tc-grupo-4/TP--FINAL/README.md

# TP--FINAL
TP FINAL de Teoría de Circuitos 2c 2019
