tc-grupo-4/TP--FINAL/Informe/2-sintesis.tex

\chapter{Síntesis de las Etapas}

Para las etapas de pasa altos, se utilizaron filtros KHN y para las etapas de pasa bajos se utilizaron filtros Sallen-Key.

¿Criterio para la síntesis de cada etapa?

¿Criterio para el orden de las etapas?

\section{Pasa Altos KHN}

\begin{figure}[ht]
\begin{center}
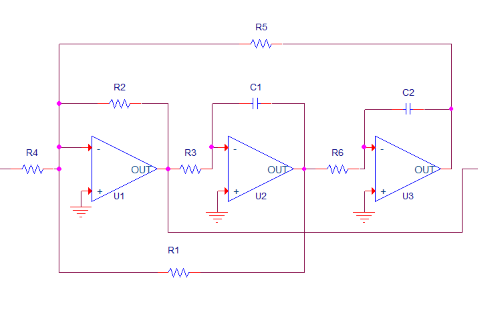
[picture p8: Diseño/publish/Stages Schematics/KHN_HP.PNG]

\caption{Arquitectura del Filtro KHN Pasa Altos}
\end{center}
\end{figure}

\section{Pasa Bajos Sallen-Key}

\begin{figure}[ht]
\begin{center}
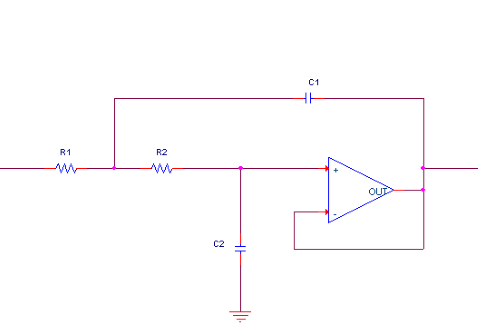
[picture p9: Diseño/publish/Stages Schematics/SK_LP.PNG]

\caption{Arquitectura del Filtro Sallen-Key Pasa Bajos}
\end{center}
\end{figure}
