tc-grupo-4/TP--FINAL/Informe/Caratula.tex

%\documentclass[12pt,a4paper]{article}
%\usepackage[utf8]{inputenc}
%\usepackage[siunitx,american]{circuitikz}
%\usepackage{pgfplots}
%\usepackage[margin=0.5in]{geometry}
%\usepackage{textcomp}
%\usepackage[spanish, es-tabla]{babel}
%\usepackage{amsmath}
%\usepackage{graphicx}
%\usepackage[colorinlistoftodos]{todonotes}
%\usepackage{amsmath}
%\usepackage{tikz}
%%%

%\usepackage{parskip}
%\usepackage{fancyhdr}
%\usepackage{vmargin}
%\setmarginsrb{3 cm}{2.5 cm}{3 cm}{2.5 cm}{1 cm}{1.5 cm}{1 cm}{1.5 cm}

%\pgfplotsset{compat=1.15}

%\begin{document}

\begin{titlepage}
\newcommand{\HRule}{\rule{\linewidth}{0.5mm}} % Defines a new command for the horizontal lines, change thickness here

\center
% Center everything on the page
 %----------------------------------------------------------------------------------------
%	LOGO SECTION
%----------------------------------------------------------------------------------------

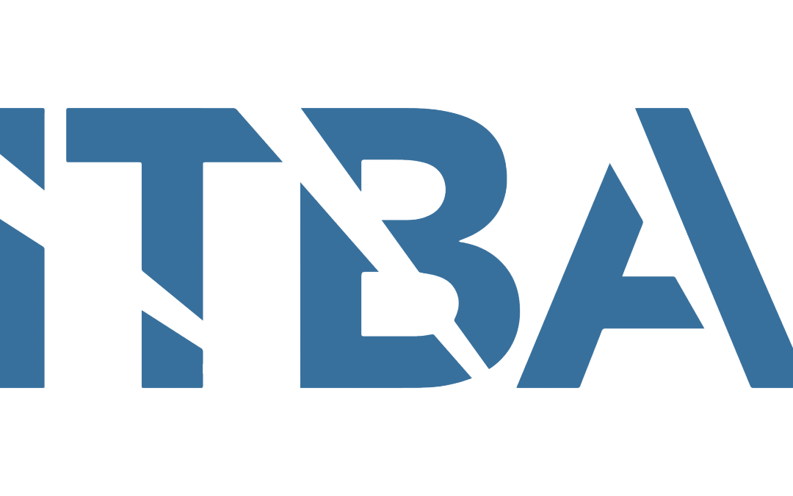
[picture p10: Informe/Resources/itba.png]
\\[1cm] % Include a department/university logo - this will require the graphicx package
 
%----------------------------------------------------------------------------------------
%----------------------------------------------------------------------------------------
%	HEADING SECTIONS
%----------------------------------------------------------------------------------------

\textsc{\Large INSTITUTO TECNOLÓGICO \\DE \\[0.3cm]BUENOS AIRES }\\[0.6cm] % Name of your university/college

\textsc{\Large Ingeniería Electrónica }\\[0.3cm]
\textsc{\large 22.01 - Teoría de Circuitos}\\[0.5cm] % Major heading such as course name
 % Minor heading such as course title

%----------------------------------------------------------------------------------------
%	TITLE SECTION
%----------------------------------------------------------------------------------------

\HRule \\[0.4cm]
{ \huge \bfseries TRABAJO PRÁCTICO FINAL\\ [0.3cm]}

\HRule \\[1.5cm]

%----------------------------------------------------------------------------------------
%	AUTHOR SECTION
%----------------------------------------------------------------------------------------

\begin{minipage}{0.4\textwidth}
\begin{flushleft} \large
\emph{Grupo 4:}\\
Álvarez, Lisandro \\Fogg, Matias\\ Diaz, Ian\\Delgado, Milton\\Dieguez, Manuel\\Oh, Victor % Your name
\end{flushleft}
\end{minipage}
~
\begin{minipage}{0.4\textwidth}
\begin{flushright} \large
\emph{Legajos:} \\
57771\\56252\\57515\\56451\\56273\\56679 
\end{flushright}
\end{minipage}\\[1cm]

 \begin{flushleft}
\textsc{\large Aprobado en fecha:  \dotfill}\\[0.5cm] 

% If you don't want a supervisor, uncomment the two lines below and remove the section above
%\Large \emph{Author:}\\
%John \textsc{Smith}\\[3cm] % Your name

%----------------------------------------------------------------------------------------
%	DATE SECTION
%----------------------------------------------------------------------------------------
\textsc{\large Entregado el \today}\\
% Date, change the \today to a set date if you want to be precise
 \end{flushleft}

\vfill % Fill the rest of the page with whitespace

\end{titlepage}

%\end{document}
