tc-grupo-4/TP--FINAL/Informe/TP_FINAL_G4.tex

\input{preamble.tex}

\begin{document}

\input{Caratula.tex}
\tableofcontents

\input{0-consigna.tex}

\input{1-diseno.tex}

\input{2-sintesis.tex}
\input{3-sensibilidad.tex}
\input{4-pcb.tex}
\input{5-resultados.tex}
\input{6-rangodinamico.tex}
\input{7-carga.tex}
\input{8-estabilidad.tex}

\end{document}
