tc-grupo-4/TP--FINAL/Diseño/publish/Publication.html

- Credits

# SUMMARY OF FILTER

# by Analog Filter Pro

# Bandpass Chebyshev I

# Filter Characteristics



Filter Properties
Gain [dB] | Fa⁻ [Hz] | Fp⁻ [Hz] | Fp⁺ [Hz] | Fa⁺ [Hz] | Aa [dB] | Ap [dB] | Order
5.000000e-01 | 615 | 2.07k | 12.07k | 40.62k | 50 | 5.000000e-01 | 4

# Attenuation Plot:



# Gain Plot:

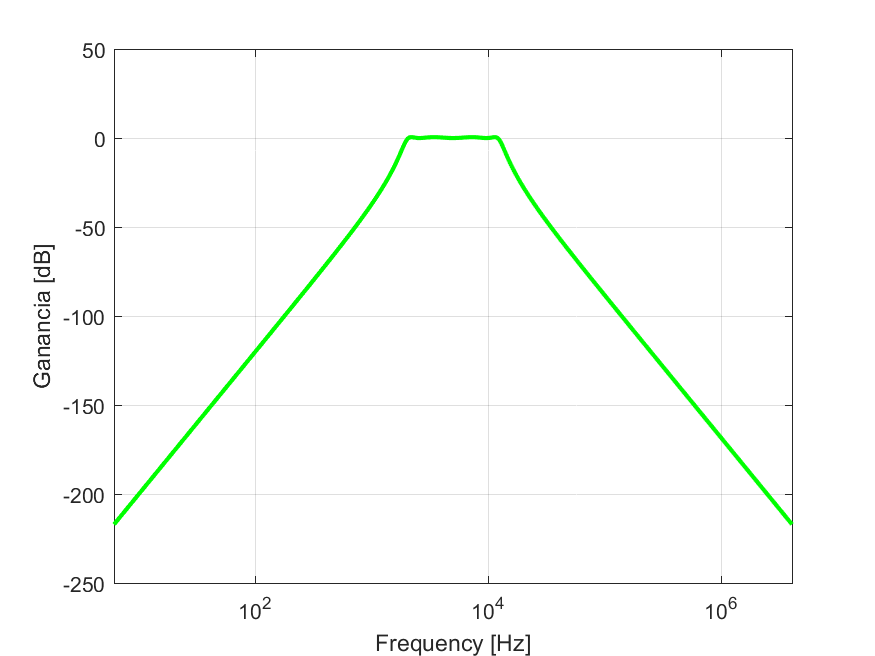
[picture p11: Diseño/publish/Filter_Mag.png]


# Phase Plot:



# Group Delay:

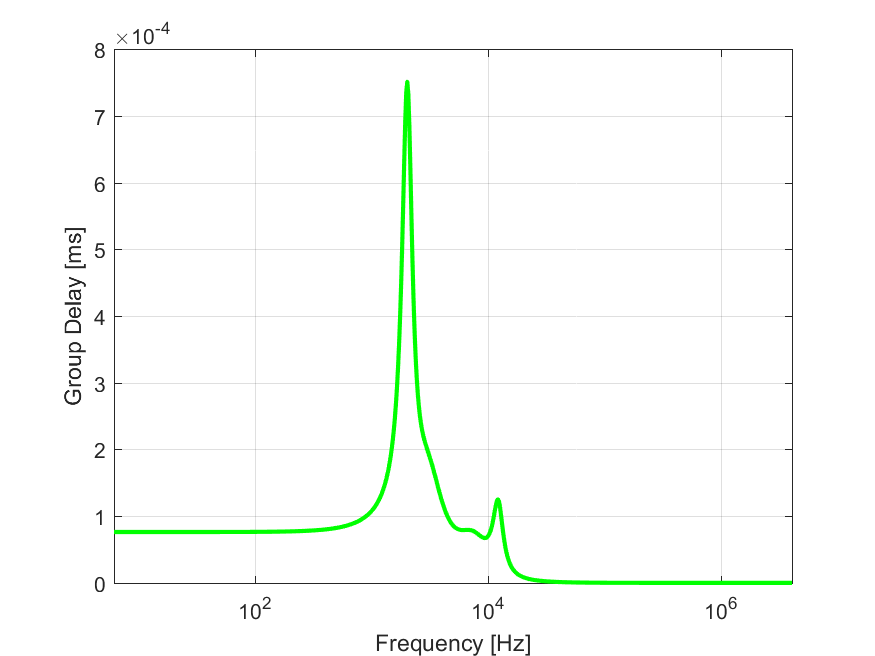
[picture p12: Diseño/publish/Filter_GroupDelay.png]


# Step Response:

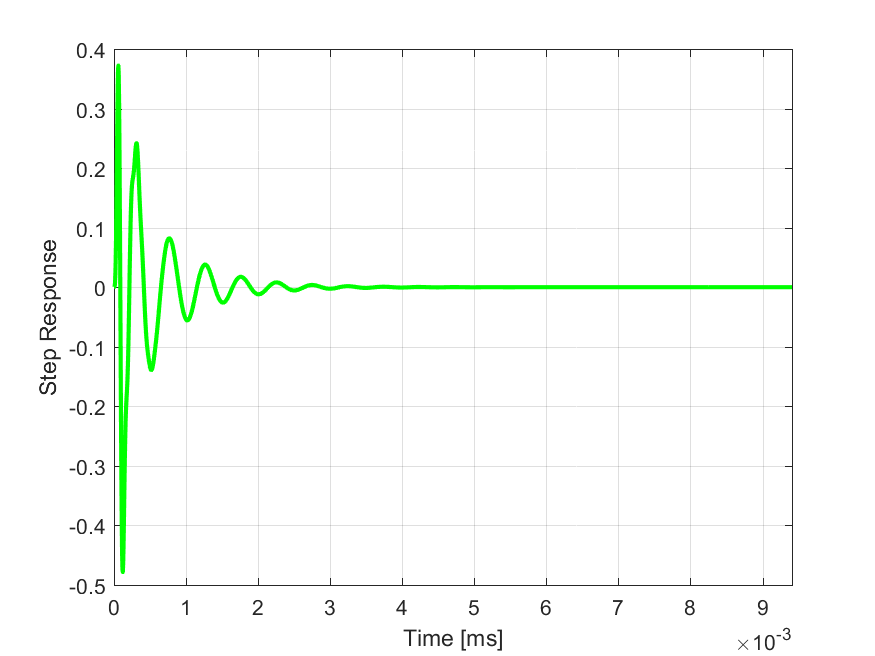
[picture p13: Diseño/publish/Filter_StepResponse.png]


# Impulse Response:

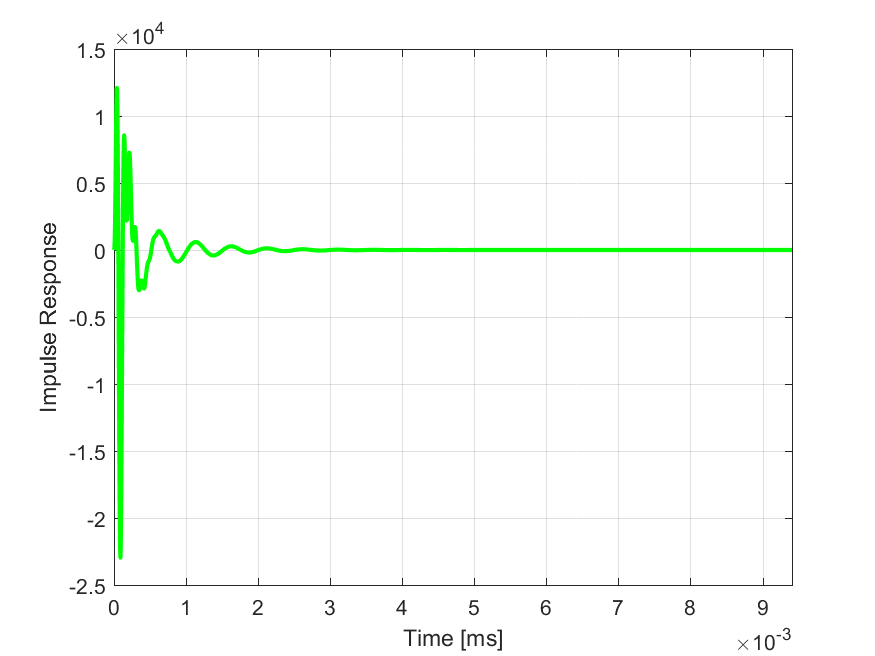
[picture p14: Diseño/publish/Filter_ImpulseResponse.png]


# Stage Nº1: KHN High Pass



Stage Properties
Type | Order | f0 [Hz] | Gain [dB] | Q | Dinamic Range [dB]
HighPass | 2 | 2k | 2 | 4.08

# Stage Attenuation:



# Calculated components for the specified filter:

Components
Resistor [Ω] | | | | | | Capacitor [F]
R1 | R2 | R3 | R4 | R5 | R6 | C1 | C2
781.55 | 191.51 | 90.3M | 100k | 781.55 | 90.3M | 100n | 100n

# Approximation of the components with commercial values:

Components with commercial values
| | Combination | Result | Error

Resistor
| R1 | 100Ω + 680Ω | 780Ω | 0.2%
| R2 | 220Ω // 1.5kΩ | 191.86Ω | 0.2%
| R3 | 2.2MΩ + 2.2MΩ | 4.4MΩ | 95.1%
| R4 | 100kΩ | 100kΩ | 0.0%
| R5 | 100Ω + 680Ω | 780Ω | 0.2%
| R6 | 2.2MΩ + 2.2MΩ | 4.4MΩ | 95.1%

Capacitor
| C1 | 100nF | 100nF | 0.0%
| C2 | 100nF | 100nF | 0.0%

# Sensitivity of each component:

Sensitivities
| SXG | SXQ | SXWp
R1 | 0.50 | 1.50 | -0.50
R2 | 0.00 | -1.00 | 0.00
R3 | -0.50 | 0.00 | 0.00
R4 | 0.50 | 0.00 | 0.00
R5 | 0.50 | -0.50 | -0.50
R6 | -0.50 | 0.00 | 0.00
C1 | 0.00 | 0.00 | -0.50
C2 | 0.00 | -0.50 | -0.50

# Stage Nº2: KHN High Pass



Stage Properties
Type | Order | f0 [Hz] | Gain [dB] | Q | Dinamic Range [dB]
HighPass | 2 | 12.3k | 2 | 4.08

# Stage Attenuation:



# Calculated components for the specified filter:

Components
Resistor [Ω] | | | | | | Capacitor [F]
R1 | R2 | R3 | R4 | R5 | R6 | C1 | C2
129.65 | 31.77 | 221.7M | 100k | 129.65 | 221.7M | 100n | 100n

# Approximation of the components with commercial values:

Components with commercial values
| | Combination | Result | Error

Resistor
| R1 | 10Ω + 120Ω | 130Ω | 0.3%
| R2 | 33Ω // 820Ω | 31.72Ω | 0.1%
| R3 | 2.2MΩ + 2.2MΩ | 4.4MΩ | 98.0%
| R4 | 100kΩ | 100kΩ | 0.0%
| R5 | 10Ω + 120Ω | 130Ω | 0.3%
| R6 | 2.2MΩ + 2.2MΩ | 4.4MΩ | 98.0%

Capacitor
| C1 | 100nF | 100nF | 0.0%
| C2 | 100nF | 100nF | 0.0%

# Sensitivity of each component:

Sensitivities
| SXG | SXQ | SXWp
R1 | 0.50 | 1.50 | -0.50
R2 | 0.00 | -1.00 | 0.00
R3 | -0.50 | 0.00 | 0.00
R4 | 0.50 | 0.00 | 0.00
R5 | 0.50 | -0.50 | -0.50
R6 | -0.50 | 0.00 | 0.00
C1 | 0.00 | 0.00 | -0.50
C2 | 0.00 | -0.50 | -0.50

# Stage Nº3: SK Low Pass

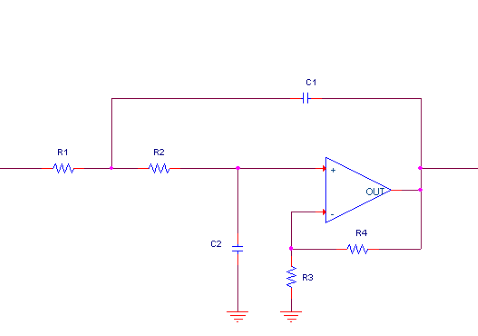
[picture p15: Diseño/publish/Stages Schematics/SK_LP_G.PNG]


Stage Properties
Type | Order | f0 [Hz] | Gain [dB] | Q | Dinamic Range [dB]
LowPass | 2 | 3.2k | 2 | 1.30

# Stage Attenuation:



# Calculated components for the specified filter:

Components
Resistor [Ω] | | | | Capacitor [F]
R1 | R2 | R3 | R4 | C1 | C2
100k | 100k | 1k | 569.32 | 651.56p | 376.16p

# Approximation of the components with commercial values:

Components with commercial values
| | Combination | Result | Error

Resistor
| R1 | 100kΩ | 100kΩ | 0.0%
| R2 | 100kΩ | 100kΩ | 0.0%
| R3 | 1kΩ | 1kΩ | 0.0%
| R4 | 10Ω + 560Ω | 570Ω | 0.1%

Capacitor
| C1 | 680pF + 15nF | 650.51pF | 0.2%
| C2 | 390pF + 10nF | 375.36pF | 0.2%

# Sensitivity of each component:

Sensitivities
| SXG | SXQ | SXWp
R1 | 0.00 | 0.49 | -0.50
R2 | 0.00 | -0.49 | -0.50
R3 | -0.36 | -0.97 | 0.00
R4 | 0.36 | 0.97 | 0.00
C1 | 0.00 | 1.47 | -0.50
C2 | 0.00 | -1.47 | -0.50

# Stage Nº4: SK Low Pass



Stage Properties
Type | Order | f0 [Hz] | Gain [dB] | Q | Dinamic Range [dB]
LowPass | 2 | 7.8k | 2 | 1.30 | 54.3

# Stage Attenuation:



# Calculated components for the specified filter:

Components
Resistor [Ω] | | | | Capacitor [F]
R1 | R2 | R3 | R4 | C1 | C2
100k | 100k | 1k | 569.32 | 269.37p | 155.51p

# Approximation of the components with commercial values:

Components with commercial values
| | Combination | Result | Error

Resistor
| R1 | 100kΩ | 100kΩ | 0.0%
| R2 | 100kΩ | 100kΩ | 0.0%
| R3 | 1kΩ | 1kΩ | 0.0%
| R4 | 10Ω + 560Ω | 570Ω | 0.1%

Capacitor
| C1 | 270pF + 120nF | 269.39pF | <0,1%
| C2 | 5.6pF // 150pF | 155.6pF | <0,1%

# Sensitivity of each component:

Sensitivities
| SXG | SXQ | SXWp
R1 | 0.00 | 0.49 | -0.50
R2 | 0.00 | -0.49 | -0.50
R3 | -0.36 | -0.97 | 0.00
R4 | 0.36 | 0.97 | 0.00
C1 | 0.00 | 1.47 | -0.50
C2 | 0.00 | -1.47 | -0.50
