tc-grupo-4/TP--FINAL/Informe/0-consigna.tex

\chapter*{Introducción y Objetivo }

Se buscó implementar un filtro analógico que cumpliera con las especificaciones detalladas en la Tabla \ref{tab:specs}. Además, también se buscó en el proceso maximizar la \textit{SNR} total de la placa.

\begin{table}[ht]
\begin{center}
\begin{tabular}{||c|c||}
\hline
Aproximación	&	Chebycheff I	\\
\hline
\hline
$f_0$	&	$5 \si{\kilo\hertz}$	\\
\hline
$Q$	&	$0.5$	\\
\hline
Selectividad	&	$4$	\\
\hline
$A_p$	&	$1 \si{\deci\bel}$	\\
\hline
$A_a$	&	$45 \si{\deci\bel}$	\\
\hline
Rango Dinámico	&	$45 \si{\deci\bel}$	\\
\hline
\end{tabular}
\caption{Especificaciones del Filtro Pasa Banda}
\label{tab:specs}
\end{center}
\end{table}
