tc-grupo-4/TP--FINAL/Informe/TP_FINAL_G4.pdf

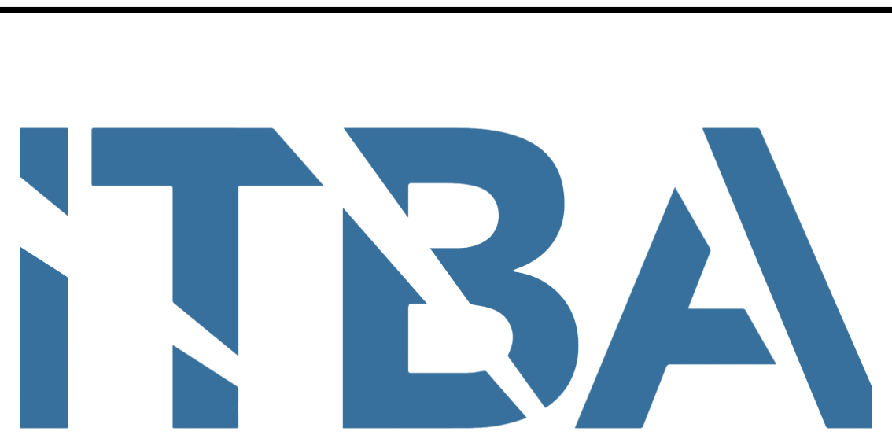
[picture p16: figure]

INSTITUTO TECNOLOGICO ´

DE

BUENOS AIRES

Ingeniería Electronica ´

22.01 - Teoría de Circuitos

# TRABAJO PRACTICO FINAL

´

### Grupo 4: Alvarez, Lisandro ´

### Fogg, Matias Diaz, Ian Delgado, Milton Dieguez, Manuel Oh, Victor

### Legajos:

57771
56252
57515
56451
56273
56679
Aprobado en fecha: |

Entregado el 19 de noviembre de 2019

´

# Indice general

1. Diseño Analítico | 3
2. Síntesis de las Etapas | 5
3. Sensibilidades | 7
4. Diseño del PCB | 8
5. Resultados Experimentales | 9
6. Rango Dinámico | 10
7. Carga del Sistema | 11
8. Estabilidad del Sistema | 12

1

# Introducción y Objetivo

Se buscó implementar un filtro analógico que cumpliera con las especificaciones detalladas en la Tabla 1. Además, también se buscó en el proceso maximizar la SNR total de la placa.

Aproximación | Chebycheff I
f0 | 5kHz
Q | 0.5
Selectividad | 4
Ap | 1dB
Aa | 45dB
Rango Dinámico | 45dB

Tabla 1: Especificaciones del Filtro Pasa Banda

2

# Parte 1 Diseño Analítico

A partir de las especificaciones de diseño de la Tabla 1, una vez ingresados en el software de diseño de filtros se obtuvo que este tendrá las características detalladas en la Tabla 1.1 y deberá cumplir con la plantilla en 1.1.

Ganancia | 0.5dB
− f a | 615Hz
− f p | 2.07kHz
+ f p | 12.07kHz
+ f a | 40.62kHz
Aa | 50dB
Ap | 0.5dB
Orden | 4

Tabla 1.1: Características del filtro pasa bandas diseñado

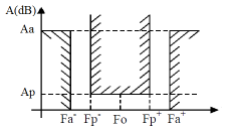
[picture p17: figure]

Figura 1.1: Plantilla del Filtro Pasa Bajos

Habiendo ingresado las especificaciones del filtro al software de diseño de filtros y de separación de etapas, el filtro fue finalmente implementado utilizando dos etapas pasa altos de segundo orden y dos etapas pasa bajos de segundo orden en cascada.

3

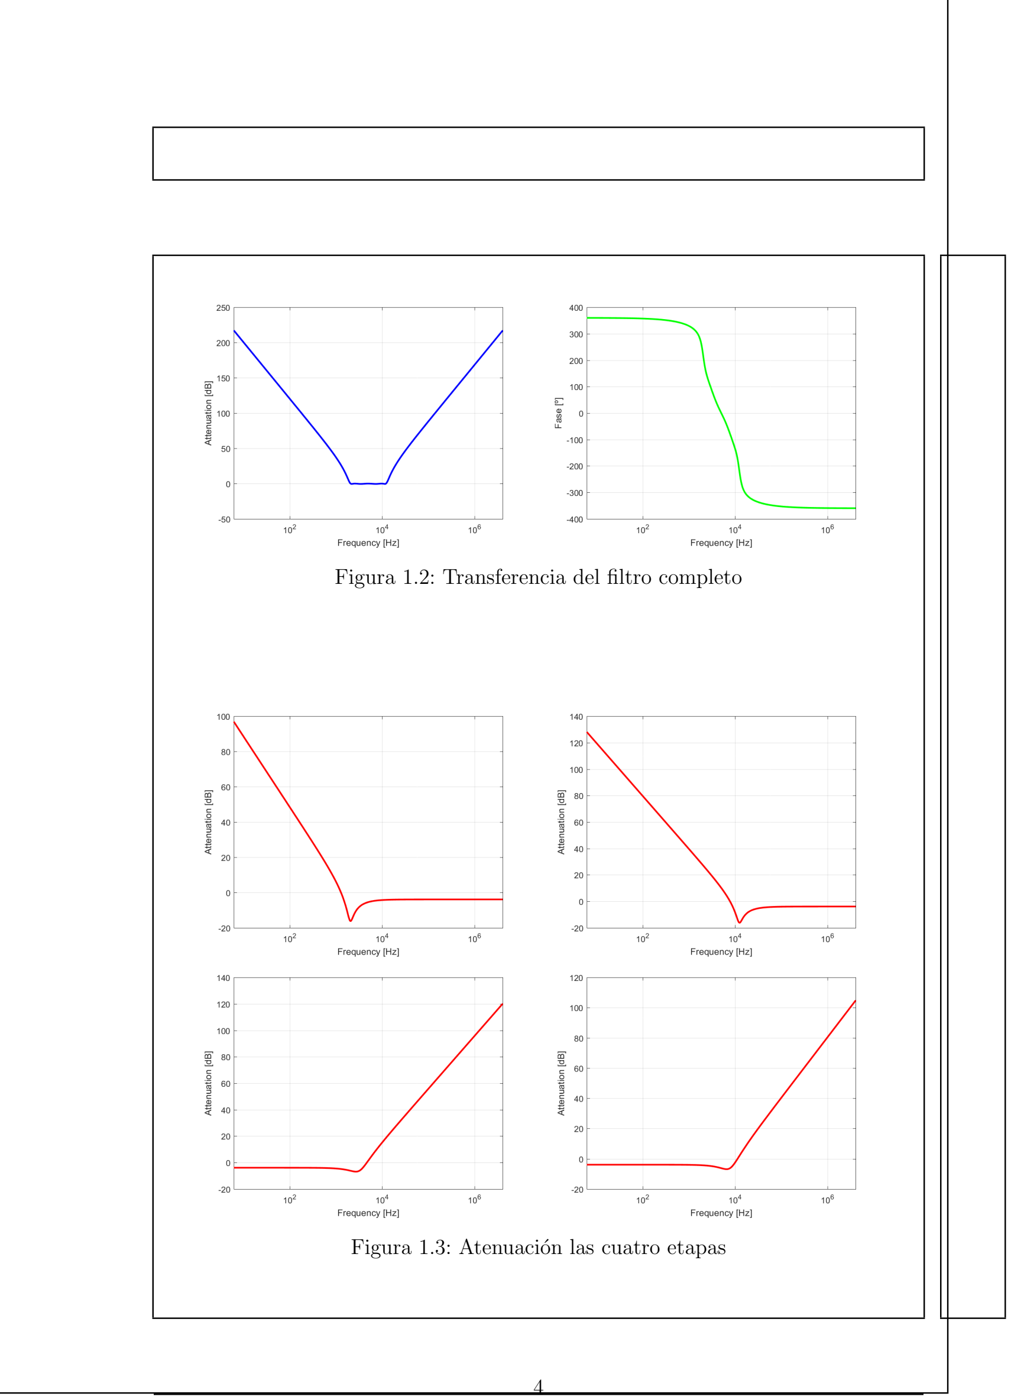
[picture p18: page 5]

Figura 1.2: Transferencia del filtro completo

Figura 1.3: Atenuación las cuatro etapas

4

# Parte 2 Síntesis de las Etapas

Para las etapas de pasa altos, se utilizaron filtros KHN y para las etapas de pasa bajos se utilizaron filtros Sallen-Key.
¿Criterio para la síntesis de cada etapa?
¿Criterio para el orden de las etapas?

## 2.1. Filtro KHN

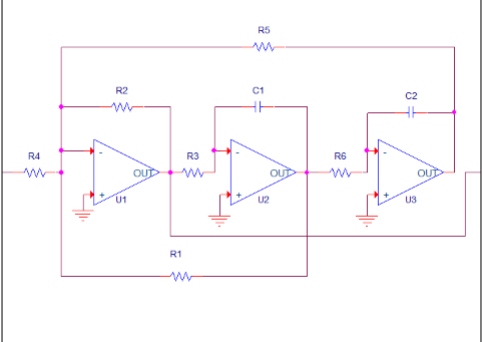
[picture p19: figure]

Figura 2.1: Arquitectura del Filtro KHN Pasa Altos

5

## 2.2. Filtro Sallen-Key

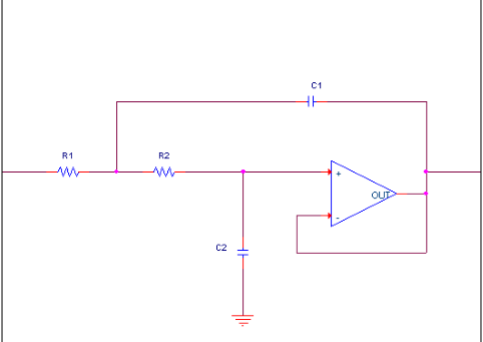
[picture p20: figure]

Figura 2.2: Arquitectura del Filtro Sallen-Key Pasa Bajos

6

# Parte 3 Sensibilidades

7

# Parte 4 Diseño del PCB

8

# Parte 5 Resultados Experimentales

9

# Parte 6 Rango Dinámico

10

# Parte 7 Carga del Sistema

11

# Parte 8 Estabilidad del Sistema

12
