tc-grupo-4/TP--FINAL/TPs Viejos/Filtro Final - Grupo Malu/tc_tpfinal_caratula.tex

\begin{titlepage}
\newcommand{\HRule}{\rule{\linewidth}{0.5mm}}
\center
\mbox{\textsc{\LARGE \bfseries {Instituto Tecnol\'ogico de Buenos Aires}}}\\[1.5cm]
\textsc{\Large 22.01 Teor\'ia de circuitos}\\[0.5cm]

\HRule \\[0.6cm]
{ \Huge \bfseries Trabajo pr\'actico Final: \\ Filtro Pasabandas}\\[0.4cm] % Title of your document
\HRule \\[1.5cm]

{\large

\emph{Grupo 4}\\
\vspace{3px}

\begin{tabular}{lr} 	
\textsc{Gonz\'alez Orlando}, Tom\'as Agust\'in  & 57090 \\
\textsc{Parra}, Roc\'io  & 57669 \\ 	
\textsc{Pierdominici}, Mat\'ias Nicol\'as & 57498 \\
\textsc{Stewart Harris}, Mar\'ia Luz  & 57676 \\ 	     
\end{tabular}

\vspace{20px}

\emph{Profesores}\\
\vspace{3px}
\textsc{Jacoby,} Daniel Andr\'es\\ 	
\textsc{Iribarren,} Rodrigo I\~naki\\
\textsc{Belaustegui Goitia,} Carlos \\

\vspace{100px}

\begin{tabular}{ll}

Presentado: & 27/11/2018\\

\end{tabular}

}

\vfill

\end{titlepage}
