tc-grupo-4/TP--FINAL/TPs Viejos/TP Final - Grupo Marce/CaratulaTP7.pdf

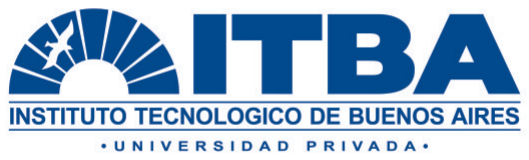
[picture p22: figure]

Instituto Tecnológico de Buenos Aires

27 de Noviembre 2018

FILTRO PASA ALTOS
Trabajo de Laboratorio Final

# Teoría de Circuitos

Grupo 1

Nombre | Legajo
Ariel Nowik | 58309
Joaquín Mestanza | 58288
Marcelo Regueira | 58300
Martina Máspero | 57120
