tc-grupo-4/TP--FINAL/TPs Viejos/TP Filtro Final - Grupo Rama/filtro_final.pdf

*spanishcaptions [unicode, charset=utf8, fontenc=EU1 EU2] spanishstringprocess BibliografÃaCapÃtuloAppendixApÃ
c ndiceList of Fig-uresÃndice de gurasList of TablesÃndice de cuadrosIndexÃndice alfabÃ

c ticopÃ½ginavÃ

c asevÃ
c ase
tambiÃ

c nDemostraciÃ³nContentsndice
*spanishcaptions
spanishstringprocess PrefacioReferencesReferenciasAbstractResumenBibliografía-CapítuloAppendixApéndiceList of FiguresÍndice de gurasList of TablesÍndice
de cuadrosIndexÍndice alfabéticoFigureFiguraTableCuadroPartParteAdjuntoCopia
aApáginavéasevéase tambiénDemostraciónGlosarioContentsÍndice *spanishdate month1nameenero,febrero,marzo,abril,mayo,junio,julio,agosto,septiembre,octubre,noviembre,diciembre ucmonth1nameEnero,Febrero,Marzo,Abril,Mayo,Junio,Julio,Agosto,Septiembre,Octubre,Noviembre,Diciembre December 1, 2017

## Instituto Tecnológico de Buenos Aires

Teoría de los Circuitos 2017

Trabajo Práctico de Laboratorio Final

## Filtro Final

Integrantes:

Gonzalo Reina Kiperman
Ignacio Dominguez

### Facundo Mateos

Ramiro Merello

56102
56442
56452
56622

30/11/2017

## Contents

1. Introducción | 2
2. Diseño Teórico Rechaza Banda | 2
3. Orden De Las Etapas | 6
4. Grácos de Curvas Teóricas | 7
5. Simulaciones y análisis de montecarlo | 9
6. Consideraciones Prácticas del Diseño del Circuito Impreso(PCB) | 12
7. Mediciones y resultados | 13
8. Análisis de Costos de Componentes | 16
9. Conclusión | 16

## 1. Introducción

Este trabajo aborda el diseño de un ltro de tipo rechaza banda, incluye el diseño teórico para la obtención de las diferentes etapas, el posterior ordenamiento de las etapas, los grácos de curvas teóricos y acumulativos para cada etapa, consideración de realización de PCB y por último un análisis de costos de componentes.

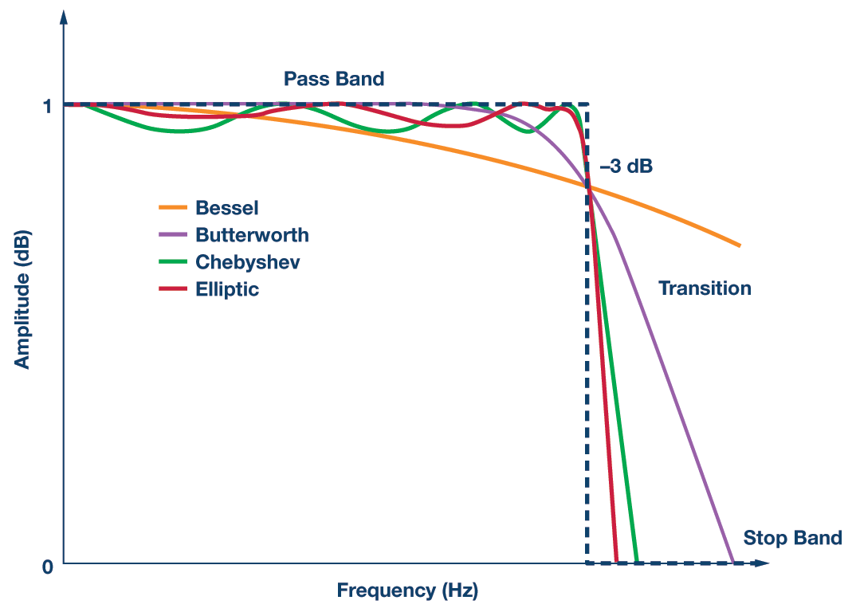
[picture p23: figure]

Figure 1: Ejemplo de Distintas Aproximaciones para Filtros

## 2. Diseño Teórico Rechaza Banda

La plantilla de diseño es de una selectividad considerable, resulta de esta forma necesario emplear la aproximación de Cauer para minimizar el orden. Para lograr minimizar el orden la aproximación agrega ripple tanto en banda pasante como en banda atenuante.

Aproximación | Cauer
Ap | 2 dB
Aa | 45 dB
− f p | 600 Hz
− f a | 800 Hz
+ f a | 2300 Hz
f p + | 3000 Hz
Notch depth | 55 dB
Orden | 8
Aproximación | Cauer
Ap | 0.4 dB
Aa | 52.9 dB
− f p | 600 Hz
− f a | 800 Hz
+ f a | 2300 Hz
f p + | 3000 Hz
Gain | -0.2 dB
Notch depth | 55 dB
Orden | 10

Table 1: Requisito de Diseño Teórico y Prácticos Respectivamente

Si se observa el cuadro 1 se puede notar una diferencia en orden entre la plantilla teórica y práctica esto se debo a la necesidad de dejar margen en diseño debido a la tolerancia de los componentes.

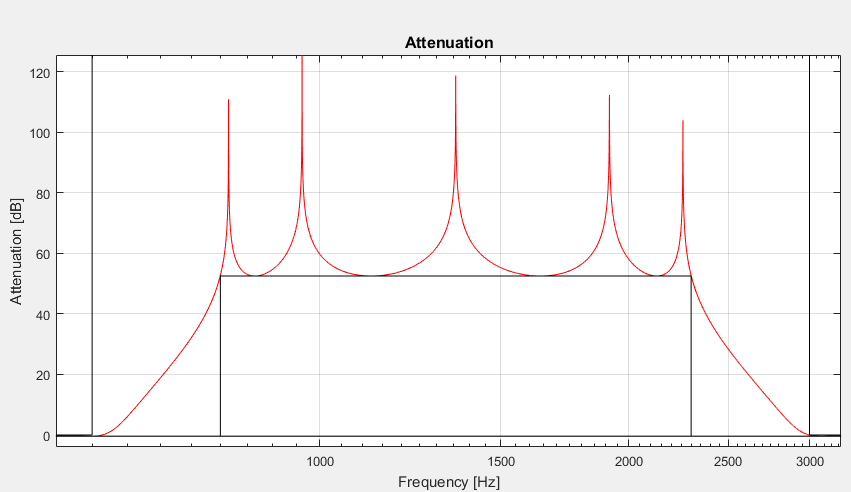
[picture p24: figure]

Figure 2: Gráco Teórico de Atenuación del Filtro a Realizar

2.1. Polos y Ceros De La Función Transferencia

Empleando el trabajo práctico cuatro de la materia, se calculó la transferencias del ltro resultante obteniendo de esta forma los polos y ceros de los cuadros 2 y 3

Frecuencia de Corte Polo | Factor de Calidad Q | Grado
623,51 Hz | 8,64 | 2
520,98 Hz | 1.62 | 2
2951,03 Hz | 8,64 | 2
368,32 Hz | 0,50 | 1
4995,60 Hz | 0,50 | 1

Table 2: Frecuencia de Polos Resultantes

Frecuencia de Cero Transmisión 814,54 Hz
960,67 Hz
1356,47 Hz
1915,33 Hz
2258,94 Hz

Table 3: Frecuencia de Ceros de Transmisión Resultantes

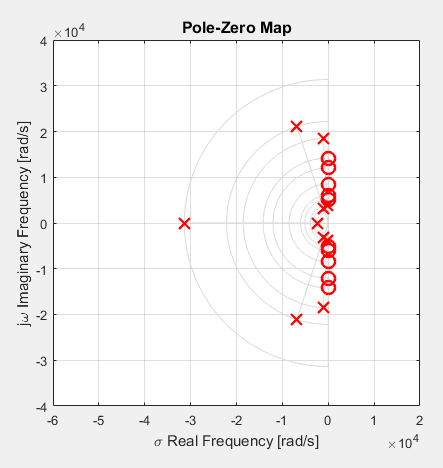
[picture p25: figure]

Figure 3: Diagrama de Polos y Ceros de Filtro

Si observamos la gura 3 veremos la presencia de ceros de transmisión, estos se deben a la aproximación Cauer, que fue empleada para hacer que el ltro cumpla la plantilla, esta aproximación agrega el ripple en las bandas pasante y atenuante mediante los ceros de transmisión. Esto será un factor central en la decisión de que celdas emplear para la realización en la siguiente subsección

2.2. Elección Celdas a Emplear

La aproximación de ltro empleada para el diseño requiere que cada celda cuente con un par de ceros de transmisión y un par de polos conjugados o reales. Esto reduce signicativamente las posibles celdas a utilizar, dejando como posibles celdas a emplear:

Celda Rauch

Celda Sedra

Celda Akerberg-Mossberg

Celda Flescher-Tow

De las posibles celdas a emplear se optó por la celda Flescher Tow, que consiste en una celda universal con baja sensibilidad y la característica de poder realizar ajuste que dependan de menos componentes que otros celdas, a diferencia de por ejemplo la Sedra, esto permitió jar los valores de capacitores y agrupar solamente las resistencias simplicando considerablemente la materialización del PCB.

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

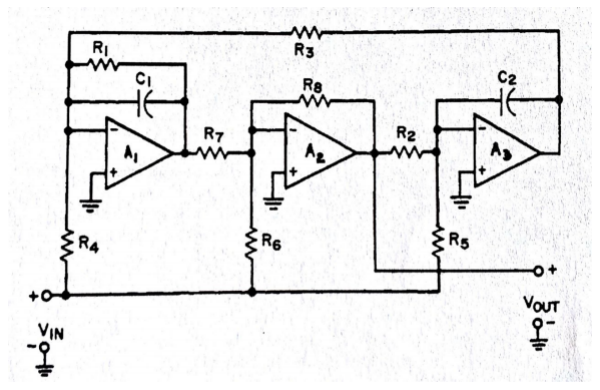
[picture p26: figure]

V4 = −

R2
R6

·

1 + C1·C2·RA·R3·R6
R5
- s

2

C1·C2·R2·R3·RA
RB
- s

2 + ·

C2·R2·R3·RA
R1·RB
- s + 1

= −K ·

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
Q·ω0
- s + 1

Donde

ω

2
0 =

RB
C1 · C2 · R2 · R3 · RA

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
R2 · R3

ω

2
1 =

R5
C1 · C2 · RA · R3 · R6

K =

R2
R6
2.4. Análisis de sensibilidades

Se procedió a realizar un análisis de sensibilidades para los componentes de la celda Flescher Tow.

| wp S x | Qp S x | wZ S x | QZ S x | G0 | G∞
R1 | 0 | 1 | 0 | R4R7 − R1R6−R4R7 | 0 | 0
R2 | -1 2 | -1 2 | 0 | 0 | 1 | 0
R3 | -1 2 | -1 2 | -1 2 | -1 2 | 0 | 0
R4 | 0 | 0 | 0 | − R1R6 R1R6−R4R7 | 0 | 0
R5 | 0 | 0 | 1 − 2 | 1 − 2 | -1 | 0
R6 | 0 | 0 | 1 2 | 1 2 | 0 | -1
R7 | − 1 2 | − 1 2 | − 1 2 | 1 2 | 0 | 0
R8 | 1 2 | 1 2 | 0 | 0 | 0 | 1
C1 | − 1 2 | 1 2 | − 1 2 | 1 2 | 0 | 0
C2 | − 1 2 | − 1 2 | − 1 2 | 1 -2 | 0 | 0

Table 4: Sensibilidades relativa de los valores del ltro en función de los parámetros del mismo

Se puede observar que la celda que se utilizó en general posee baja sensibilidad de sus parámetros.

## 3. Orden De Las Etapas

Se ordenaron las etapas para maximizar el rango dinámico del ltro, debido a que se trataba de un ltro con gran nivel de atenuación y cuatro notches se considero para alta señal. Por este motivo se ordenaron las etapas de polos de mayor factor de calidad (Q) a menor, buscando evitar que la señal caiga por debajo del piso del ruido.

Etapa | Cero de Transmisión | Polo | Q del Polo
#1 | 814,79 Hz | 623,77 Hz | 8,65

#2 | 2258,26 Hz | 2949,80 Hz | 8,65

#3 | 960,87 Hz | 521,24 Hz | 1,62

#4 | 1914,92 Hz | 3530,05 Hz | 1,62

#5 | 1356,47 Hz | 4991,88 Hz y 368,60 Hz | 0,50

Table 5: Orden de las Etapas Para Maximizar Orden

## 4. Grácos de Curvas Teóricas

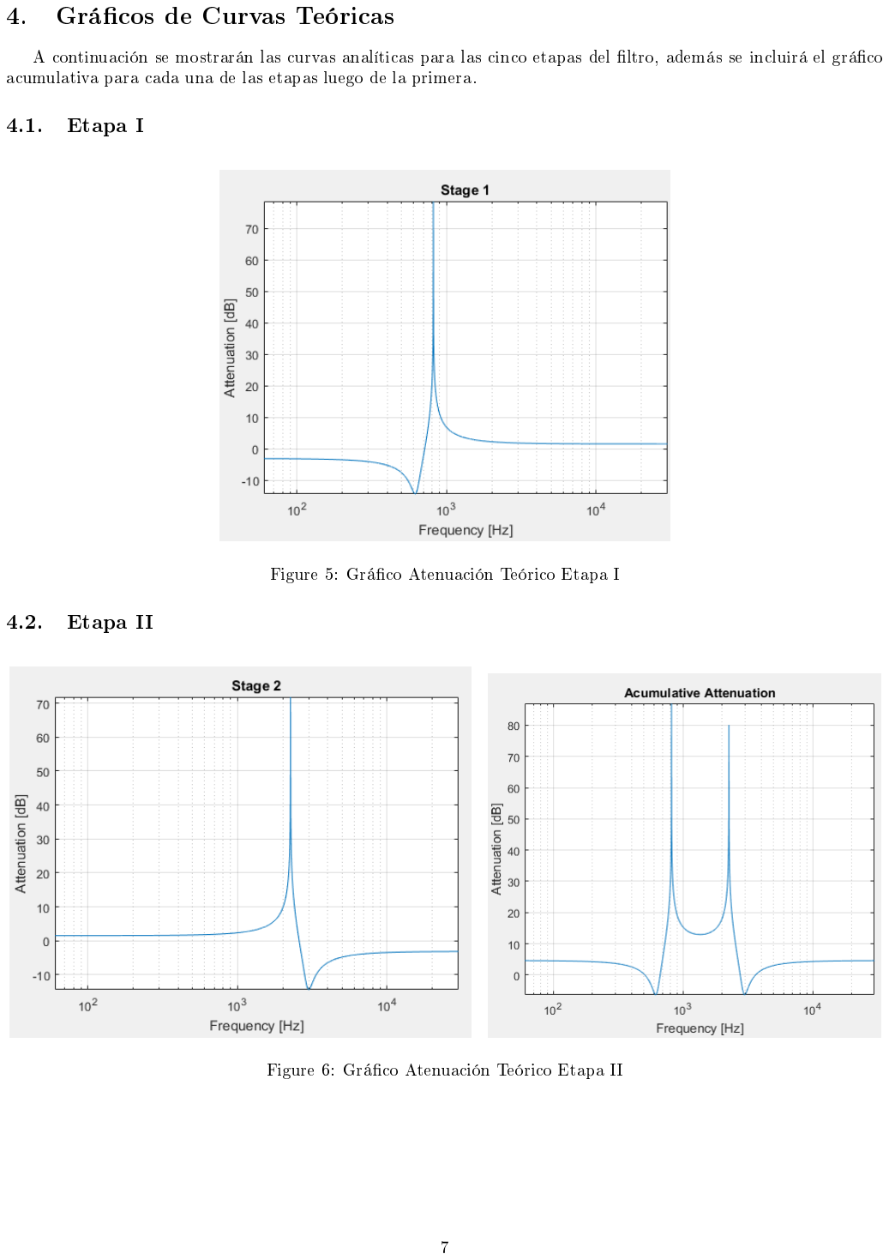
[picture p27: page 9]

A continuación se mostrarán las curvas analíticas para las cinco etapas del ltro, además se incluirá el gráco acumulativa para cada una de las etapas luego de la primera.

4.1. Etapa I

Figure 5: Gráco Atenuación Teórico Etapa I

4.2. Etapa II

Figure 6: Gráco Atenuación Teórico Etapa II

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

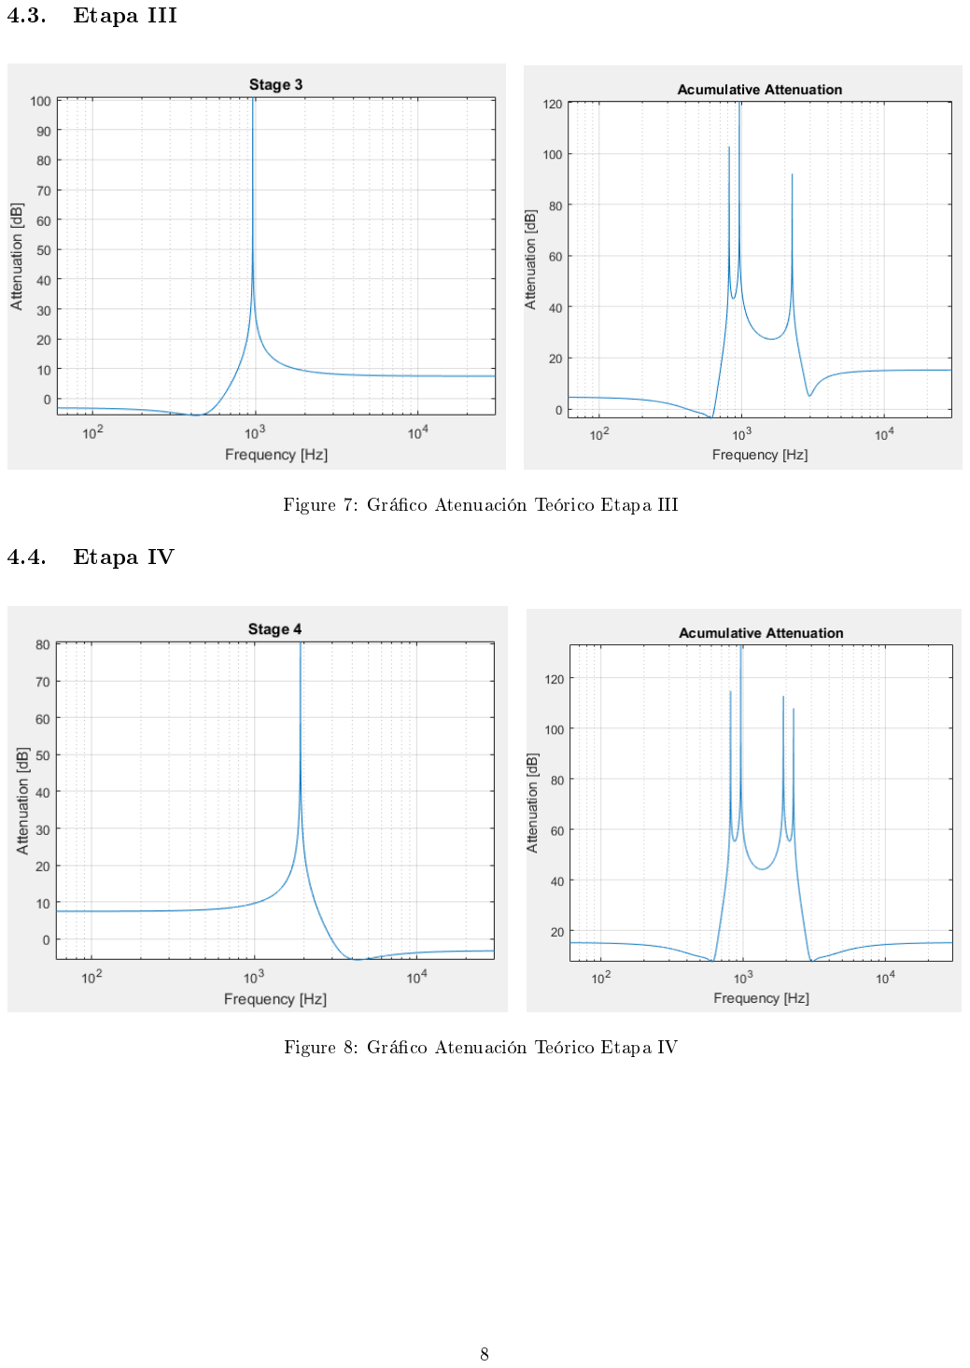
[picture p28: page 10]
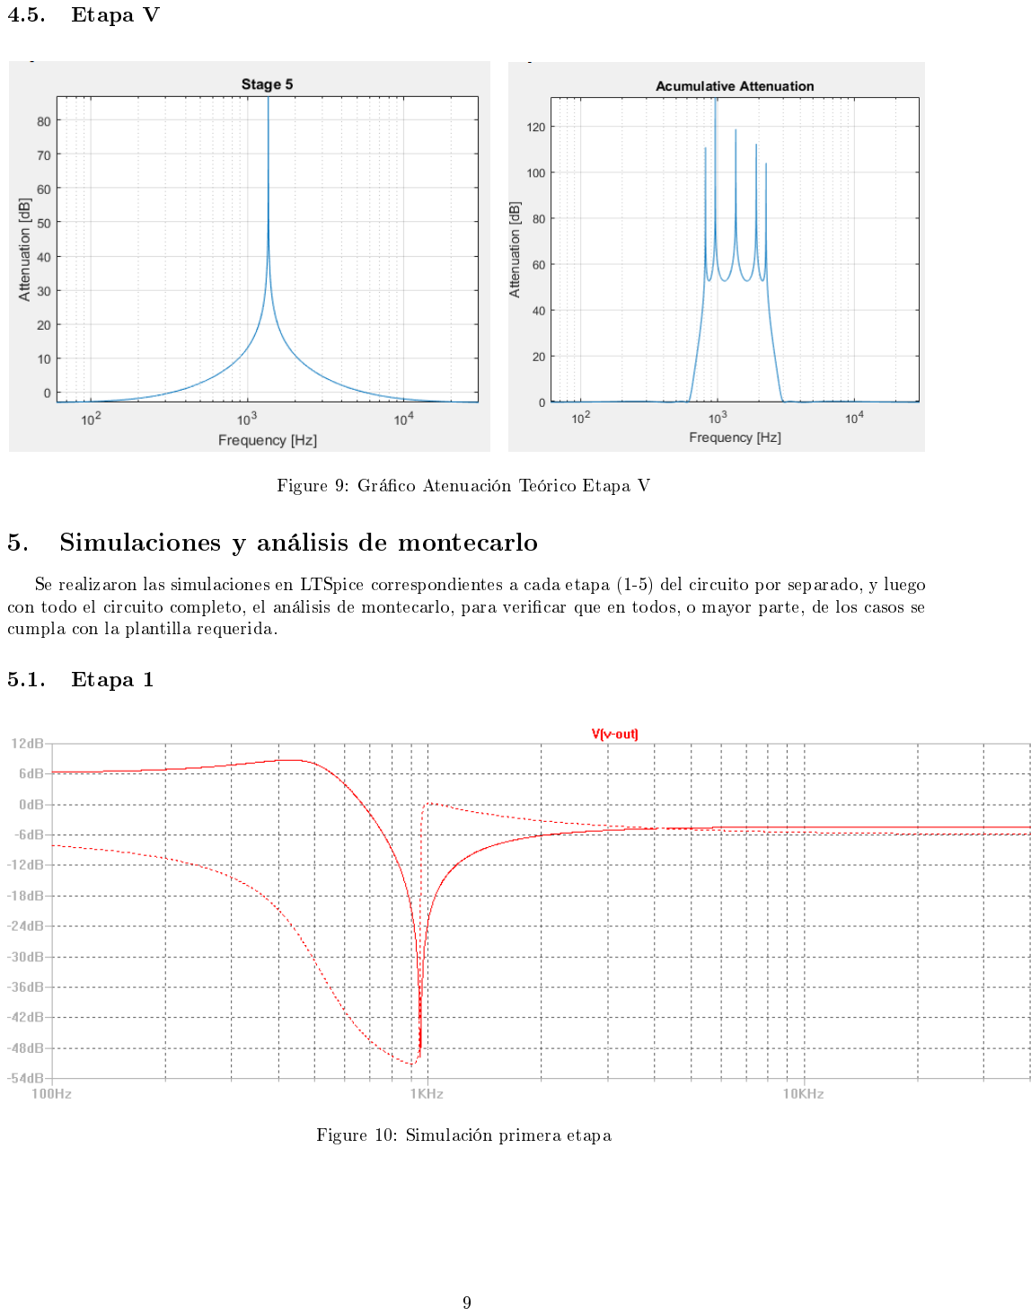
[picture p29: page 11]

4.5. Etapa V

Figure 9: Gráco Atenuación Teórico Etapa V

## 5. Simulaciones y análisis de montecarlo

Se realizaron las simulaciones en LTSpice correspondientes a cada etapa (1-5) del circuito por separado, y luego con todo el circuito completo, el análisis de montecarlo, para vericar que en todos, o mayor parte, de los casos se cumpla con la plantilla requerida.

5.1. Etapa 1

Figure 10: Simulación primera etapa

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

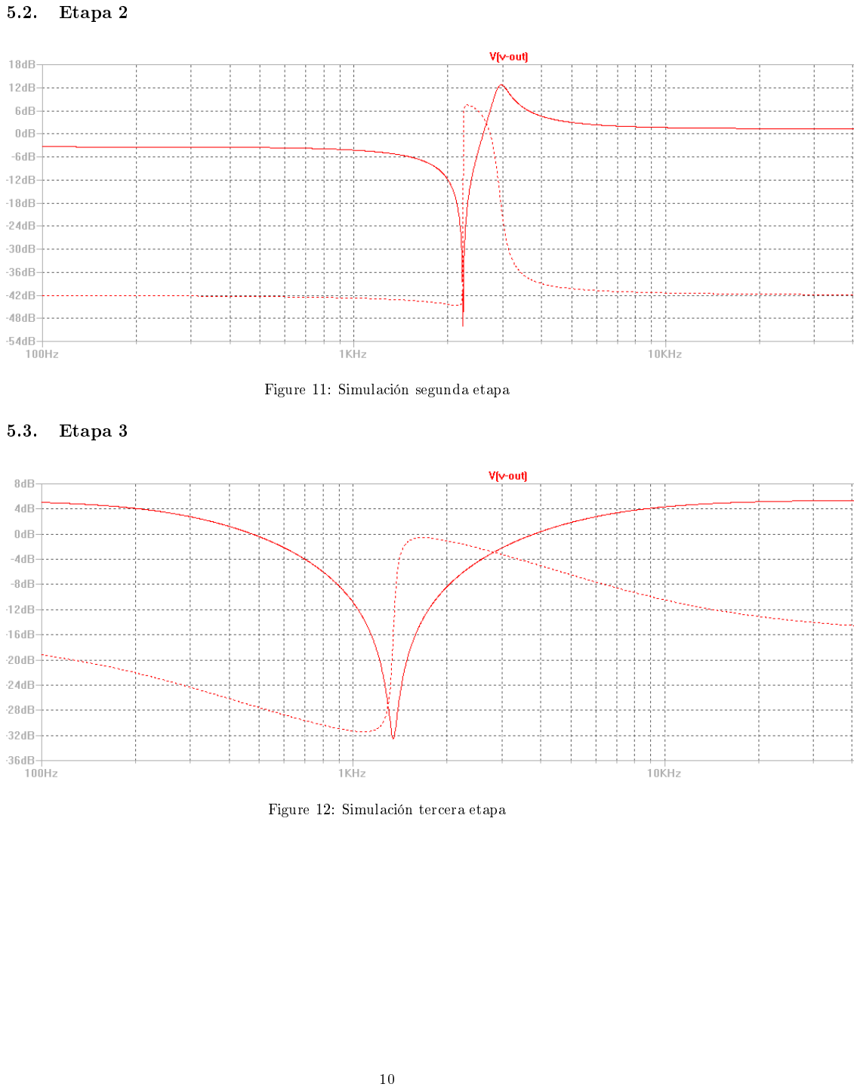
[picture p30: page 12]
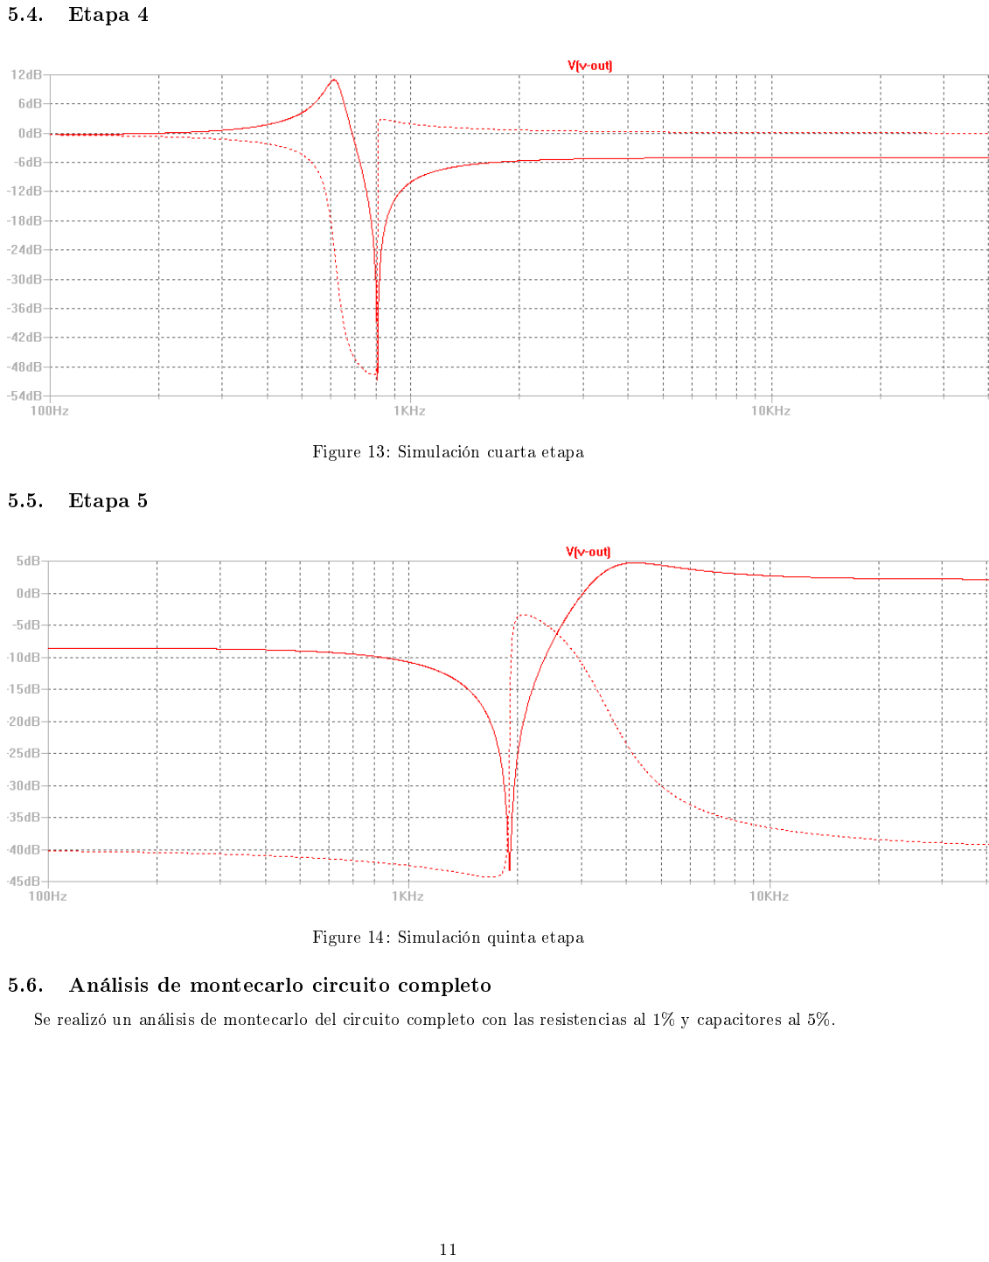
[picture p31: page 13]

5.4. Etapa 4

Figure 13: Simulación cuarta etapa

5.5. Etapa 5

Figure 14: Simulación quinta etapa

5.6. Análisis de montecarlo circuito completo

Se realizó un análisis de montecarlo del circuito completo con las resistencias al 1% y capacitores al 5%.

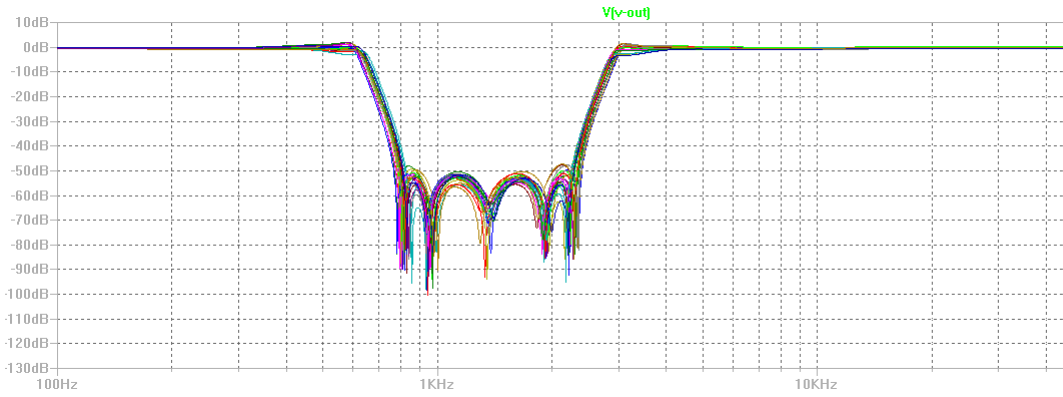
[picture p32: figure]

Figure 15: Simulación con análisis de montecarlo

## 6. Consideraciones Prácticas del Diseño del Circuito Impreso(PCB)

Para la realización del circuito impreso se divido en subetapas separadas por jumpers permitiendo agilizar la realización del esquemático, el rooteo de la placa, la medición de etapas y permitiendo una mayor exibilidad al diseño. El esquemático de la placa se puede ver en la gura 16.

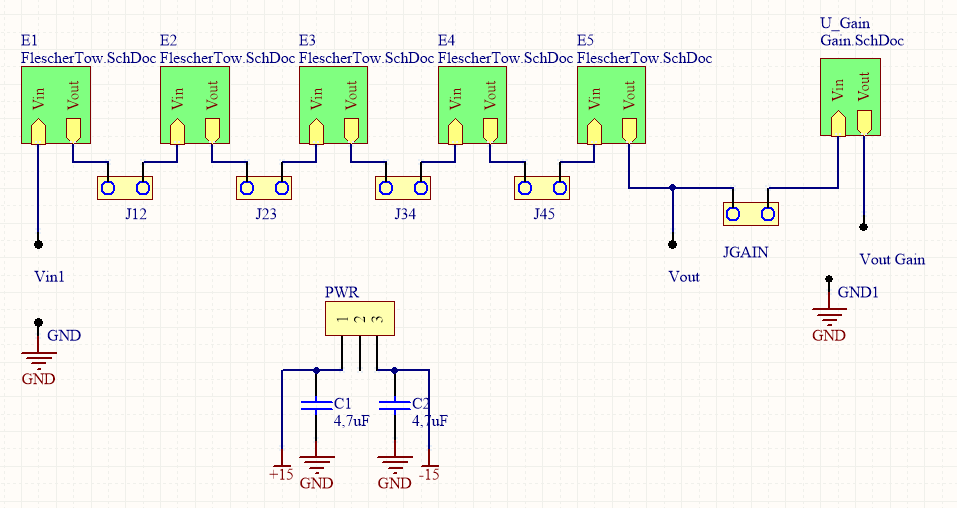
[picture p33: figure]

Figure 16: Esquemático Total Empleado Para PCB

La porción correspondiente a la celda Flescher-Tow se puede observar en la gura 17. Para esta etapa se trabajo con resistencias genéricas mediante un footprint propio que permita colocar una combinacion de resistencia serie y/o paralelo(Serie o paralelo) a gusto.

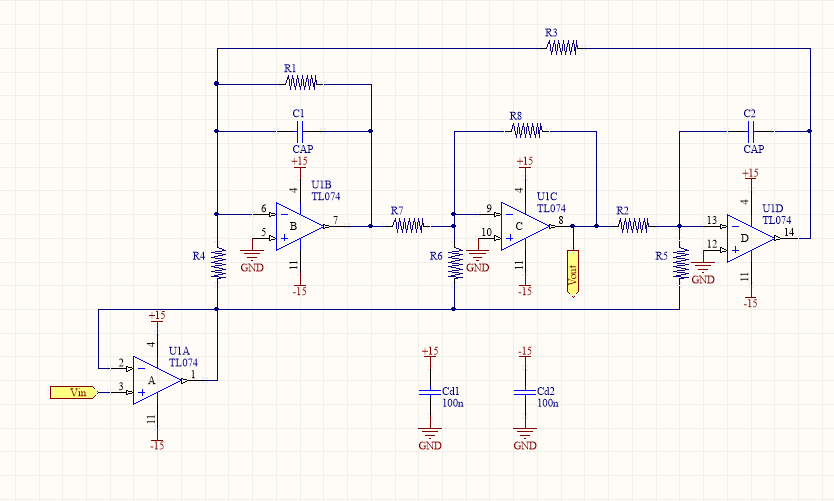
[picture p34: figure]

Figure 17: Esquemático Porción Fleshcher Tow

La agrupación mediante subetapas permitió realizar un rooteo mucho más sencillo ya que solamente fue necesario realizarlo para una etapa y luego copiar para el resto de las etapas mediante herramientas de altium. Se puede ver en el diseño nal del PCB en la gura 18 las cinco celdas cada una con un integrado propio y una zona de alta densidad de resistencias en su periferia.

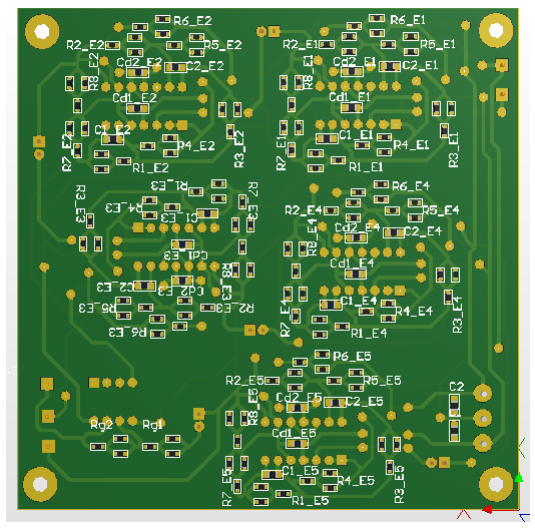
[picture p35: figure]
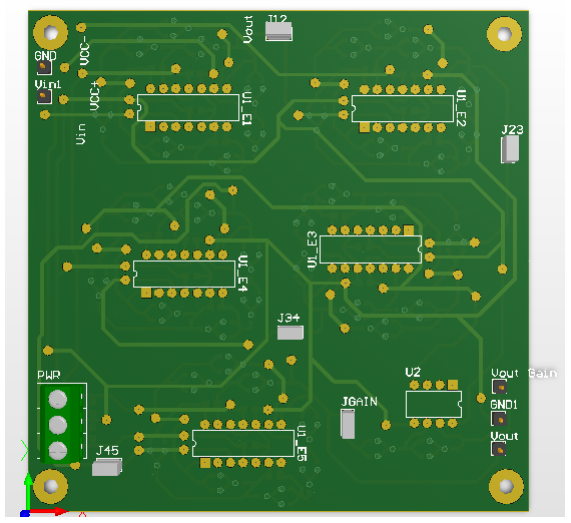
[picture p36: figure]

Figure 18: Diseño PCB Final

## 7. Mediciones y resultados

7.1. Respuesta en frecuencia

Se midió la respuesta en frecuencia del ltro y luego con ayuda de MATLAB se gracó para vericar el cumplimiento de plantilla. Los resultados fueron los siguientes:

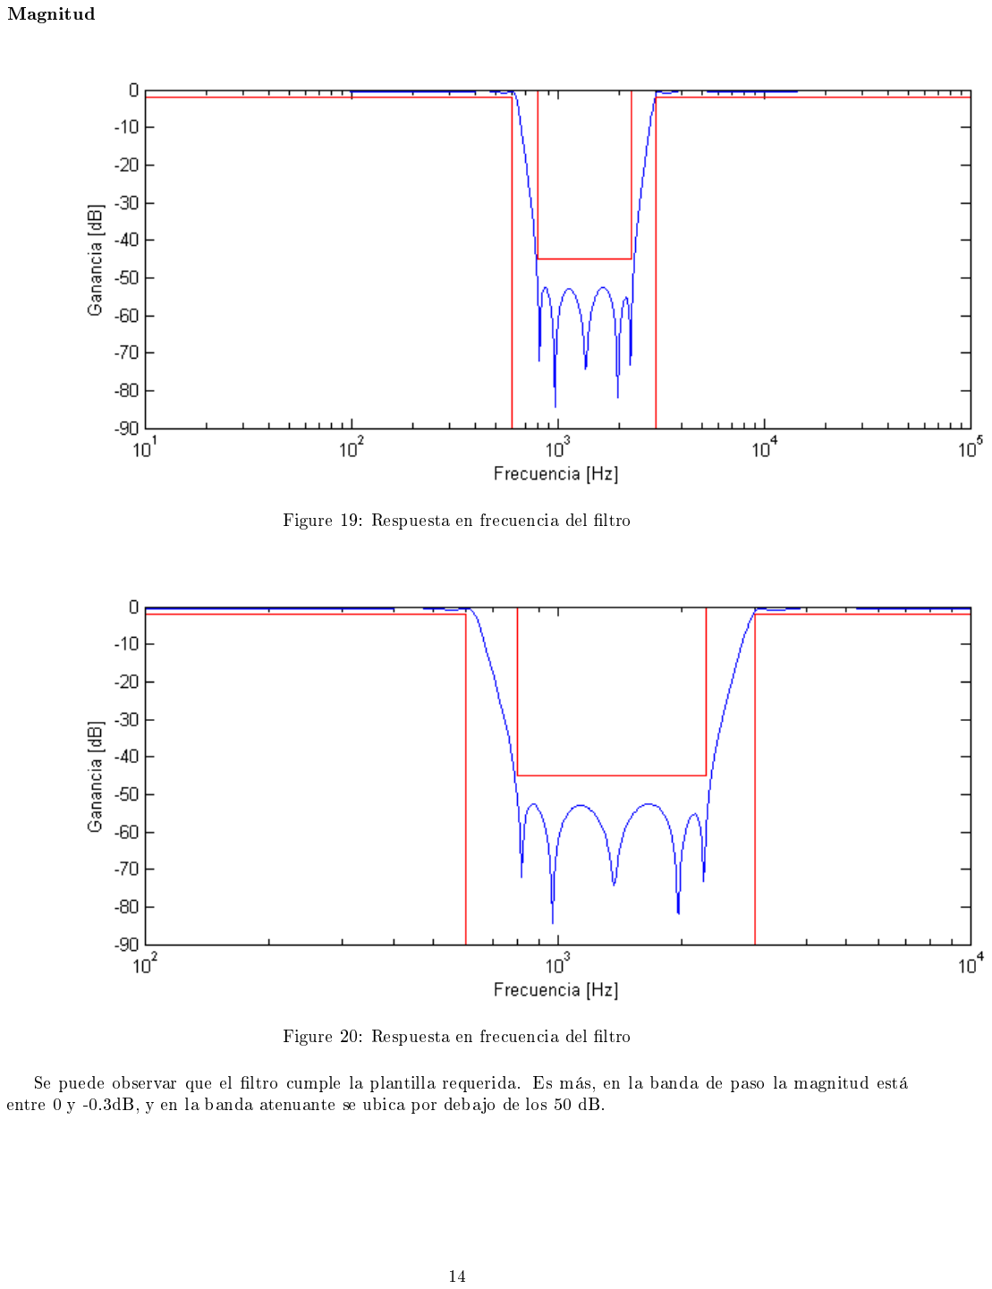
[picture p37: page 16]

Magnitud

Figure 19: Respuesta en frecuencia del ltro

Figure 20: Respuesta en frecuencia del ltro

Se puede observar que el ltro cumple la plantilla requerida. Es más, en la banda de paso la magnitud está entre 0 y -0.3dB, y en la banda atenuante se ubica por debajo de los 50 dB.

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

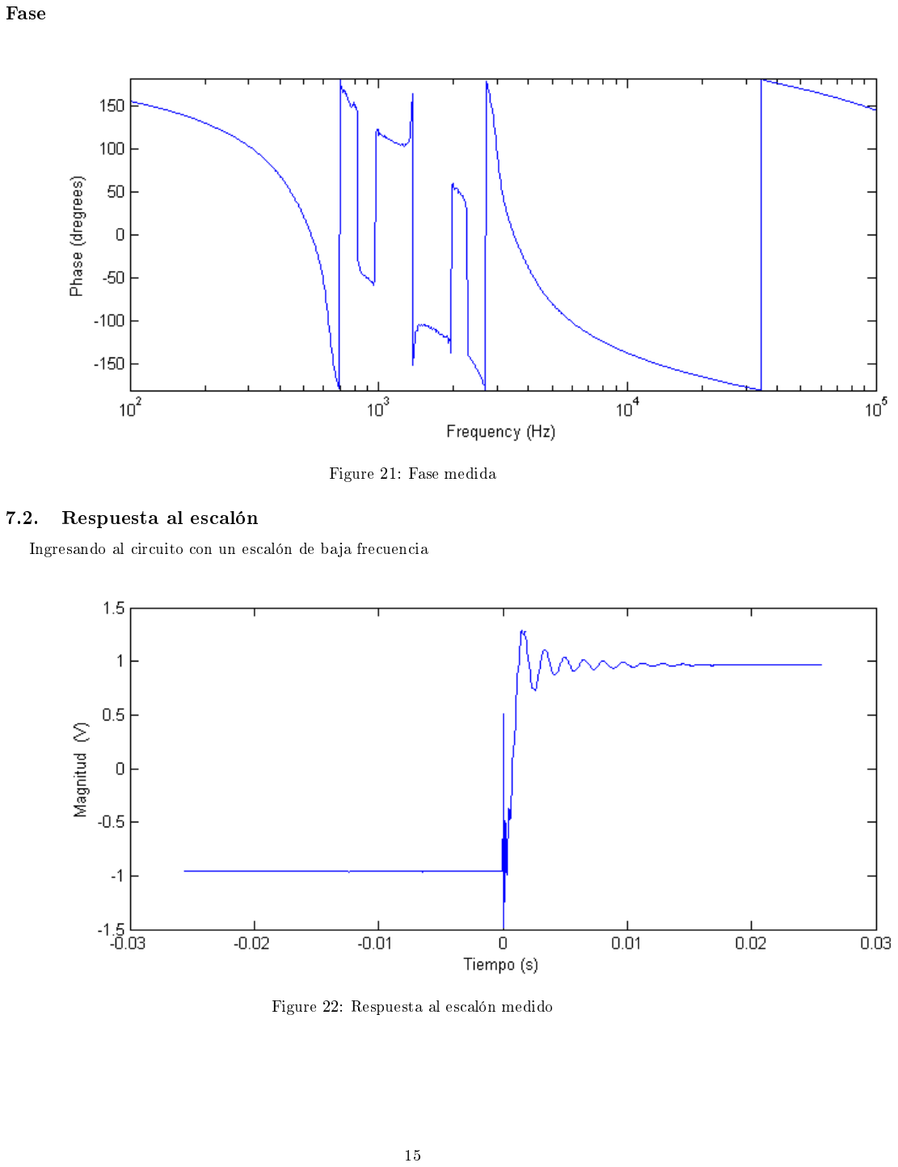
[picture p38: page 17]

## 8. Análisis de Costos de Componentes

Se optó por emplear resistores y capacitores SMD, esto fue con el n de minimizar tanto costos debido al tamaño de placa a emplear como costo por unidad de componente. Además, permitió minimizar la dispersión debido a la tolerancia de componentes empleados, se utilizaron resistencia con tolerancia al 1% y capacitores al 5%. A continuación en el cuadro 6se encuentra la cantidad de cada componente empleado y costo promedio por unidad en el panol. Para reducir costos se emplearon integrados con cuatro canales, es decir cuatro OpAmps por chip optando entonces por el integral TL074.
Se incluyó en el cuadro 7 el costo de la etapa opcional de ganancia, llegando de esta forma a un costo total de 4,455 U$D y 4,175 U$D con y sin etapa de ganancia respectivamente. Los costos calculados no incluyen el estaño empleado ni el costo de tamecos que fueron reutilizados de trabajos previos.
Componente | Costo Por unidad(U$D) | Cantidad Total | Costo Total(U$D)
Resistencias | 0,00644 | 120 | 0,7728
Capacitores | 0,012 | 20 | 0,24
Integrado TL074 | 0,24 | 5 | 1,2
Placa Doble Paz 10x10 | 1,942 | 1 | 1,942
Pines Rectos Comunes | 0.00966 | 20 | 0,01932
Costo Total | - | - | 4,17412

Table 6: Costo Total del PCB sin agregados

Componente | Costo Por unidad(U$D) | Cantidad Total | Costo Total(U$D)
Resistencias | 0,00644 | 6 | 0,03864
Capacitores | 0,012 | 1 | 0,012
Integrado TL072 | 0.23 | 1 | 0.23
Costo Total Etapa Ganancia | - | - | 0,28064
Costo Total | | | 4,45476

Table 7: Costo Total de Etapa Opcional de Ganancia

## 9. Conclusión

Se pudo diseñar un ltro rechaza-banda cumpliendo los requerimientos mencionados al comienzo de éste trabajo. Se evaluaron distintas formas de diseñar con diferentes celdas, siendo la Flescher-Tow la que mejor resultado dió, y por cuestiones de diseño también, se decidió implementar éste tipo de celdas. Además se realizó un análisis de costos del ltro en el cuál se vericó que utilizando resistencias smd, no sólo se baja la tolerancia del circuito, sino que también se pudo realizar en una placa mas pequeña lo que bajó considerablemente los costos.

## Resumen

Se llevo a cabo el diseño de un ltro rechaza banda que cumpla con los requisitos de una plantilla, para esto se debe tomar en cuenta la dispersión producida por la tolerancia de los componentes. Para lograr que el cumplimiento de la plantilla no dependa de la tolerancia de los componentes se deben tomar margenes, diseñando de esta manera para una plantilla más estricta. Los valores teóricos y prácticos tomados para el diseño se pueden observar en el cuadro 8

Aproximación | Cauer
Ap | 2 dB
Aa | 45 dB
− f p | 600 Hz
f a − | 800 Hz
f a + | 2300 Hz
f p + | 3000 Hz
Notch depth | 55 dB
Orden | 8
Aproximación | Cauer
Ap | 0.4 dB
Aa | 52.9 dB
− f p | 600 Hz
f a − | 800 Hz
f a + | 2300 Hz
f p + | 3000 Hz
Gain | -0.2 dB
Notch depth | 55 dB
Orden | 10

Table 8: Resumen: Requisito de Diseño Teórico y Prácticos Respectivamente

A partir de la plantilla de diseño se obtuvieron una serie de polos y ceros, debido a la aproximación de Cauer empleada se obtuvieron ceros de transmisión. Esto limito la posible elección de celdas, optando nalmente por la Celda Flescher-Tow, que consiste en una celda universal con baja sensibilidad y la característica de poder realizar ajuste que dependan de menos componentes que otros celdas, a diferencia de por ejemplo la Sedra, esto permitió jar los valores de capacitores y agrupar solamente las resistencias simplicando considerablemente la materialización del PCB.
Una vez diseñadas las etapas, se ordenaron para maximizar el rango dinámico del ltro, debido a que se trataba de un ltro con gran nivel de atenuación y cuatro notches se considero para alta señal. Por este motivo se ordenaron las etapas de polos de mayor factor de calidad (Q) a menor, buscando evitar que la señal caiga por debajo del piso del ruido.
En cuanto a la realización del PCB se optó por el uso de resistores y capacitores SMD con el n de minimizar espacio, costo y la tolerancia de los componentes. Esto permitió llevar a cabo el ltro con sus cinco etapas y una etapa opcional de ganancia en una placa de 10cmsx10cms. El PCB nal sin etapa de ganancia costó U$D 4,175 y se puede observar en las siguientes guras:

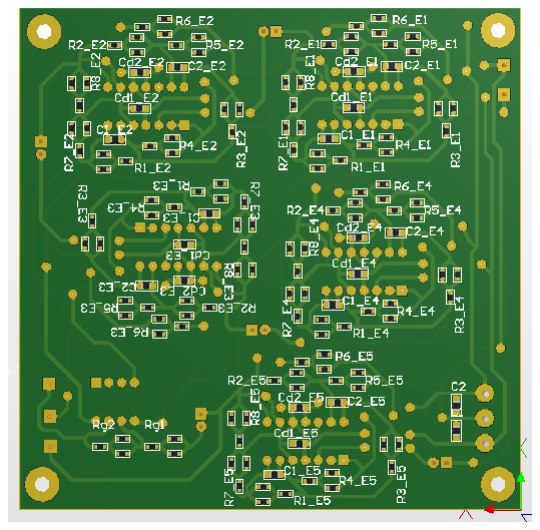
[picture p39: figure]
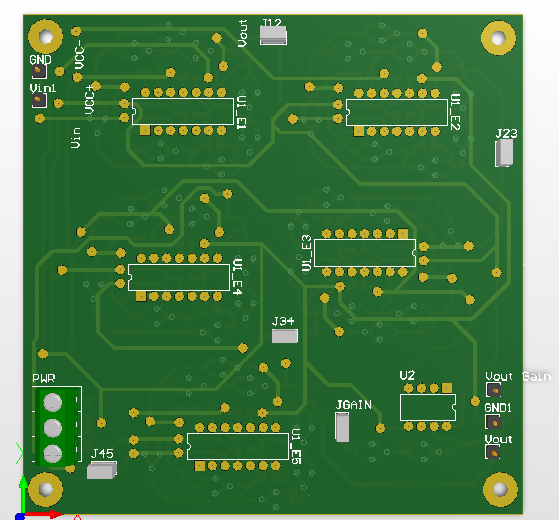
[picture p40: figure]

Figure 23: Diseño PCB Final
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
