tc-grupo-4/TP--FINAL/TPs Viejos/TP Final - Grupo Marce/TP FINAL.pdf

Teoría de Cir

uitos 22.01 | TP Final | ITBA

# Índi

e

1. | Ob jetivo | 2
2. Introdu

## ión teóri

a | 2
2. | 2. | Celda Kerwin- | Huelsman- | New
3. Maximiza

ión del rango dinámi
o | 5
3. | 1. | Deni
ión de rango dinámi
3. | 2. | Cál ulo de rango dinámi

## 3.4. Ele

| | ión de la ganan

ia de

3. | 5. | 7. | Etapa de ganan
4. | Criterios de estabilidad | 10
5. | Resultados | 11
5. | 1. | A
5. | 2. | A
5.3. Transferen
5.4. Impedan
6. Máxima
arga | 15
7. Implementa
ión en PCB | 15
8. Con
lusiones | 15

# 1. Ob jetivo

El ob jetivo del siguiente traba jo fue realizar un ltro pasa altos sin ripple, para ello se utilizó la aproxima

## ión

de Legendre. Se bus
ó aprove

har todas las herramientas aprendidas a lo largo de la materia para optimizar el

fun

ionamiento del ltro lo más posible, logrando que umpla la plantilla y además se obtenga el máximo rango

## dinámi

o utilizando la menor

antidad de

omponentes. Por las
ara

terísti

as del ltro y de sus distintas etapas

se de

idió implementarlo tanto
on

eldas universales (KHN) y
on Sallen- | Key, | debido a que ambas ofre
en la

venta ja de poder

ontrolar el fa
tor de

alidad independiente de la fre uen

ia de

orte, sus ba jas sensibilidades y
fá
il diseño.

## 2. Introdu

## ión teóri

a

# 2.1. Celda Sallen⁻Key

La

ongura
ión de la

elda Sallen- Key pasa altos es la siguiente:

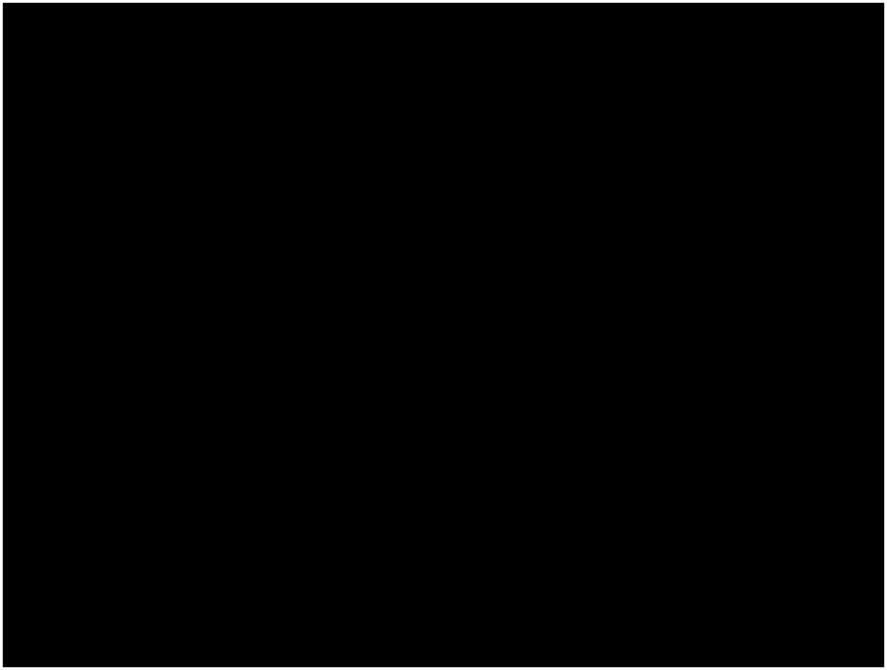
[picture p84: figure]

Figura 1: Congura

ión Sallen- Key pasa altos

Suponiendo que los ampli
adores opera

ionales son ideales se obtiene la fun

ión transferen
ia de la

elda:

## VHP

VI

= K

s

## 2R1R2C1C2

s

2R1R2C1C2 + s (R1C1 + R1C2 + R2C2(1 − K)) + 1 | (1)

K = 1 +

RB
RA

(2)

Donde ω0 y Q se pueden extraer del denominador:

ω

2
0 =

1

# R1R2C1C2

(3)

Q =

√

# R1R2C1C2 R1C1 + R1C2 + R2C2(1 − K)

(4)

Con estos resultados se puede ver que hay un ontrol dependiente entre Q y K , a justando el valor de RAo RB

pero sin afe

tar al ω0 del ltro.

Tabla general de sensibilidades

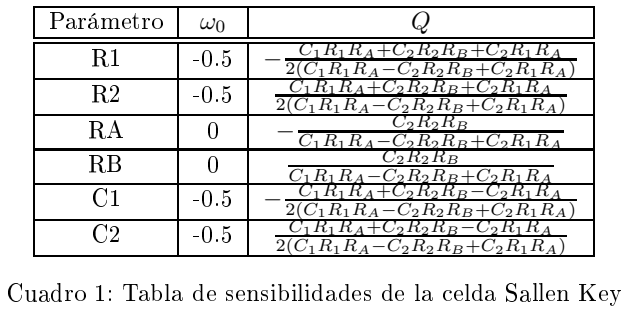
[picture p85: figure]
Parámetro; Cuadro 1: Tabla de sensibilidades de la; elda Sallen Key

### 2.2. Celda Kerwin⁻Huelsman⁻New omb

La

ongura
ión KHN es la siguiente:

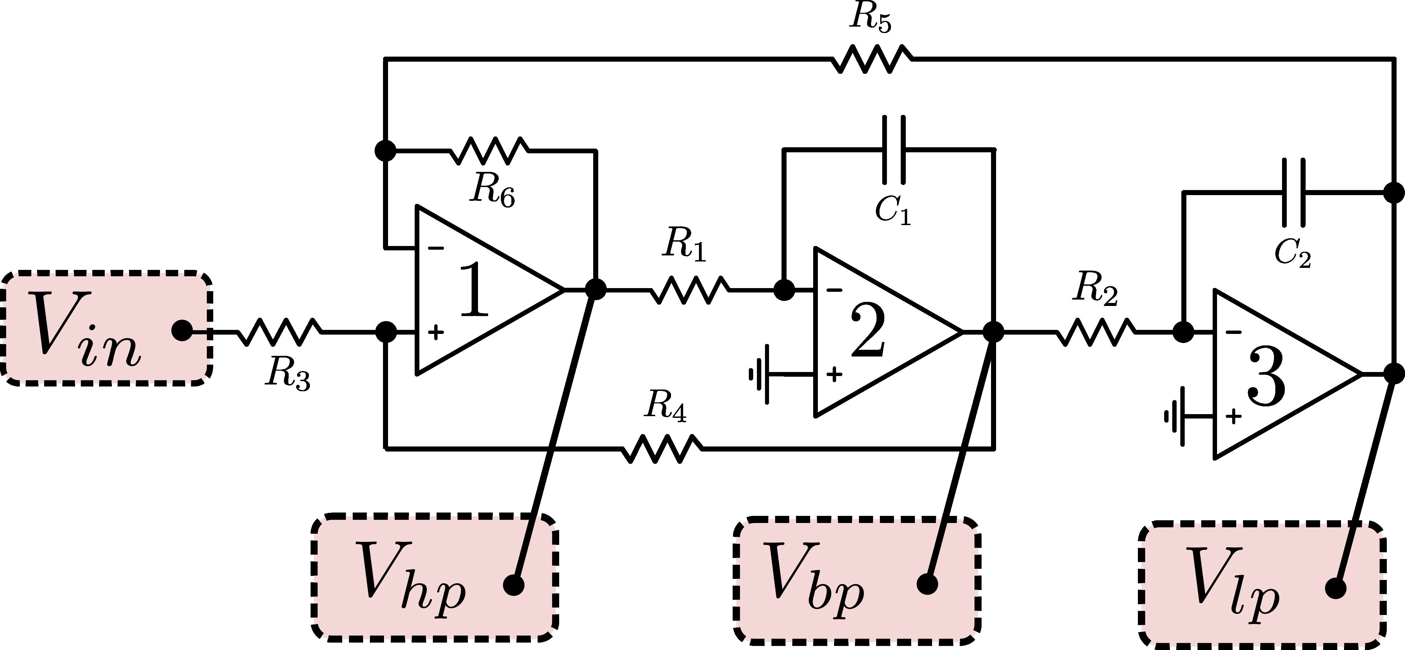
[picture p86: figure]

Figura 2: Congura

## ión KHN

Suponiendo que los ampli
adores opera

ionales son ideales se obtienen las siguientes fun

iones transferen
ia:

## VLP = −

1

# sC2R2

VBP | (5)

## VBP = −

1

# sC1R1

VHP | (6)

## Apli

ando nodos al primer ampli ador y despejando para VHP :

## VHP

VI

= −

s

2

1+ R6

R5
1+ R3

R4

s

2 +

1
C1R1
1+ R6

R5
1+ R4

R3

s +

1
C1R1

1
C2R2

R6
R5

(7)

Donde ω0 y Q se pueden extraer del denominador:

ω

2
0 =

R6
R5

1

# R1R2C1C2

(8)

Q =

1 + R4
R3

√

# R6R1C1

1 + R6
R5

√

# R5R2C2

(9)

Con este resultado se puede ver que hay un ontrol independiente en Q a justando el valor de R4o R3 sin afe tar
al ω0 del ltro.

Tabla general de sensibilidades

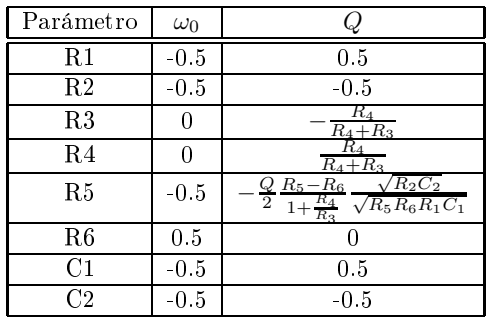
[picture p87: figure]
Parámetro

Cuadro 2: Tabla de sensibilidades de la etapa KHN

### 2.3. Filtro a implementar

La plantilla que el ltro debe umplir se detalla en la siguiente tabla:

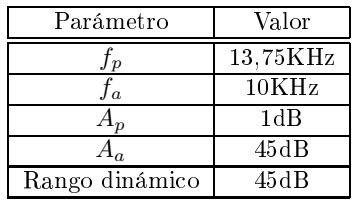
[picture p88: figure]
Parámetro; Valor; 13,75KHz; 10KHz; Rango dinámi

Cuadro 3: Cara
terísti

as del ltro pasa altos

Tomando

omo base los valores de la onsigna, para el diseño del ltro se tomó ierto márgen para la banda

de paso y la banda de atenua

## ión:

Parámetro | Valor
Ap | 0,5dB
Aa | 50dB

Cuadro 4: Valores utilizados para el ltro

A
ontinua

ión,

on los valores obtenidos y utilizando el programa realizado en un traba jo prá
ti

o anterior,

se

al

ularon los valores de los polos orrespondientes a la transferen

ia del ltro. | Para aproximar la plantilla, | se

realizó en una primera instan
ia

on la aproxima

ión de Butterworth;

omo el orden resultante era demasiado

elevado (> 20), se de

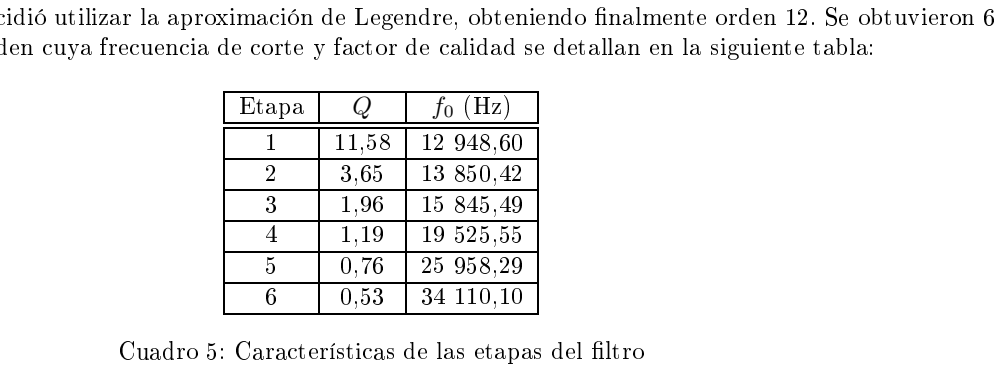
[picture p89: figure]
idió utilizar la aproxima; ión de Legendre,; obteniendo nalmente orden 12.; Se obtuvieron 6; uya fre; uen; orte y fa; tor de; Etapa; Cuadro 5: Cara; terísti; as de las etapas del ltro

etapas de segundo orden

alidad se detallan en la siguiente tabla:

2.3.1. Diagrama de Polos y Ceros

Con loa valores de ω0 y Q obtenidos, se onstruyen las transferen

ias de las diferentes etapas, onsiderando

que la forma general de

ada una responde al formato siguiente:

H(s) = | s

2
s

2 + s ·

ω0
Q + ω0

2

Resultando el siguiente diagrama de polos y eros.

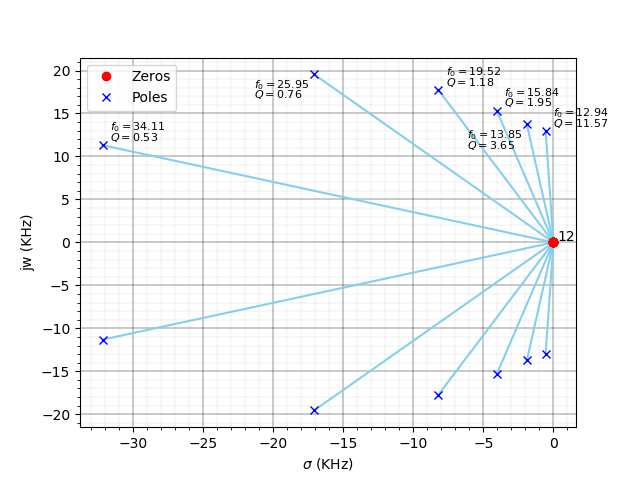
[picture p90: figure]

Figura 3: Diagrama de polos y eros

## 3. Maximiza

## ión del rango dinámi

o

Conseguidas las etapas se pro edió al desarrollo de un algoritmo ade

uado tanto para ordenarlas, omo para

denir | sus ganan
ias. | Es impotrante notar que para su desarrollo se bus

ó una solu

## ión

on el mayor rango

## dinámi

o posible, dentro de las
apa

idades de pro

esamiento disponibles.

# 3.1. Deni

### ión de rango dinámi

o

En primer lugar, se a

lará la deni
ión utilizada para rango dinámi o. Dado un piso de ruido VRUIDO y

un limite de satura

ión VSAT , deniremos rango dinámi o

omo la rela

ión entre la tensión mas grande y la

tensión mas pequeña que podremos ingresar a nuestro ltro, teniendo ganantizado su orre

to fun
ionamiento, | en
otras palabras, | evitando que ninguna señal intermedia sea menor que el piso de ruido o mayor que la tensión de

satura

ión. Es importante a

larar que el
orre

to fun
ionamiento se garantiza dentro de un

onjunto de fre
uen

ias

en un rango fMIN , | fMAX , | que será tomado sobre la banda de paso, | ya que son las fre
uen

ias no atenuadas.

# 3.2. Cál

### ulo de rango dinámi

o

Se a
larará ahora
omo se

al

uló en
on

reto el rango dinámi

o dados los pisos de ruido, las fre uen

ias de

traba jo, y la transferen
ias de

ada etapa en algún orden.
Se
al

## ula VMIN (f) y VMAX (f) para

ada fre
uen

ia de traba jo en parti

ular, y luego se

al

## ula VMIN y

VMAX absolutos
omo:

# VMIN = m´ax

## fi∈F

## VMIN (fi)

# VMAX = m´ax

## fi∈F

## VMAX (fi)

Para

al

## ular VMIN y VMAX

on

ada fre
uen

ia en parti

ular se pro

ede

on un algoritmo que iterativamente,

llendo de la primera a la última etapa, des

arta paso a paso las tensiones que provo

arían en algun paso señales

fuera de los niveles de tensión permitidos. El algoritmo es muy e iente en el

ontexto en el que traba jamos; O(n)

porque utiliza una fórmula
errada en

ada itera

ión para ir redu

iendo el rango de tensiones máxima y mínima

que podrían insertarse en la entrada de la primera etapa.

### 3.3. Ordenamiento de las etapas

Para ordenar las etapas se

onsideró utilizar algún algoritmo heurísti

o pero debido a que solo se traba jo on

6 etapas, | se optó por probar todos los ordenes posibles de etapas, | ya que fueron tan solo 6! = 720
ombina
iones.

Se realizó un programa que
al

uló el rango dinámi
o

on

ada

ombina

ión | (luego de denir, | mediante otro

algoritmo la

onstante de

ada etapa), | y se eligió la mejor. | Como en general ninguna
ombina
ión superó por gran
margen los 60dB , | se eligió por simpli
idad, | la

ombina

ión 1−2−3−4−5−6, que tuvo 62dB de rango dinámi o.

# 3.4. Ele

### ión de la ganan

# ia de

### ada etapa (para anexo)

Se desarrolló una fórmula para de
idir,

on ya las etapas ordenadas y la ganan

ia total del sistema

ompleto,

la ganan

ia de

ada etapa,

on el ob jetivo de, | dado el orden de etapas ya denido, | maximizar el rango dinámi
o.

Esta fórmula si se expli
ará ya que se

onsiderá

| ompleja de

omprender sin una expli
| | a ión previa.

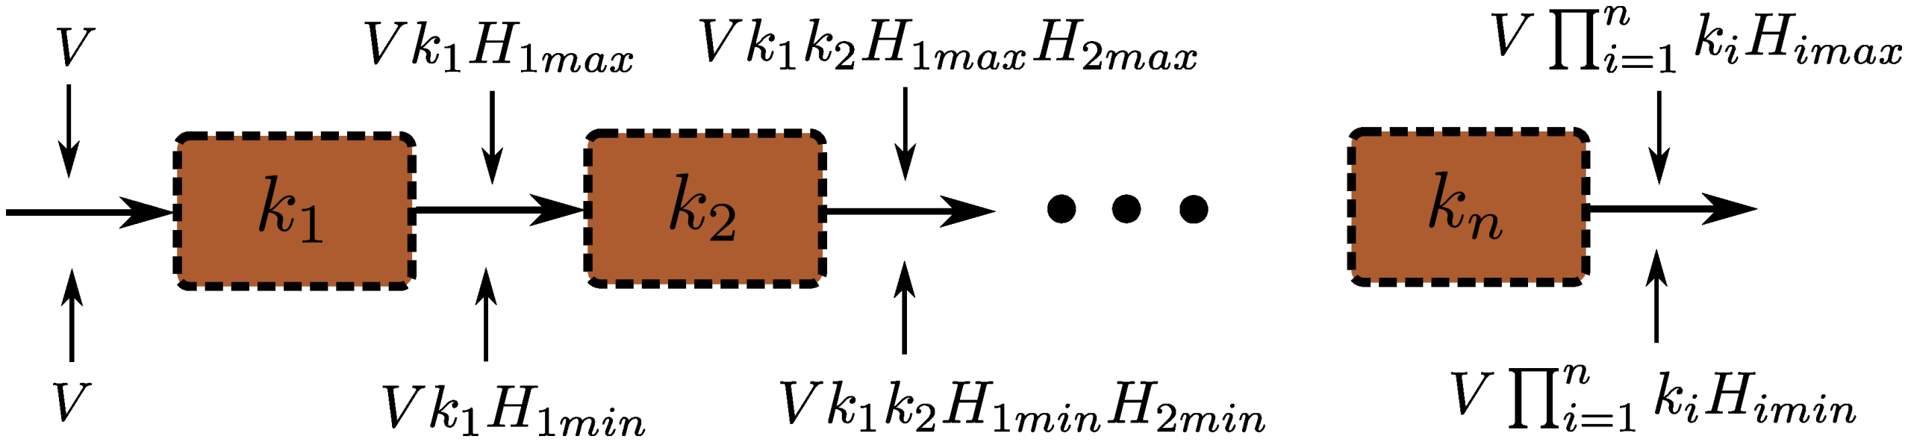
[picture p91: figure]

Figura 4: Casos posibles dada una tensión de entrada arbitraria

Se piensa en una entrada de tensión arbitraria que entra al sistema previo a que fuesen de ididas las ganan
ias
de

ada etapa. Se
al

ula el valor máximo y mínimo de

ada etapa (si tuviera
ada una ganan

ia unitaria)

## H1max, H1min, H2max . Se presta aten

ión en los valores máximos y mínimos que pudiesen tener el valor de

ada

tensión intermedia entre las etapas, | hasta la salida. | Para garantizar que no exista ni satura
ión, | ni ruido en una

etapa intermedia se debe exigir que todos los valores intermedios sean mayores que el piso de ruido y menores que

la tensión de satura

ión. | Por lo tanto se pueden observar las desigualdades que deben
| | umplirse:
V < | Vsat

## k1H1max

| V < | Vsat

## k1k2H1maxH2max

V < Q

## Vsat

n

## i=1 kiHimax

=

## Vsat

## ktotalHmaxtotal

Y por otro lado también deben

umplirse

otas inferiores para:

## V > Vruido

## V > Vruido

## k1H1min

V > Q

## Vruido

n

## i=1 kiHimin

=

## Vruido

## ktotalHmintotal

Como Qn
i=1 ki = ktotal que esta denido, enton es la ultima desigualdad en ambos

asos siempre será la misma

sin importar que ganan

ia le demos a ninguna etapa en parti

ular. Por lo tanto miramos las otras desigualdades

para denir la ganan
ia de las etapas.

Observamos la desigualdad n − 1 tanto en las otas inferiores
omo en las superiores. Rees

ribiendo en fun
ion

de ktotal tenemos

# V < Vsat

## ktotalHmaxtotal

knHnmax

V >

## Vruido

## ktotalHmintotal

knHnmax

Enton

es ahora,

on el ob jetivo de obtener restri

iones iguales o mejores que las anteriores se pide:

## knHnmax > 1 ⇔ kn <

1

Hnmax

## knHnmin < 1 ⇔ kn >

1

Hnmin

Enton

es se elige arbitrariamente kn(dB) = −

Hnmax−Hnmin
2

que

umple

on ambas desigualdades a la vez.

Como no se empeora ninguna restri ión anterior esta de
isión es óptima.

Realizando en mismo pro

edimiento

on n − 2, n − 3 se
al

ulan todas las ganan

ias para todas las etapas

ex

epto la ultima, a la

ual se le da la ganan

ia restante para que todas sumen ktotal (en dB).

### 3.5. Diseño de etapas

Para implementar las etapas de más alto Q (etapas 1 y 2) se usó la elda KHN en la salida pasa altos, dado

que permite un

ontrol independiente de éste respe

to de la fre
uen
ia ω0 y resultan sensibilidades ba jas. | Para las
etapas 3, | 4, | 5 y 6 se utilizó la
elda Sallen- | Key pasa altos, | dado que son las etapas de menor Q y utilizan menos

omponentes pasivos y opera

ionales que la

elda universal.
A
ontinua

ión se

al

ularon los | valores | de los
omponentes | que | se utilizaron | para
onstruir

ada

elda,

añadiendo un preset en alguna resisten ia en

aso de que se

onsidere ne
| | esario.

## 3.5.1. Etapa 1

Tomando C1 = C2 = 1nF y R1 = R2 = R, se tiene que:

ω0 =

1

## RC ⇒ R =

1

# ω0C = 12 291Ω

Y tomando R3 = 1KΩ se tiene que:

# R4 = R3(2 Q − 1) = 22 160Ω

# R5 = R6 = 15KΩ

Luego

on | ayuda de la simula
ión | se a justaron | los valores para que el ltro
umpla la plantilla deseada

quedando:

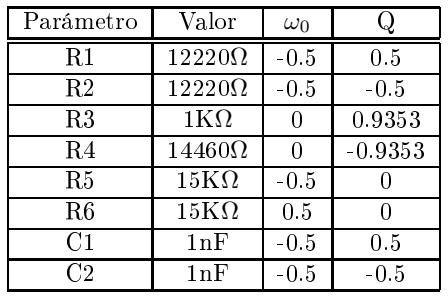
[picture p92: figure]
Parámetro; Valor

Figura 5: Tabla de sensibilidades de la etapa 1 (KHN)

Dado que esta etapa es de un alto Q y ontribuye a denir en forma

## ríti

a la forma nal de la transferen
ia

del ltro, se implementó R4 omo una resisten

ia ja en serie a un preset para poder tener un ontrol de éste y

realizar el a juste ne

| esario al momento de la implementa
ión.

## 3.5.2. Etapa 2

Tomando C1 = C2 = 4,7nF y R1 = R2 = R, se tiene que:

ω0 =

1

## RC ⇒ R =

1

# ω0C = 2445Ω

Y tomando R3 = 1KΩ se tiene que:

# R4 = R3(2 Q − 1) = 13 860Ω

# R5 = R6 = 15KΩ

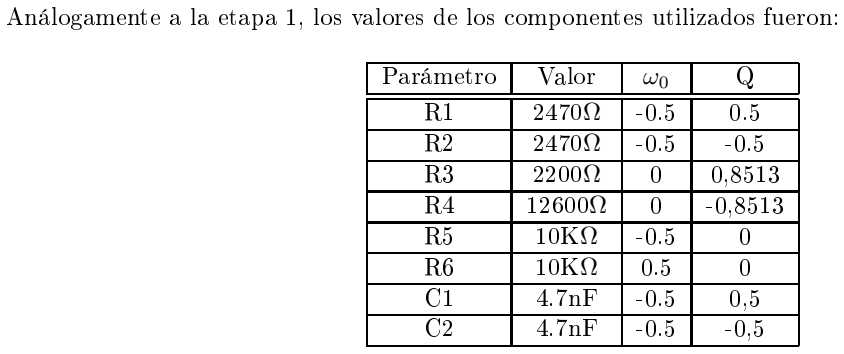
[picture p93: figure]
Análogamente a la etapa 1,; los valores de los; omponentes utilizados fueron:; Parámetro; Valor

Figura 6: Tabla de sensibilidades de la etapa 2 (KHN)

Con el mismo
riterio que en la etapa 1, se implementó la resisten

## ia R4

on una en serie ja a un preset.

## 3.5.3. Etapa 3

Tomando C1 = C2 = 5,6nF y R1 = R2 = R, se tiene que:

ω0 = 1

## RC ⇒ R = 1

# ω0C = 1794Ω

Y tomando RA = 1KΩ se tiene que:

# RB = RA(2 − 1

Q

) = 13 860Ω

Se a justaron los valores de los

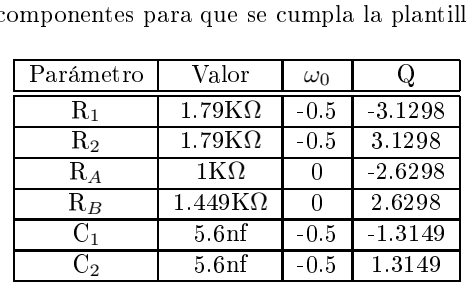
[picture p94: figure]
omponentes para que se; Parámetro; Valor

umpla la plantilla y nalmente quedó:

Figura 7: Sensibilidades de la etapa 3

Dadas las altas sensibilidades obtenidas respe

to al Q, se implementó la resisten

ia RB mediante una ja en

serie a un preset más pequeño, para poder realizar un a juste no.

## 3.5.4. Etapa 4

Tomando C1 = C2 = 3,3nF y R1 = R2 = R, se tiene que:

ω0 =

1

## RC ⇒ R =

1

# ω0C = 2470Ω

Y tomando RA = 1,5KΩ se tiene que:

# RB = RA(2 −

1
Q

) = 1739Ω

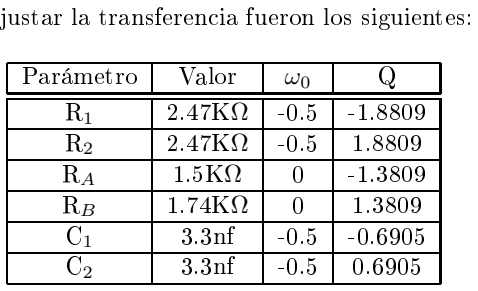
[picture p95: figure]
ia fueron los siguientes:; Parámetro; Valor

Los valores utilizados luego de a justar la transferen

Figura 8: Sensibilidades de la etapa 4

## 3.5.5. Etapa 5

Tomando C1 = C2 = 5,6nF y R1 = R2 = R, se tiene que:

ω0 =

1

## RC ⇒ R =

1

# ω0C = 1858Ω

Y tomando RA = 10KΩ se tiene que:

# RB = RA(2 −

1
Q

) = 6842Ω

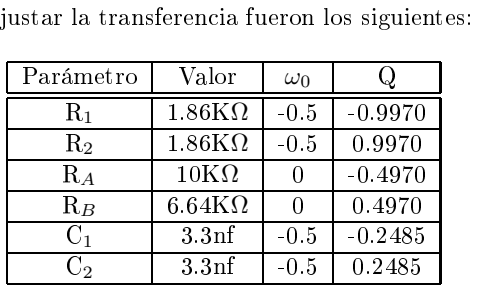
[picture p96: figure]
ia fueron los siguientes:; Parámetro; Valor

Los valores utilizados luego de a justar la transferen

Figura 9: Sensibilidades de la etapa 5

## 3.5.6. Etapa 6

Tomando C1 = C2 = 2,2nF y R1 = R2 = R, se tiene que:

ω0 = 1

## RC ⇒ R = 1

# ω0C = 2121Ω

Y tomando RA = 10KΩ se tiene que:

# RB = RA(2 − 1

Q

) = 1132Ω

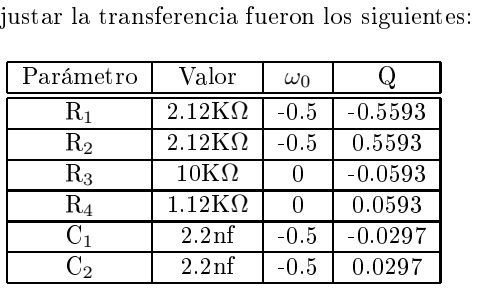
[picture p97: figure]
ia fueron los siguientes:; Parámetro; Valor

Los valores utilizados luego de a justar la transferen

Figura 10: Sensibilidades de la etapa 6

3.5.7. Etapa de ganan

ia

Se agregó al nal una etapa de ganan
ia

on el n de poder
ontrolar las varia

iones del ltro.

# 4. Criterios de estabilidad

Se pro

edió a veri
ar la estabilidad de

ada una de las etapas, para prevenir os

## ila

iones en la salida del

sistema

Se simuló enton
es la ganan

ia de lazo de

ada una de las etapas, abriendo el lazo y

al

ulando por lo tanto

la transferen

ia H(s) = AB .
Se
al

uló, en efe

to el margen de fase y de amplitud.

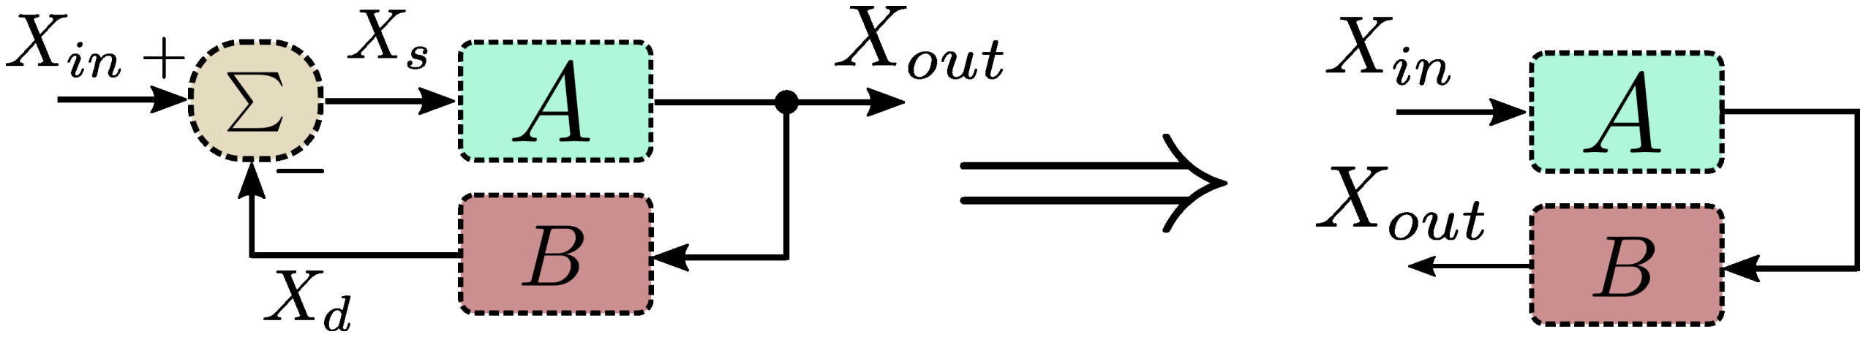
[picture p98: figure]

Figura 11: Diagrama en bloques

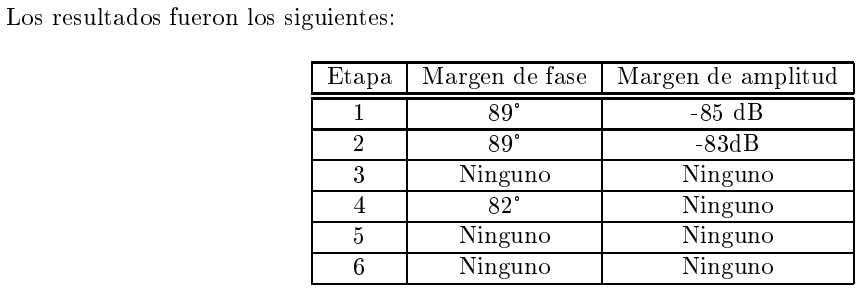
[picture p99: figure]
Los resultados fueron los siguientes:; Etapa; Margen de fase; Margen de amplitud; Ninguno

Figura 12: Márgenes de fase y amplitud. Se di e Ninguno en aquellos donde no se

ruza el eje de 0dB ó 0 grados

Por lo tanto, | ba jo el
riterio utilizado, | se determinó una posible os

## ila

## ión del

ir

uito
omo po

o probable.

Es importante notar que los resultados

on las etapas

argadas y sin

argar fueron similares, por lo que no se

onsideró relevante mostrar los resultados en ambas
ir
unstan

ias.

## 5. Resultados

## ión los grá

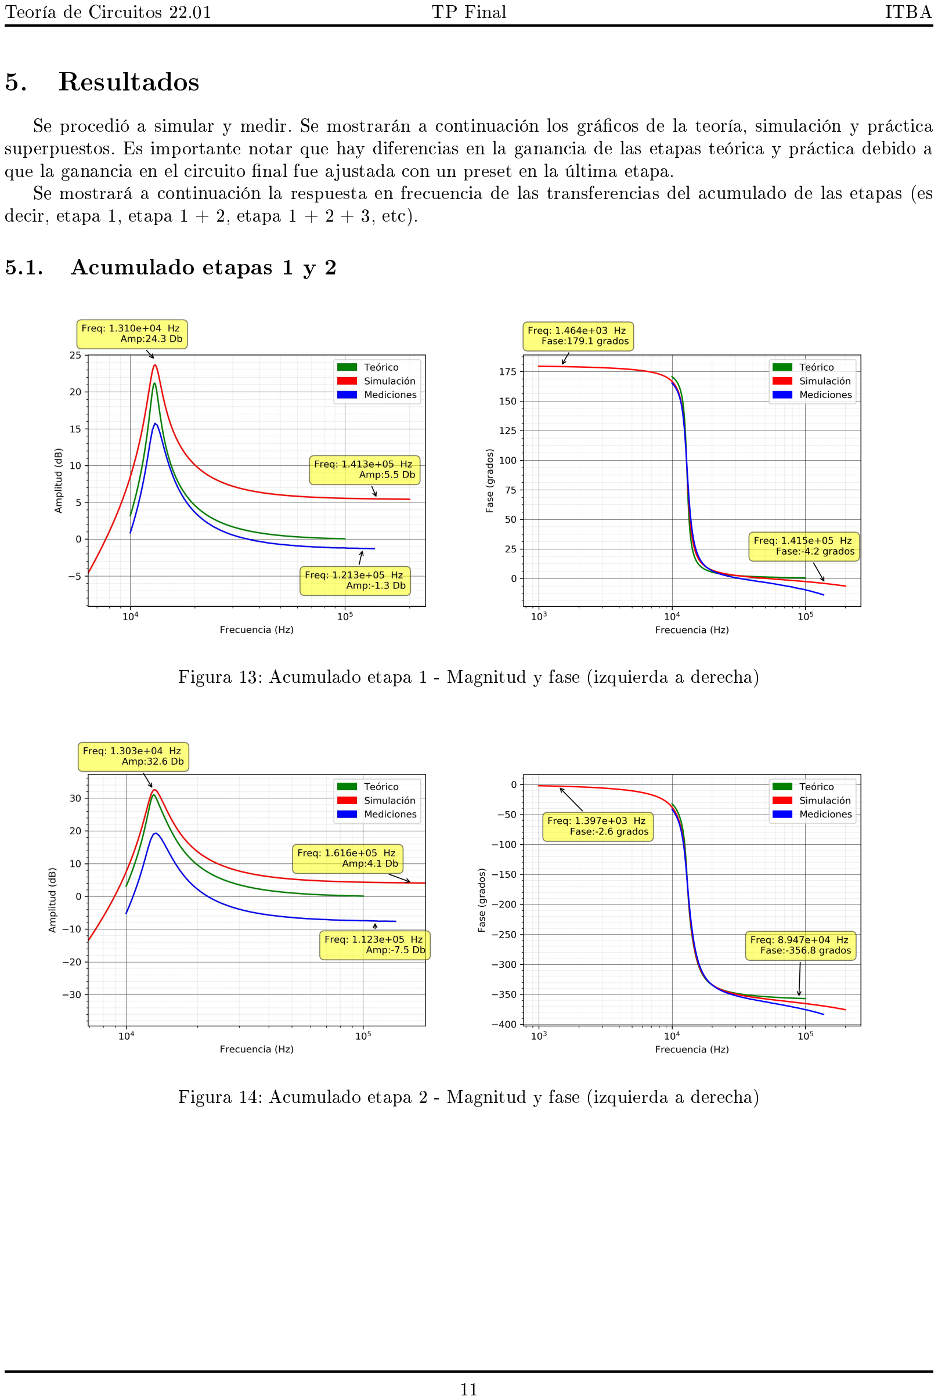
[picture p100: page 11]

Se pro

edió a simular y medir. Se mostrarán a ontinua

os de la teoría, simula

## ión y prá

ti
a

superpuestos. Es importante notar que hay diferen ias en la ganan

ia de las etapas teóri

## a y prá

ti

a debido a

que la ganan

ia en el
ir

uito nal fue a justada
on un preset en la última etapa.

Se mostrará a
ontinua

ión la respuesta en fre
uen

ia de las transferen
ias del a

umulado de las etapas (es

de
ir, | etapa 1, | etapa 1 + 2, | etapa 1 + 2 + 3, | et

).

5.1. A

### umulado etapas 1 y 2

Figura 13: A

umulado etapa 1 - Magnitud y fase (izquierda a dere

ha)

## Figura 14: A

umulado etapa 2 - Magnitud y fase (izquierda a dere

ha)

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

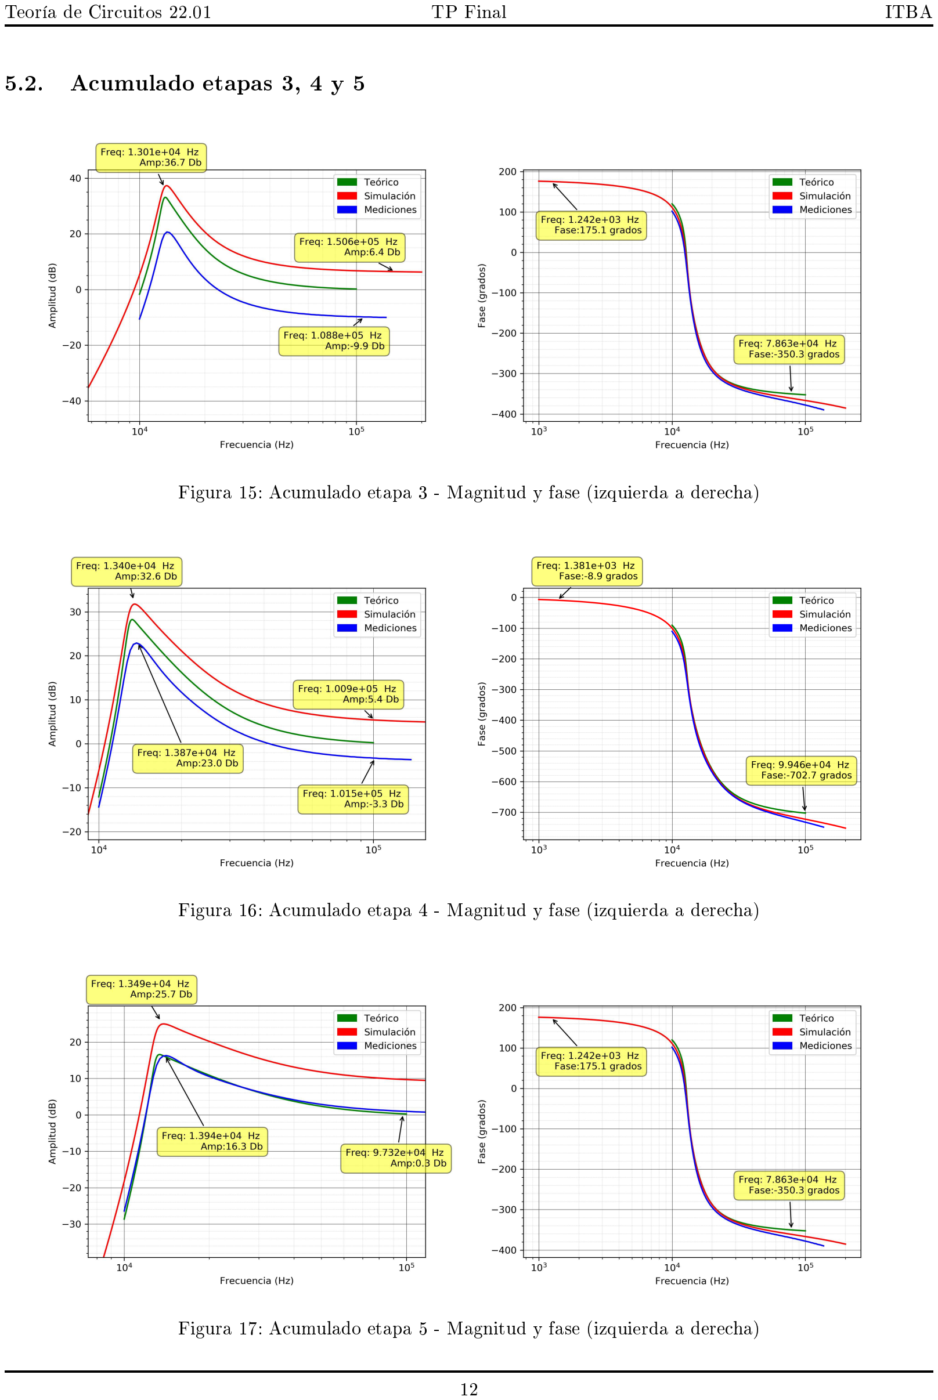
[picture p101: page 12]

### 5.3. Transferen

### ia total

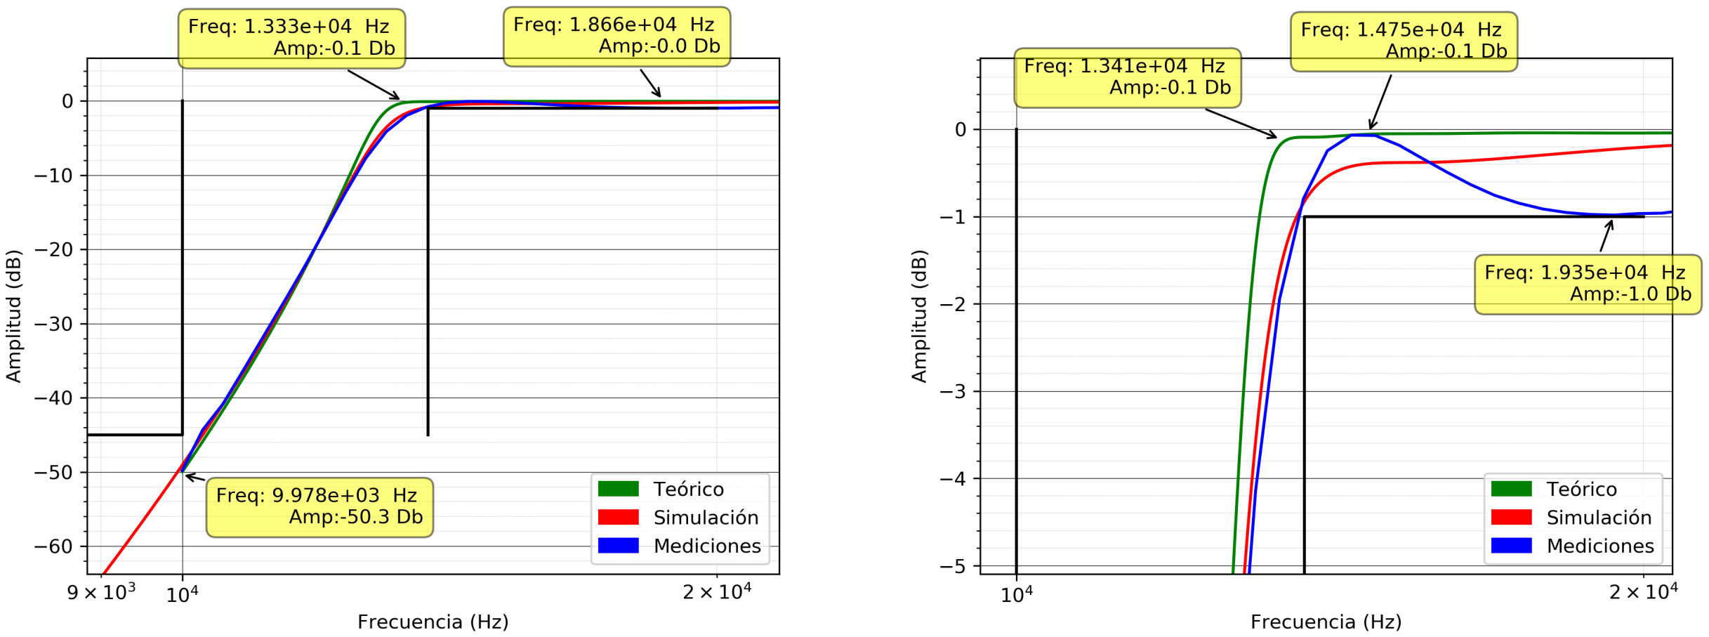
[picture p102: figure]

Figura 18: Transferen
ia total - Magnitud

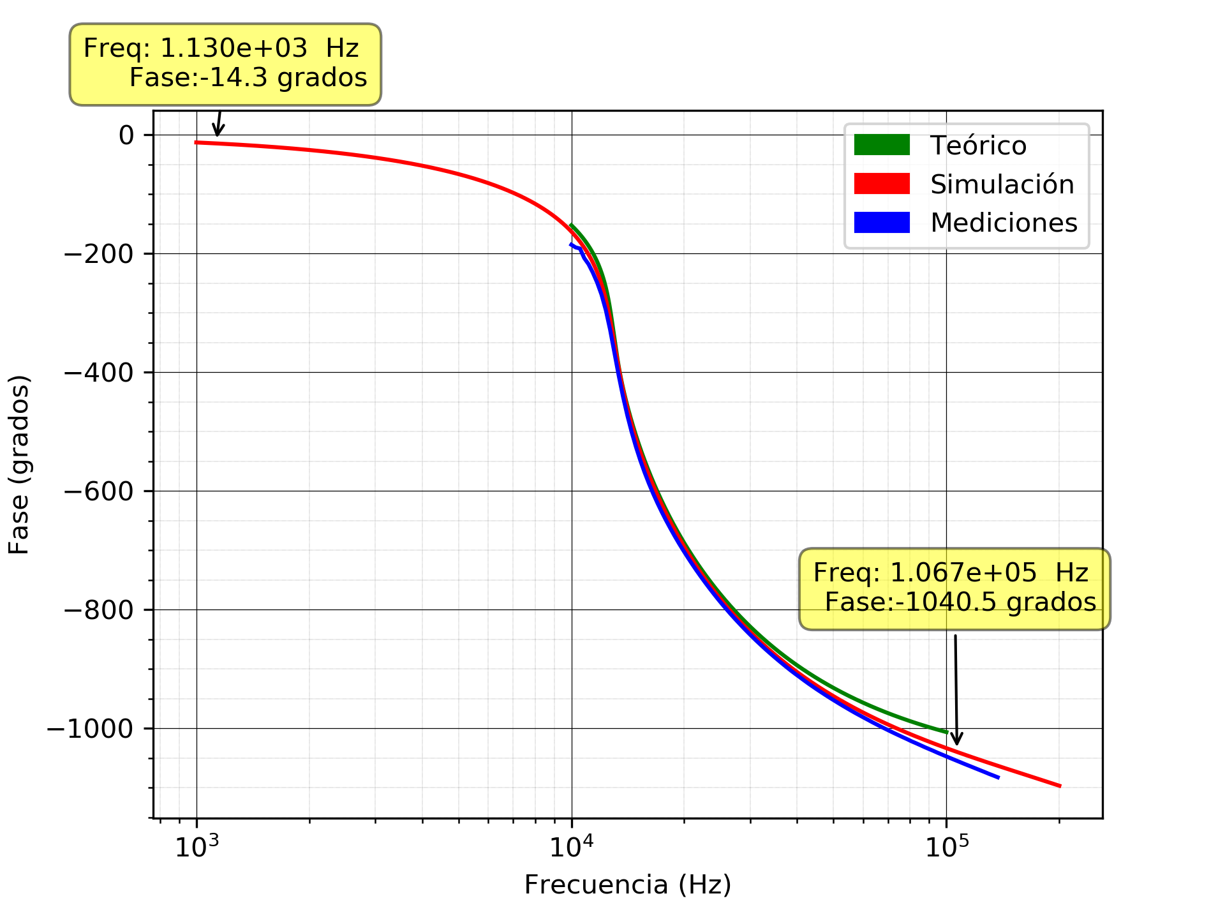
[picture p103: figure]

Figura 19: Transferen
ia total - Fase

En general se observó una gran

orresponden

ia entre la teória y la prá
ti
a. Es importante resaltar que fueron

ne

esarios a justes nos muy
omplejos para lograr

umplir la plantilla. El sobrepi

o de la

urva medida, no fue

posible eliminarlo debido a que su valor dependía de mu

hos más

omponentes que los que se tuvo la apa

## idad

de variar.

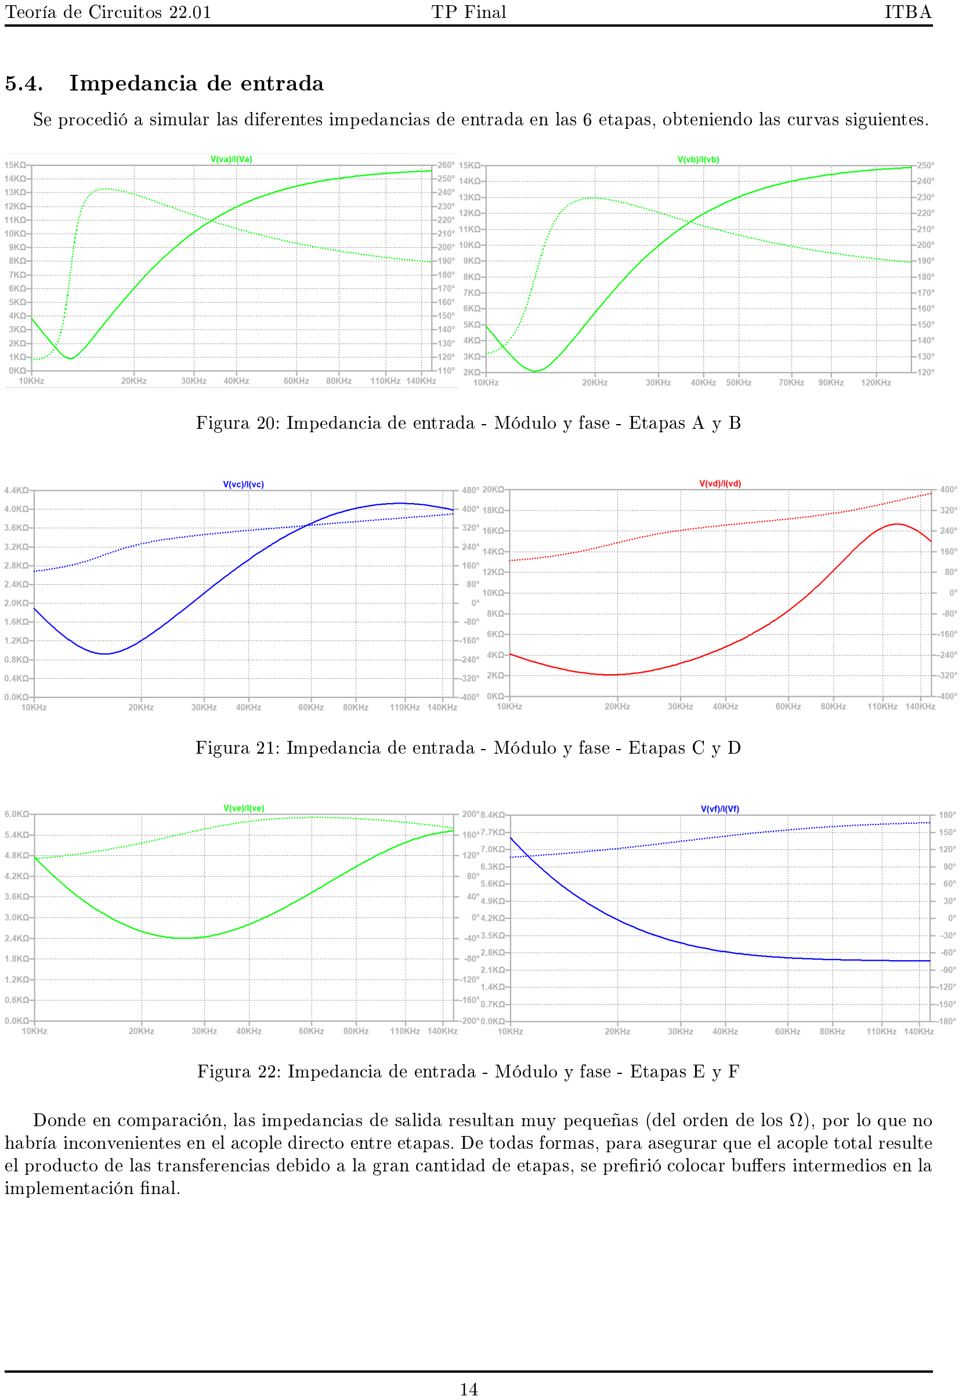
[picture p104: page 14]

### 5.4. Impedan

### ia de entrada

Se pro

edió a simular las diferentes impedan ias de entrada en las 6 etapas, obteniendo las urvas siguientes.

Figura 20: Impedan

ia de entrada - | Módulo y fase - | Etapas A y B

Figura 21: Impedan

ia de entrada - | Módulo y fase - | Etapas C y D

Figura 22: Impedan

ia de entrada - | Módulo y fase - | Etapas E y F

Donde en
ompara
ión, | las impedan
ias de salida resultan muy pequeñas (del orden de los Ω), | por lo que no

habría in

onvenientes en el a

ople dire

to entre etapas. | De todas formas, | para asegurar que el a
ople total resulte

el produ

to de las transferen
ias debido a la gran
antidad de etapas, | se prerió
| | olo ar buers intermedios en la

implementa

ión nal.

## 6. Máxima arga

Se estudió la mínima
arga que el sistema soportó sin alterar sus ara

terisiti

as de ltro. Di
ha

arga fue de

# 38,1Ω. Esta limita

ión se debió a la máxima

orriente que el opera

ional de la última etapa de ganan

ia tiene la

apa

idad de suministrar. Para realizar di

ha medi
ión se

olo
ó
omo

arga un preset, y se lo
omenzó a variar

disminuyéndolo hasta en

ontrar el punto donde la tensión omienza a

aer y la
orriente a aumentar.

## 7. Implementa

# ión en PCB

El diseño nal del ltro se implementó en una pla

# a de 10×15 (

m), utilizando opera
ionales TL084 y

olo

ando

jumpers para aislar las diferentes etapas y poder realizar las medi iones a

umulativas.

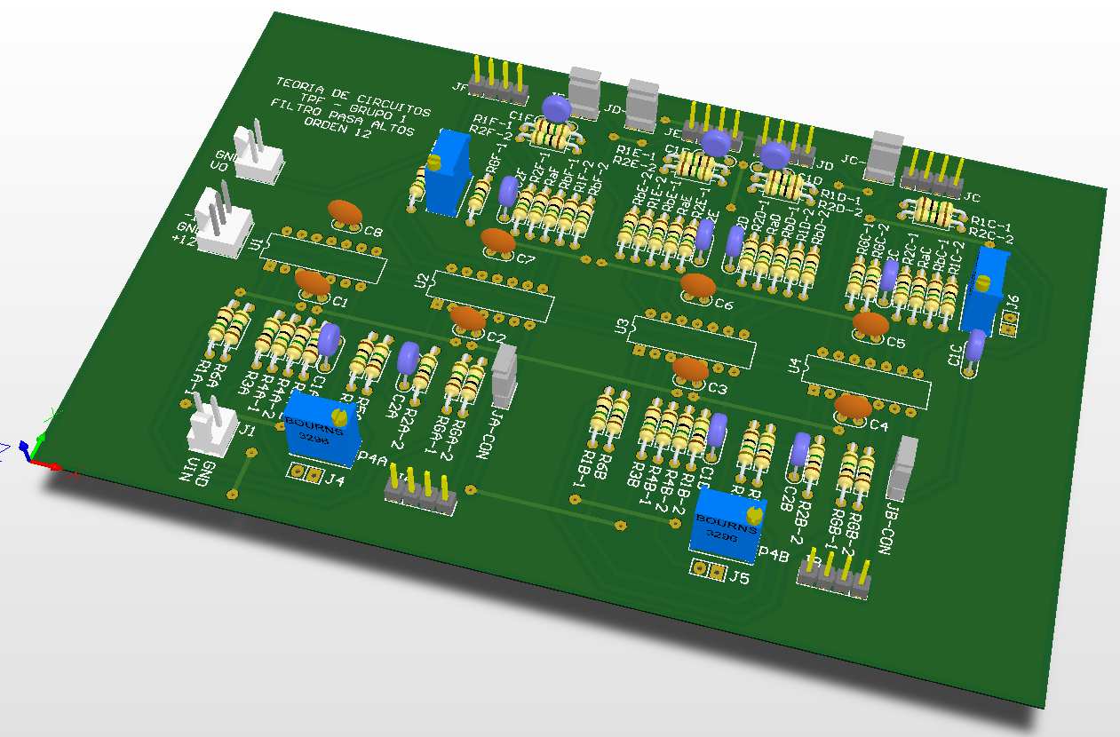
[picture p105: figure]

Figura 23: Diseño de PCB - Vista 3D

## 8. Con

## lusiones

A partir del ltro realizado, surgieron algunas uestiones rela

ionadas a la implementa

ión que se desta
an a

ontinua

ión.

A partir de la aproxima
ión utilizada, la transferen

## ia teóri

a obtenida resultó
er

ana a lo ideal. Al diseñar

las etapas y
one

tarlas en
as
ada, | y realizar la simula
ión no se obtuvo lo esperado, | y se realizaron a justes

a

iertos valores que modi

aban fa

tores Q de las 3 primeras etapas, más el a juste de ganan ia para poder

obtener nalmente una
urva

er

ana a la bus

ada, pero que posee un pequeño sobrepi

o de todas formas.

Al implementar el
ir

uito en forma prá
ti

a, fue ne
esario que los
apa

itores estén mat

hados (utilizando

el analizador de impedan

ias), y realizar la
alibra

## ión

on los presets men

ionados. | Aún así, | si bien se logró

que el ltro
umpla la plantilla propuesta, la

urva de transferen
ia posee un sobrepi
| o.

La realiza

ión de la pla
a en sí no tra jo mayores in

onvenientes.

Una posible mejora a las di ultades de

alibra

ión puede implementarse

ambiando la ter
era etapa por

una

elda universal KHN

omo las primeras dos, debidos a los valores altos de sensibilidad obtenidos para
ω0 y Q.

Luego de
one

tar la pla

a por primera vez, debe esperarse unos minutos hasta que se estabili

e la tempe-

ratura del
ir

uito para luego

alibrar.
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
