tc-grupo-4/TP--FINAL/Diseño/publish/Plantillas/HighpassImg2.png

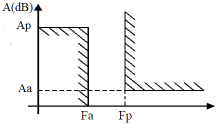
Diseño/publish/Plantillas/HighpassImg2.png
