tc-grupo-4/TP--FINAL/Diseño/publish/Plantillas/LowpassImg2.png

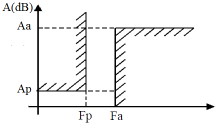
Diseño/publish/Plantillas/LowpassImg2.png
