tc-grupo-4/TP--FINAL/Diseño/publish/Plantillas/StopbandImg2.png

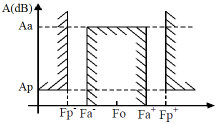
Diseño/publish/Plantillas/StopbandImg2.png
