tc-grupo-4/TP--FINAL/Diseño/publish/Stages Schematics/Diff_Inv.png

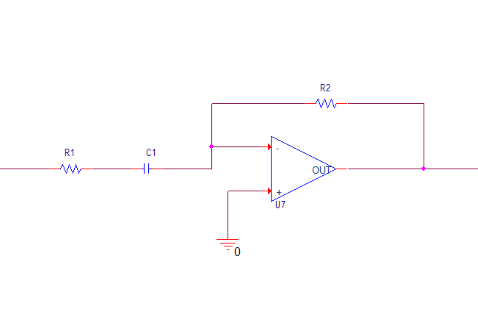
Diseño/publish/Stages Schematics/Diff_Inv.png
