tc-grupo-4/TP--FINAL/Diseño/publish/Stages Schematics/Int_Inv.png

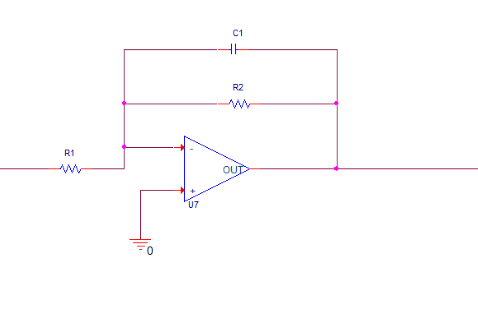
Diseño/publish/Stages Schematics/Int_Inv.png
