tc-grupo-4/TP--FINAL/Diseño/publish/Stages Schematics/KHN_BS.PNG

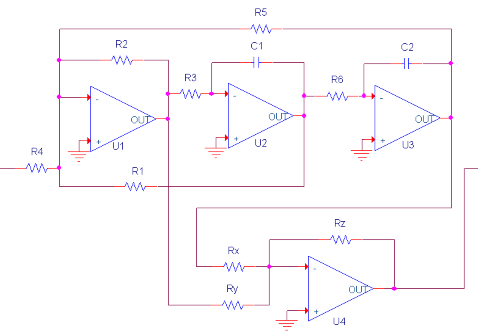
Diseño/publish/Stages Schematics/KHN_BS.PNG
