tc-grupo-4/TP--FINAL/Diseño/publish/Stages Schematics/Sedra_HPNotch.png

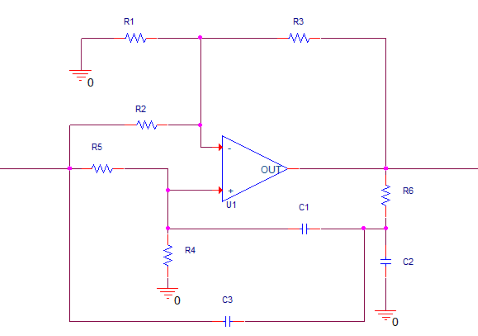
Diseño/publish/Stages Schematics/Sedra_HPNotch.png
