tc-grupo-4/TP--FINAL/Diseño/publish/Stages Schematics/SK_LP_A.PNG

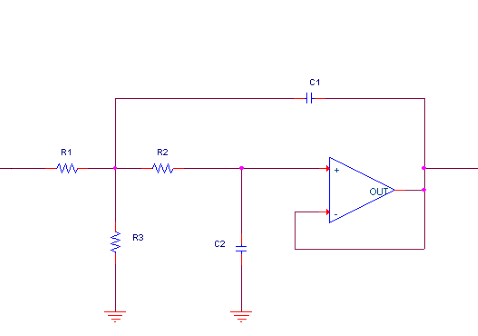
Diseño/publish/Stages Schematics/SK_LP_A.PNG
