tc-grupo-4/TP--FINAL/Diseño/publish/Stages Schematics/TF.PNG

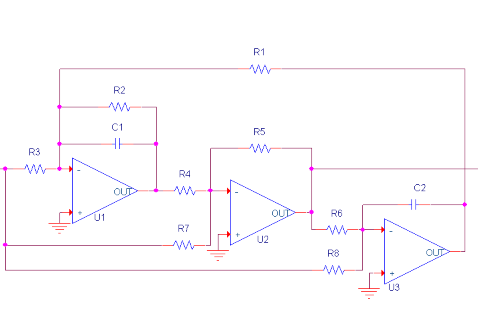
Diseño/publish/Stages Schematics/TF.PNG
