tc-grupo-4/TP--FINAL/Informe/Resources/simulacionVSmedicion.png

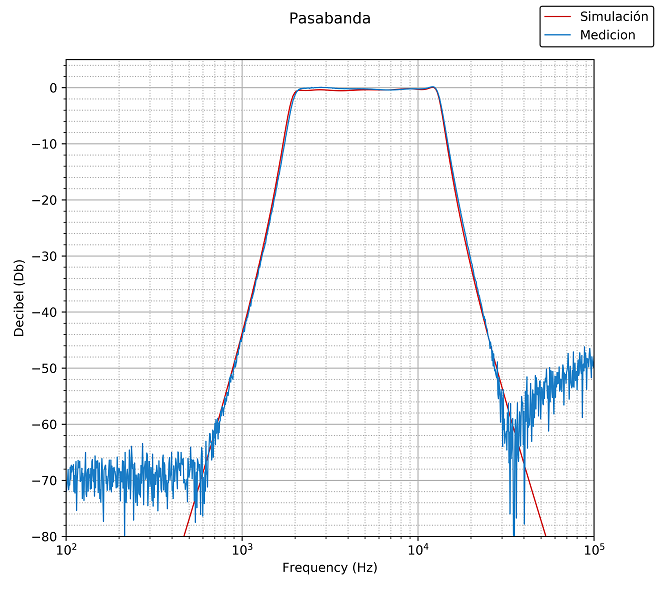
Informe/Resources/simulacionVSmedicion.png
