tc-grupo-4/TP--FINAL/Informe/Resources/simulacionVSmedicionBANDAATENUADA.png

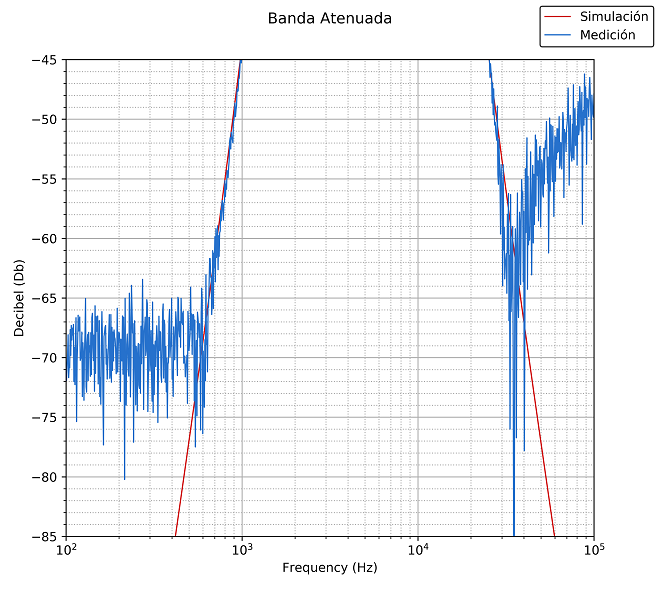
Informe/Resources/simulacionVSmedicionBANDAATENUADA.png
