tc-grupo-4/TP--FINAL/Informe/Resources/simulacionVSmedicionBANDAPASANTE.png

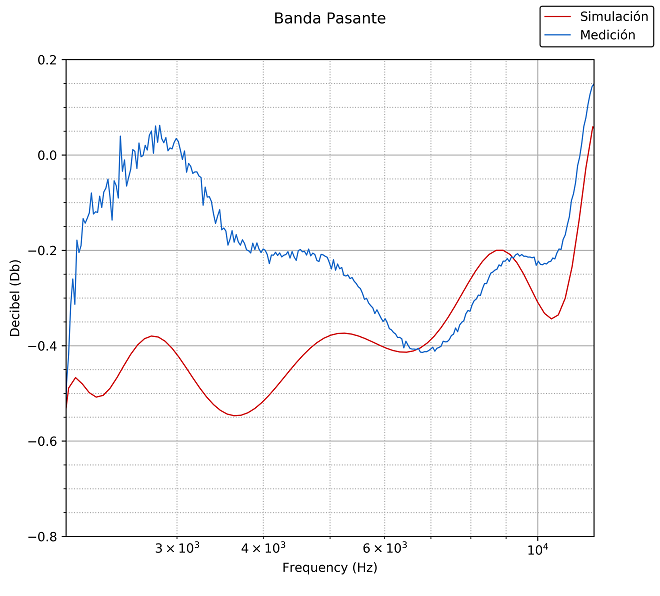
Informe/Resources/simulacionVSmedicionBANDAPASANTE.png
