tc-grupo-4/TP--FINAL/Informe/Resources/simulacionVSmedicionFASE.png

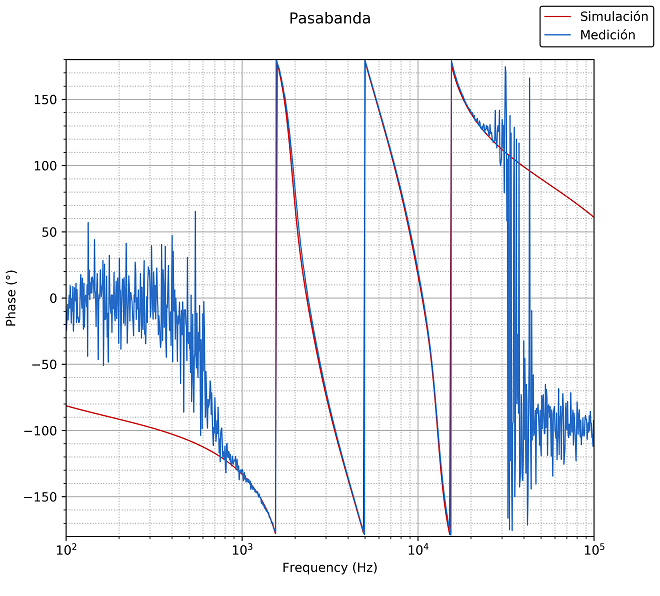
Informe/Resources/simulacionVSmedicionFASE.png
