tc-grupo-4/TP--FINAL/Mediciones/16-11-19/Medicion Pasabanda 10mV.png

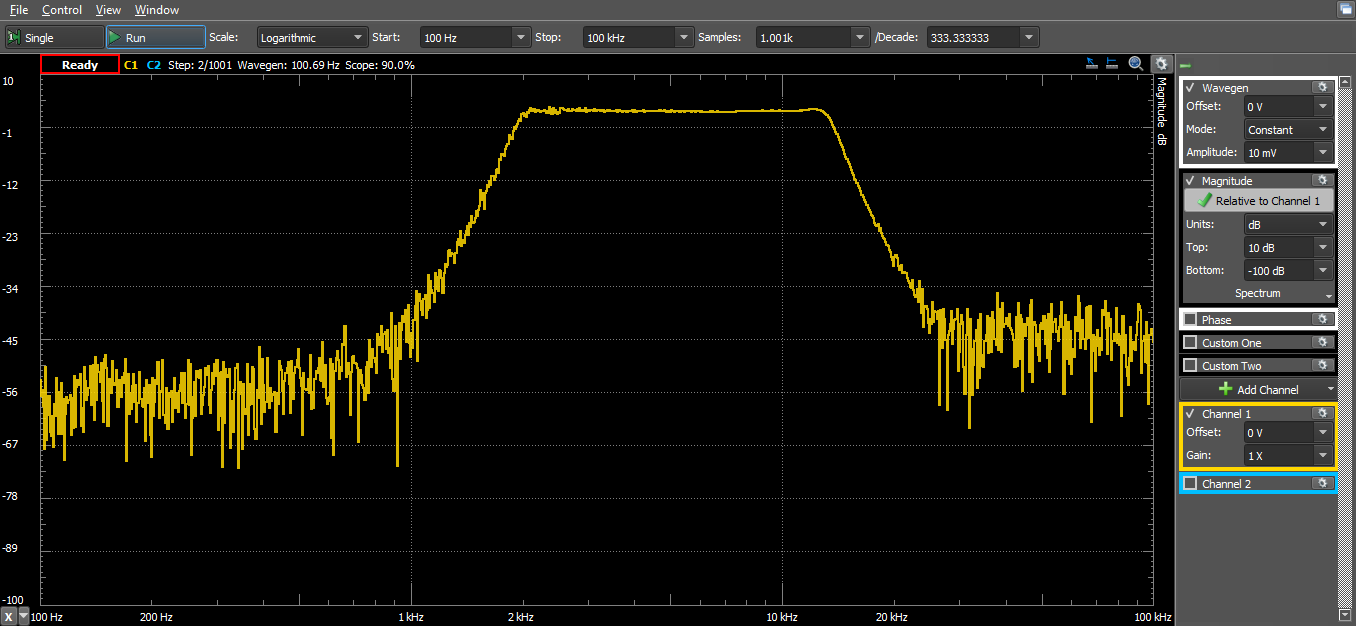
Mediciones/16-11-19/Medicion Pasabanda 10mV.png
