tc-grupo-4/TP--FINAL/Mediciones/Fotos/BandaPasante.png

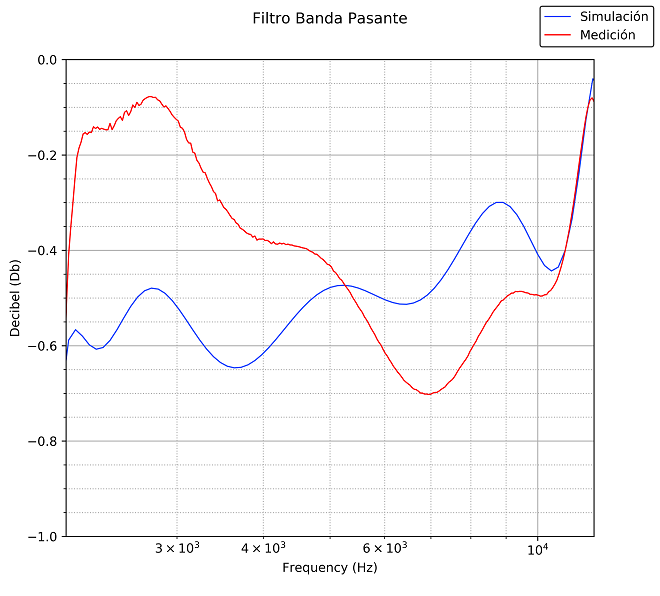
Mediciones/Fotos/BandaPasante.png
