tc-grupo-4/TP--FINAL/Mediciones/Fotos/Etapa1.png

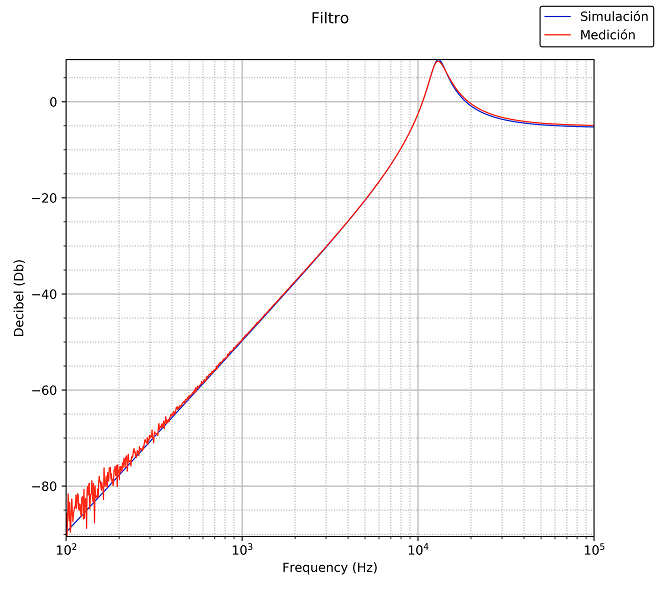
Mediciones/Fotos/Etapa1.png
