tc-grupo-4/TP--FINAL/Mediciones/Fotos/Etapa1Cal.PNG

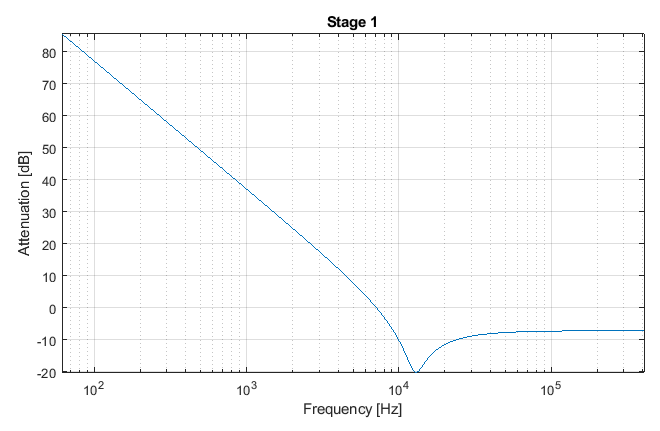
Mediciones/Fotos/Etapa1Cal.PNG
