tc-grupo-4/TP--FINAL/Mediciones/Fotos/Etapa2.png

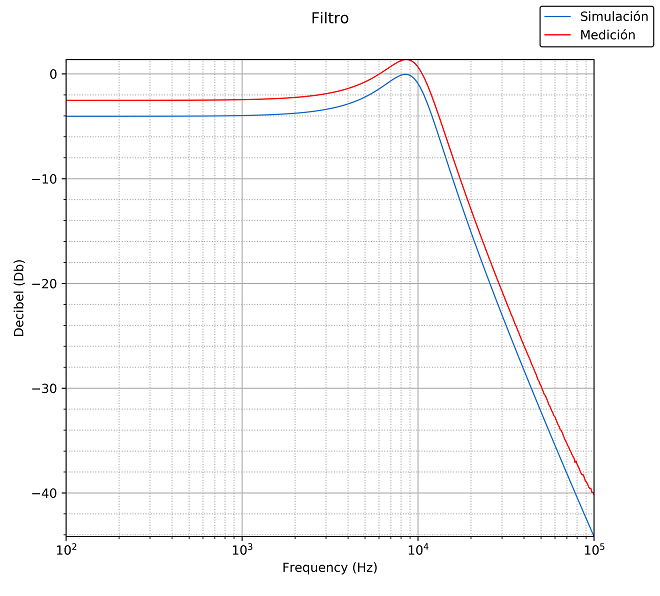
Mediciones/Fotos/Etapa2.png
