tc-grupo-4/TP--FINAL/Mediciones/Fotos/Etapa2Cal.PNG

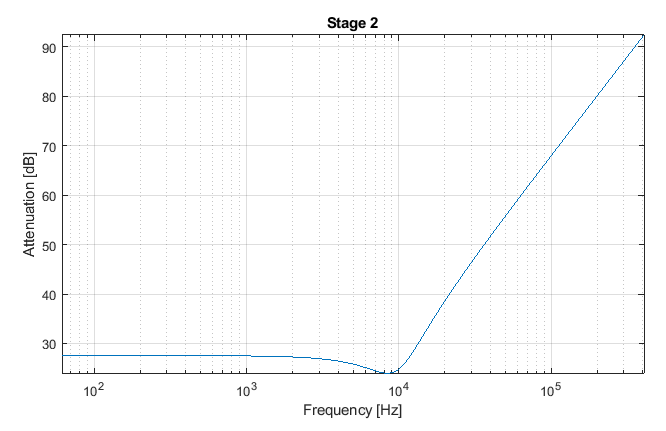
Mediciones/Fotos/Etapa2Cal.PNG
