tc-grupo-4/TP--FINAL/Mediciones/Fotos/Etapa3.png

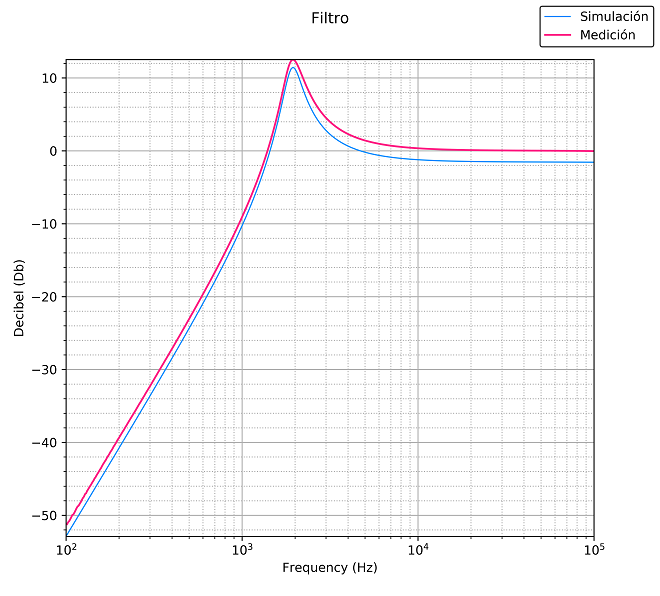
Mediciones/Fotos/Etapa3.png
