tc-grupo-4/TP--FINAL/Mediciones/Fotos/Etapa3Cal.PNG

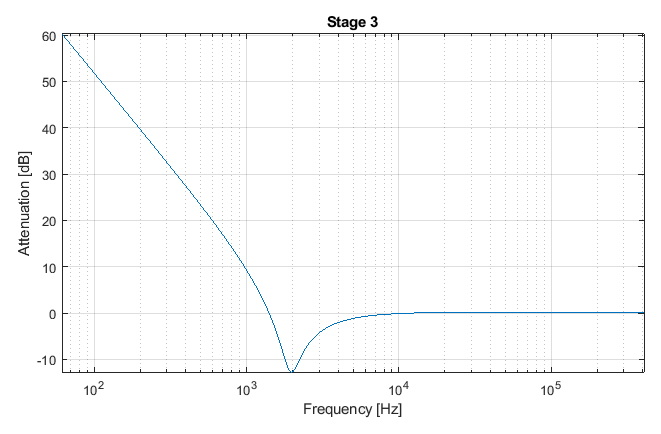
Mediciones/Fotos/Etapa3Cal.PNG
