tc-grupo-4/TP--FINAL/Mediciones/Fotos/Etapa4.png

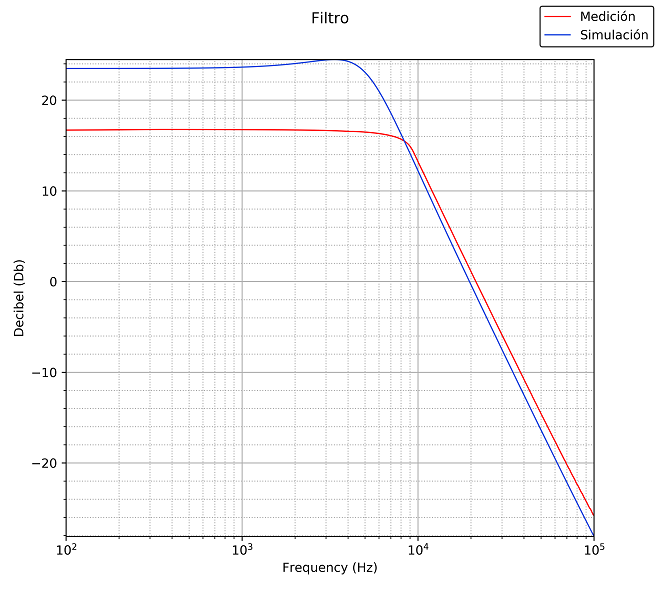
Mediciones/Fotos/Etapa4.png
