tc-grupo-4/TP--FINAL/Mediciones/Fotos/Etapa4Cal.PNG

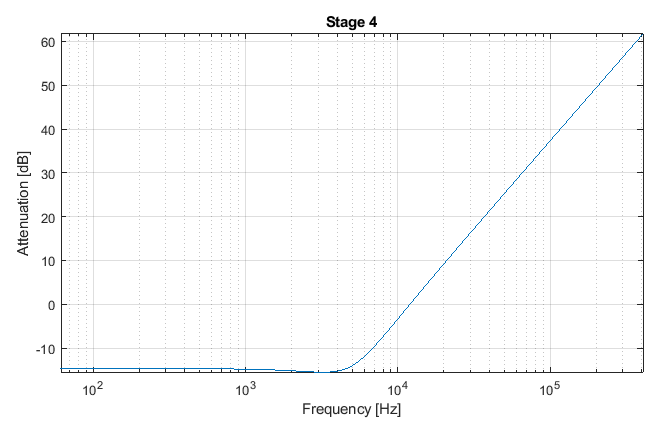
Mediciones/Fotos/Etapa4Cal.PNG
