tc-grupo-4/TP--FINAL/Mediciones/Fotos/Etapa5.png

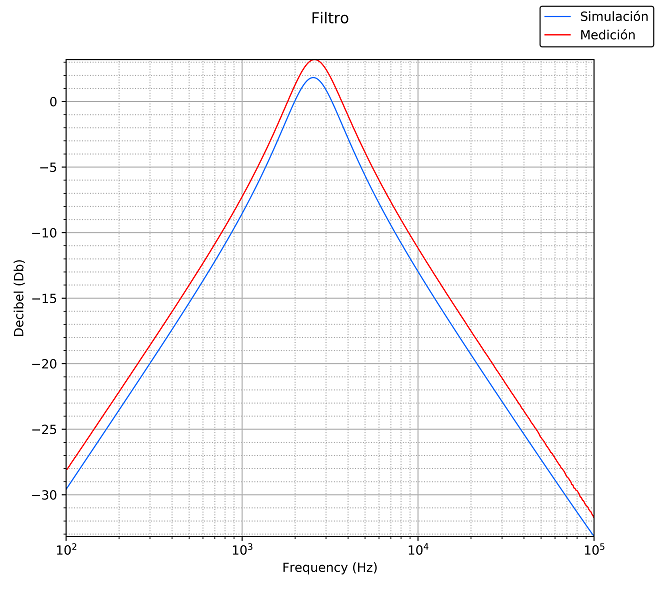
Mediciones/Fotos/Etapa5.png
