tc-grupo-4/TP--FINAL/Mediciones/Fotos/Etapa5Cal.PNG

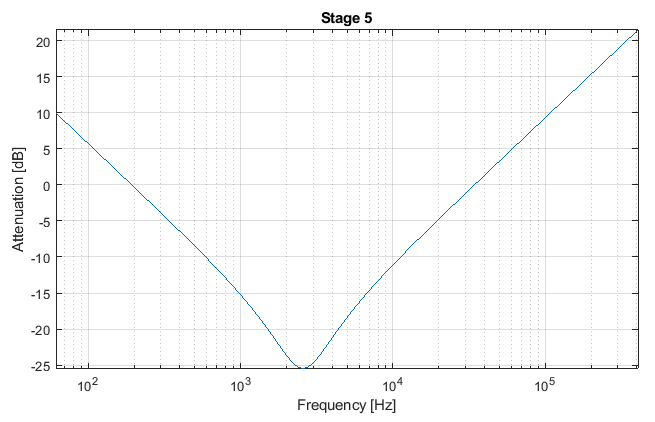
Mediciones/Fotos/Etapa5Cal.PNG
