tc-grupo-4/TP--FINAL/Mediciones/Fotos/Etapa12.png

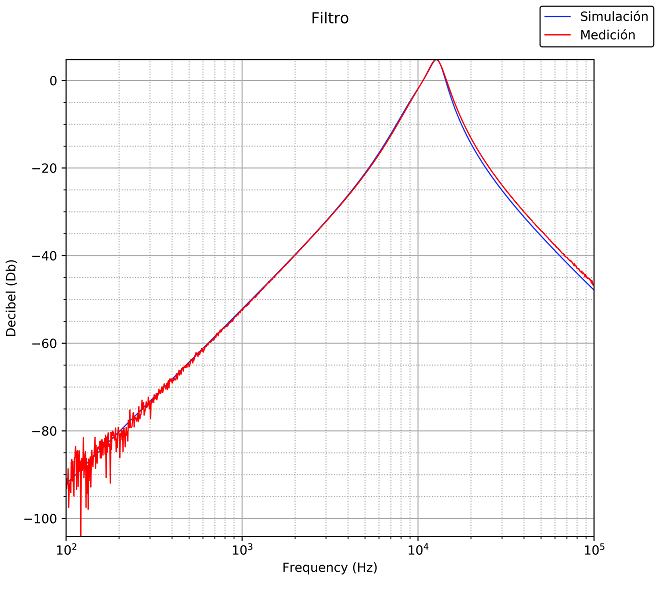
Mediciones/Fotos/Etapa12.png
