tc-grupo-4/TP--FINAL/Mediciones/Fotos/Etapa123.png

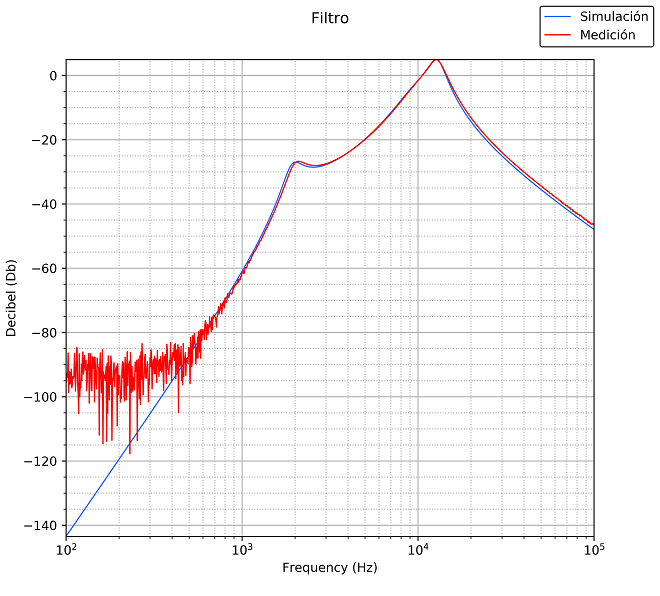
Mediciones/Fotos/Etapa123.png
