tc-grupo-4/TP--FINAL/Mediciones/Fotos/Etapa1234.png

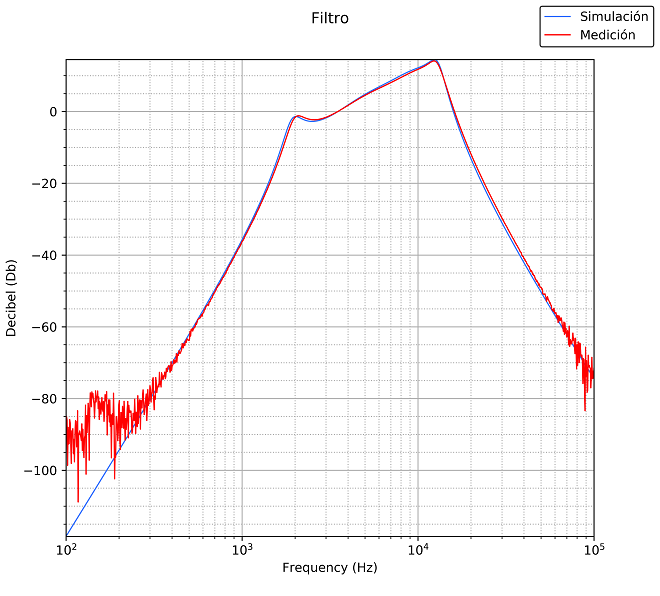
Mediciones/Fotos/Etapa1234.png
