tc-grupo-4/TP--FINAL/Mediciones/Fotos/Etapas acumuladas.png

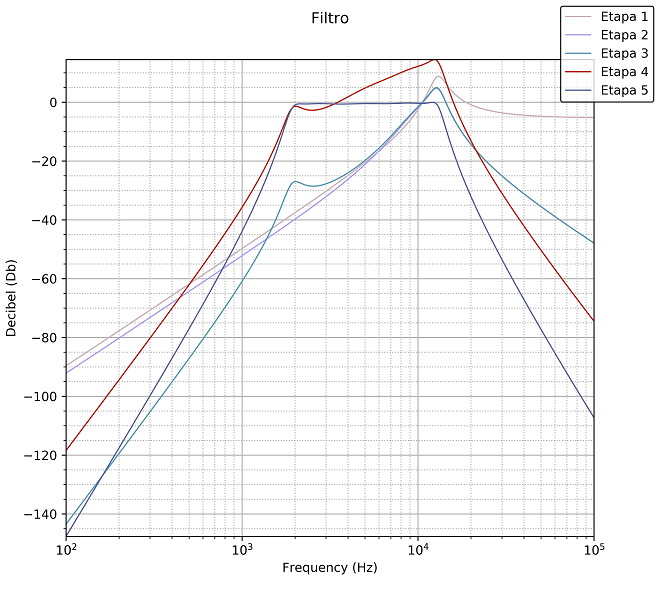
Mediciones/Fotos/Etapas acumuladas.png
