tc-grupo-4/TP--FINAL/Mediciones/Fotos/FiltroFinal.png

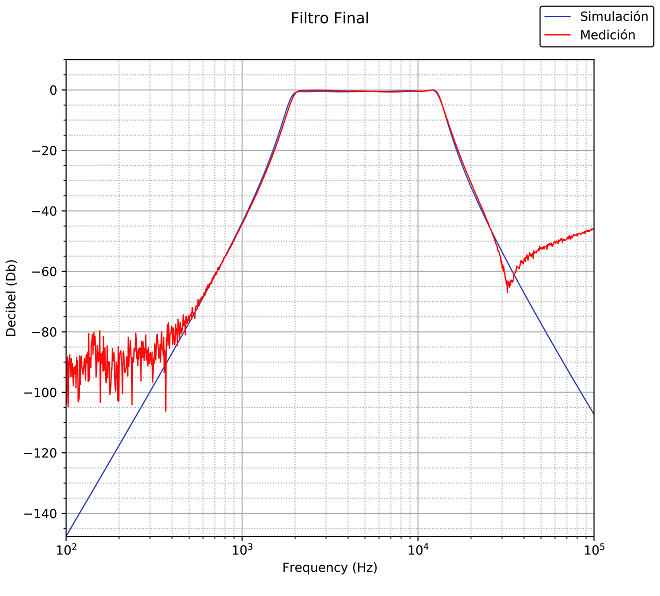
Mediciones/Fotos/FiltroFinal.png
