tc-grupo-4/TP--FINAL/Mediciones/Fotos/Respuesta al escalon.png

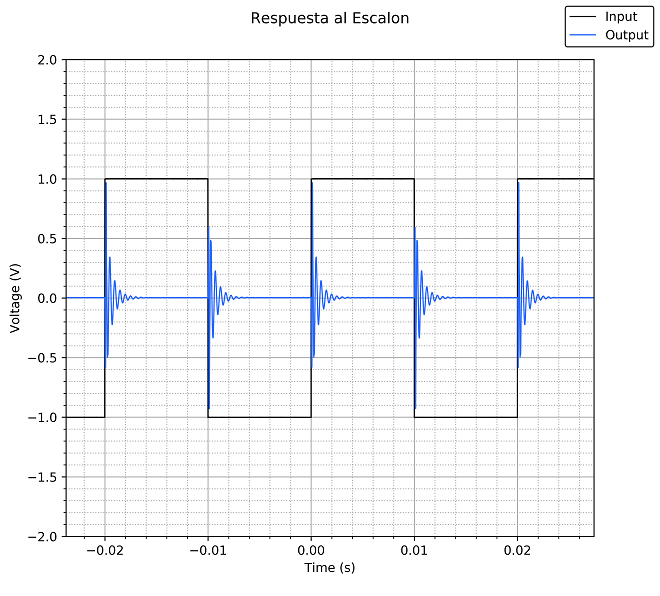
Mediciones/Fotos/Respuesta al escalon.png
