tc-grupo-4/TP--FINAL/TPs Viejos/TP Filtro Final - Grupo Rama/Filtro Final TC/Valores .xlsx

Etapa1
R1: 4.9574e+05
R2: 3.0534e+05
R3: 3.0534e+05
R4: 8.1335e+05
R5: 1.4742e+05
R6: 4.9221e+03
R7: 3000
R8: 3000
C1: 1.0000e-09
C2: 1.0000e-09
 | Etapa2
 | R1: 4.6660e+05
 | R2: 5.3955e+04
 | R3: 5.3955e+04
 | R4: 3.9909e+05
 | R5: 7.8739e+04
 | R6: 2.5659e+03
 | R7: 3000
 | R8: 3000
 | C1: 1.0000e-09
 | C2: 1.0000e-09
Etapa3
R1: 2.9690e+04
R2: 1.1733e+05
R3: 1.1733e+05
R4: 1.5768e+04
R5: 6.2312e+04
R6: 1.5933e+03
R7: 3000
R8: 3000
C1: 1.0000e-09
C2: 1.0000e-09
 | Etapa4
 | R1: 2.2066e+06
 | R2: 2.5515e+05
 | R3: 2.5515e+05
 | R4: 3.8964e+06
 | R5: 2.6406e+05
 | R6: 5.2975e+03
 | R7: 3000
 | R8: 3000
 | C1: 1.0000e-09
 | C2: 1.0000e-09
 | Etapa5
 | R1: 7.3199e+04
 | R2: 4.5086e+04
 | R3: 4.5086e+04
 | R4: 5.6917e+04
 | R5: 1.1913e+05
 | R6: 2.3327e+03
 | R7: 3000
 | R8: 3000
 | C1: 1.0000e-09
 | C2: 1.0000e-09
