tc-grupo-4/TP--FINAL/Mediciones/16-11-19/Medición Filtro Calibrado.csv

Frequency (Hz) | Channel 1 Magnitude (dB) | Channel 2 Magnitude (dB) | Channel 2 Phase (deg)
100 | 0.02207334 | -70.48706868 | -24.56125424
100.6931669 | 0.023294647 | -71.89993062 | -24.10412464
101.3911386 | 0.024016039 | -70.84950753 | -13.05784578
102.0939484 | 0.023040248 | -69.71524298 | -4.974210952
102.8016298 | 0.021917499 | -68.08975379 | -16.57500246
103.5142167 | 0.023245672 | -71.68030224 | -6.676188324
104.2317429 | 0.02097812 | -70.73369666 | 1.966942974
104.9542429 | 0.0237573 | -70.84594381 | -7.628675658
105.6817509 | 0.02404596 | -67.65500502 | 9.16659406
106.4143018 | 0.022348863 | -69.81219671 | -1.6428965
107.1519305 | 0.020671133 | -67.30876497 | -18.92866838
107.8946722 | 0.023775599 | -68.52837523 | -0.690699151
108.6425624 | 0.022661127 | -67.53313677 | -9.859381388
109.3956366 | 0.023660723 | -68.10505217 | 8.576673713
110.153931 | 0.023048928 | -67.22654586 | -24.92468235
110.9174815 | 0.023489265 | -72.01060439 | -14.70161837
111.6863248 | 0.022551575 | -69.15406589 | 7.70879636
112.4604974 | 0.022322306 | -72.26707239 | -0.615054845
113.2400363 | 0.023929641 | -68.22997143 | -2.143416534
114.0249788 | 0.021020688 | -66.65586016 | 11.04335349
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
