tc-grupo-4/TP--FINAL/Mediciones/Mediciones Con Todo calibrado/Etapa1.csv

Frequency (Hz) | Channel 2 Magnitude (dB) | Channel 2 Phase (deg)
100 | -85.27751763 | -10.22198645
100.6931669 | -85.75364607 | -4.996973358
101.3911386 | -90.47558927 | 9.375045238
102.0939484 | -86.39150835 | -24.30474704
102.8016298 | -81.64102898 | 13.09448224
103.5142167 | -84.90309761 | -6.617488119
104.2317429 | -87.22109234 | 27.67446438
104.9542429 | -83.38578236 | 3.922944261
105.6817509 | -89.57280689 | 23.97221101
106.4143018 | -88.73124385 | 25.2987426
107.1519305 | -85.10889542 | 11.43240903
107.8946722 | -82.71857562 | 38.77782875
108.6425624 | -85.31566673 | 4.212766633
109.3956366 | -87.39931732 | 32.81370673
110.153931 | -85.99983674 | -17.54190536
110.9174815 | -85.16273674 | 8.892767635
111.6863248 | -84.37975133 | 19.98007624
112.4604974 | -84.61583092 | 32.39496157
113.2400363 | -83.85528169 | 6.373404801
114.0249788 | -81.90774457 | 25.20305356
114.8153621 | -84.65520268 | 21.49573957
115.6112242 | -82.89594276 | 11.39998466
116.4126029 | -81.61946359 | -2.88748135
117.2195366 | -81.81673739 | 3.567488084
118.0320636 | -84.73811955 | -13.33861342
118.8502227 | -85.02909073 | 10.38336908
119.6740531 | -83.7093481 | -21.85552045
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
