tc-grupo-4/TP--FINAL/Mediciones/Mediciones Con Todo calibrado/Etapa12.csv

Frequency (Hz) | Channel 2 Magnitude (dB) | Channel 2 Phase (deg)
100 | -91.58395105 | -118.9258073
100.6931669 | -93.17095915 | -138.2666777
101.3911386 | -90.98631226 | -155.820549
102.0939484 | -92.13776581 | 107.2642056
102.8016298 | -88.67577797 | -140.1217816
103.5142167 | -97.46956523 | -100.4502719
104.2317429 | -93.86453363 | -136.3574726
104.9542429 | -92.00460508 | -142.3119446
105.6817509 | -91.56345904 | 129.1322451
106.4143018 | -94.1270478 | 123.7978151
107.1519305 | -87.22056573 | -168.4652589
107.8946722 | -86.55778081 | -145.5784276
108.6425624 | -91.45886201 | 179.3355024
109.3956366 | -86.96362225 | -145.2794204
110.153931 | -92.79348944 | 157.4949964
110.9174815 | -94.89061563 | -169.9348363
111.6863248 | -86.22224196 | -150.6800891
112.4604974 | -86.07412521 | -137.4530863
113.2400363 | -83.56767426 | 179.9877092
114.0249788 | -85.93724746 | -64.55205791
114.8153621 | -93.38477825 | -89.69092675
115.6112242 | -84.70043695 | -167.085603
116.4126029 | -84.50378175 | -160.3228618
117.2195366 | -92.70937918 | -166.2814544
118.0320636 | -86.82759276 | -167.614209
118.8502227 | -84.5745629 | -108.2830129
119.6740531 | -89.23711011 | 135.8502818
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
