tc-grupo-4/TP--FINAL/Mediciones/Mediciones Con Todo calibrado/Etapa123.csv

Frequency (Hz) | Channel 2 Magnitude (dB) | Channel 2 Phase (deg)
100 | -87.39836035 | 0.095769772
100.6931669 | -95.47805266 | -150.0704231
101.3911386 | -92.70041244 | -80.50872792
102.0939484 | -93.82088428 | -13.75199268
102.8016298 | -86.39420336 | -105.0227054
103.5142167 | -98.67579383 | -2.608935897
104.2317429 | -92.23082667 | 57.42059514
104.9542429 | -96.206058 | -173.6124671
105.6817509 | -92.47404437 | 99.71080956
106.4143018 | -95.86131709 | 173.9883686
107.1519305 | -91.42536227 | -27.27927964
107.8946722 | -97.2155846 | 71.07096078
108.6425624 | -96.07696777 | -106.4515158
109.3956366 | -93.69109873 | 43.2788537
110.153931 | -94.24317472 | 26.14842368
110.9174815 | -93.8042364 | -52.76126389
111.6863248 | -86.48868388 | 32.21129957
112.4604974 | -91.59331084 | 103.5399169
113.2400363 | -98.23251599 | -66.02622618
114.0249788 | -92.91787444 | -167.6965776
114.8153621 | -84.62924663 | 13.65224813
115.6112242 | -84.91806988 | 50.39439241
116.4126029 | -95.71721907 | 68.16569138
117.2195366 | -98.8193992 | -34.39483071
118.0320636 | -105.2187809 | -148.9976789
118.8502227 | -86.65534679 | -49.05478219
119.6740531 | -100.0059301 | -49.30207496
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
