tc-grupo-4/TP--FINAL/Mediciones/Mediciones Con Todo calibrado/Etapa1234.csv

Frequency (Hz) | Channel 2 Magnitude (dB) | Channel 2 Phase (deg)
100 | -87.00129074 | -80.80292911
100.6931669 | -85.01752522 | -102.8281993
101.3911386 | -85.99630128 | -150.5653904
102.0939484 | -98.62284226 | -3.696229213
102.8016298 | -88.02801445 | 59.19710406
103.5142167 | -92.68961659 | 129.3479569
104.2317429 | -92.6034284 | -74.91824942
104.9542429 | -85.87600952 | -40.50254675
105.6817509 | -86.8355762 | -67.17036463
106.4143018 | -92.31867281 | -27.34673052
107.1519305 | -98.07376117 | -102.0147967
107.8946722 | -89.08560736 | 127.7573979
108.6425624 | -88.81603877 | -129.321207
109.3956366 | -88.42182971 | 75.58388501
110.153931 | -95.37926199 | 59.20125905
110.9174815 | -91.39679639 | -71.52976843
111.6863248 | -97.64994413 | 93.14416002
112.4604974 | -89.80830538 | 25.33253804
113.2400363 | -86.20662686 | 58.37275748
114.0249788 | -86.41119621 | 43.97559839
114.8153621 | -93.49766623 | 2.947853672
115.6112242 | -92.65025239 | -68.50213432
116.4126029 | -83.42299939 | -37.07741982
117.2195366 | -108.8447713 | -174.1880841
118.0320636 | -90.28180196 | 140.6577008
118.8502227 | -89.64639582 | -27.04486295
119.6740531 | -89.03001563 | 147.9930062
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
