tc-grupo-4/TP--FINAL/Mediciones/Mediciones Con Todo calibrado/Etapa2.csv

Frequency (Hz) | Channel 2 Magnitude (dB) | Channel 2 Phase (deg)
100 | -2.527153224 | 179.5979716
101.3911386 | -2.527352034 | 179.596991
102.8016298 | -2.527311887 | 179.5910997
104.2317429 | -2.526829888 | 179.5839652
105.6817509 | -2.526910506 | 179.5821657
107.1519305 | -2.527033136 | 179.5686031
108.6425624 | -2.526911918 | 179.5643836
110.153931 | -2.52688655 | 179.5601926
111.6863248 | -2.527006766 | 179.5531669
113.2400363 | -2.526716913 | 179.5451539
114.8153621 | -2.527472366 | 179.5423875
116.4126029 | -2.527053408 | 179.53238
118.0320636 | -2.527164027 | 179.5290733
119.6740531 | -2.52667292 | 179.5235029
121.338885 | -2.526761921 | 179.514041
123.0268771 | -2.527069551 | 179.5065934
124.7383514 | -2.526882103 | 179.4980699
126.4736347 | -2.527199133 | 179.4921188
128.2330583 | -2.526637461 | 179.4889112
130.0169578 | -2.527016153 | 179.4795494
131.8256739 | -2.526773819 | 179.4783581
133.6595517 | -2.526946221 | 179.464804
135.5189412 | -2.526358743 | 179.4575432
137.4041975 | -2.526928897 | 179.4489807
139.3156803 | -2.526948054 | 179.441799
141.2537545 | -2.526751403 | 179.4346363
143.2187899 | -2.52648542 | 179.4294797
145.2111618 | -2.526339206 | 179.4196178
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
