tc-grupo-4/TP--FINAL/TPs Viejos/TP Final - Grupo Mati/bottomLayer.pdf

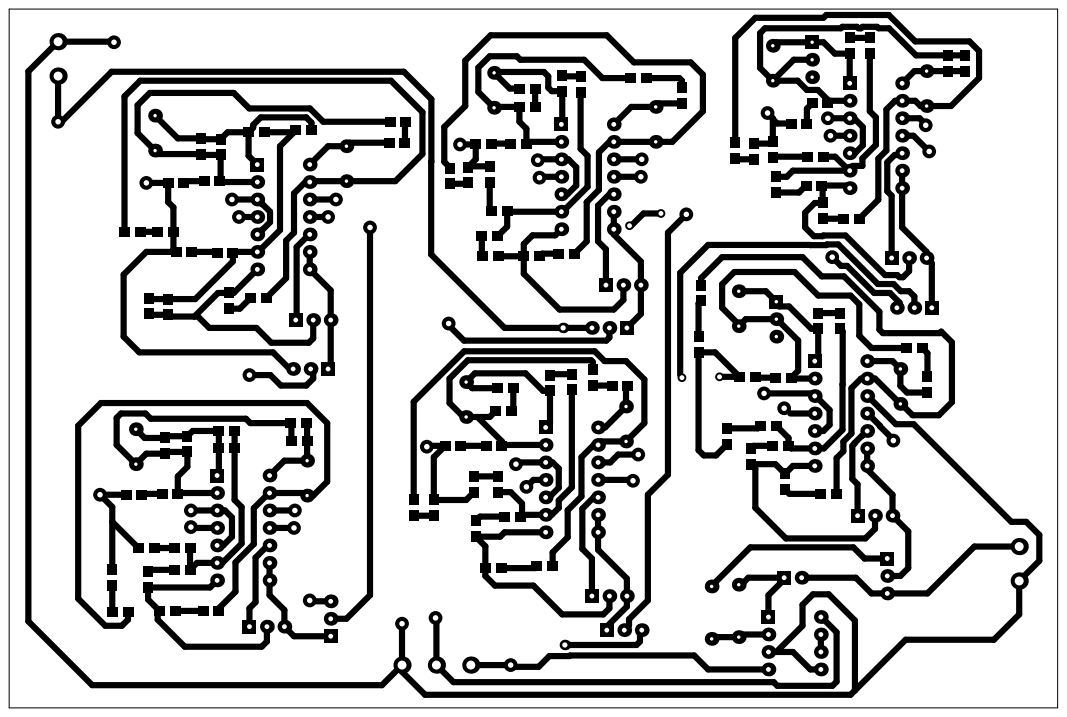
[picture p139: page 1]
