tc-grupo-4/TP--FINAL/TPs Viejos/TP Final - Grupo Mati/topLayer.pdf

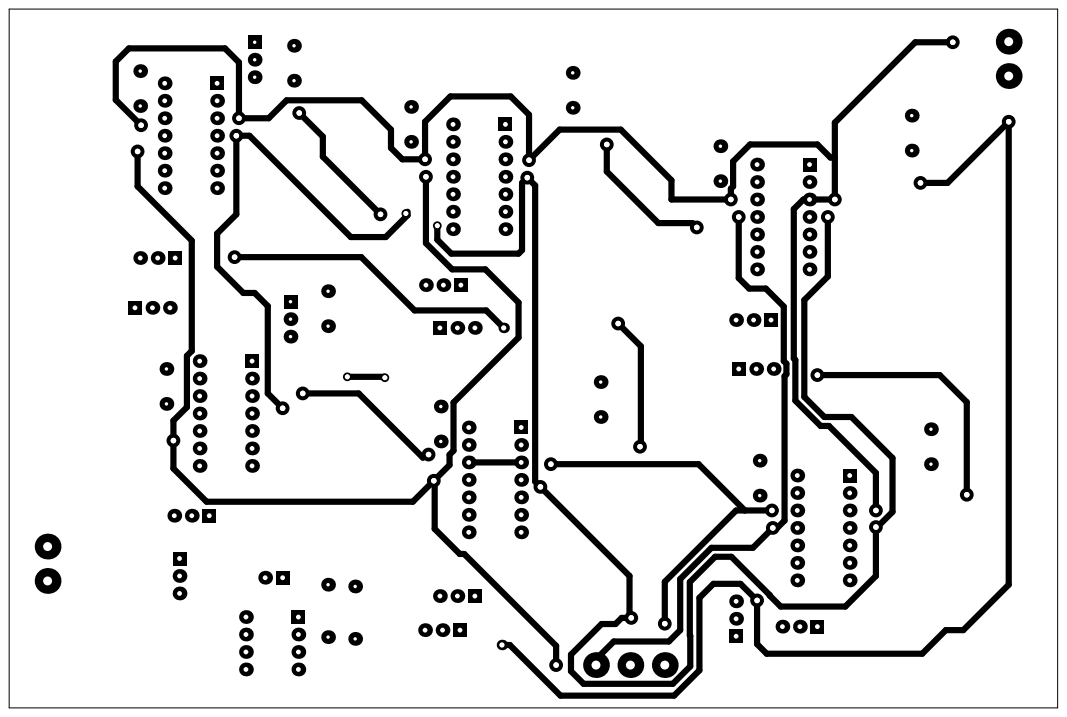
[picture p140: page 1]
