tc-grupo-4/TP--FINAL/Calculus/simulation_generated_20191114-182527.asc

C1: cap; {C1_5}
C1_2: cap; {C1_1}
C2: cap; {C2_5}
C2_2: cap; {C2_1}
C3: cap; {C1_3}
C4: cap; {C2_3}
C5: cap; {C1_2}
C6: cap; {C2_2}
C7: cap; {C1_4}
C8: cap; {C2_4}
R1: res; {R4_5}
R1_2: res; {R1_1}
R2: res; {R1_5}
R2_2: res; {R2_1}
R3: res; {R3_5}
R3_2: res; {R3_1}
R4: res; {R7_5}
R4_2: res; {R4_1}
R5: res; {R8_5}
R6: res; {R4_3}
R6_2: res; {R6_1}
R7: res; {R2_5}
R7_2: res; {R7_1}
R8: res; {R1_3}
R8_2: res; {R8_1}
R9: res; {R3_3}
R10: res; {R7_3}
R11: res; {R8_3}
R12: res; {R6_3}
R13: res; {R2_3}
R14: res; {R5_2}
R15: res; {R1_2}
R16: res; {R3_2}
R17: res; {R7_2}
R18: res; {R8_2}
R19: res; {R1_4}
R20: res; {R2_2}
R21: res; {R3_4}
R22: res; {R7_4}
R23: res; {R8_4}
R24: res; {R2_4}
R25: res; {R5_4}
R26: res; 50
R27: res; 100K
R28: res; 87K
U1: opamp2; TL082
U2: opamp2; TL082
U3: opamp2; TL082
U4: opamp2; TL082
U5: opamp2; TL082
U6: opamp2; TL082
U7: opamp2; TL082
U8: opamp2; TL082
U9: opamp2; TL082
U10: opamp2; TL082
U11: opamp2; TL082
U12: opamp2; TL082
U13: opamp2; TL082
U14: opamp2; TL082
U15: opamp2; TL082
U16: opamp2; TL082
V1: voltage; 15
V2: voltage; 15
V3: signal; ""; AC 1
Named nets: 0, Vin_1, Vin_2, Vin_5, Vout, +VCC, -VCC, Vin_3, Vin_4, VCC+, VCC-
.inc TL082.mod
.ac dec 100 100 100k
LOWPASS
HIGHPASS
LOWPASS
HIGHPASS
BANDPASS
.param R1_1 5600.0
.param R2_1 1500.0
.param R3_1 1000.0
.param R4_1 10000.0
.param R6_1 1800.0
.param R7_1 1000.0
.param R8_1 1000.0
.param C1_1 1e-08
.param C2_1 1e-08
.param R1_2 2400.0
.param R2_2 2700.0
.param R3_2 1000.0
.param R5_2 3600.0
.param R7_2 1000.0
.param R8_2 1000.0
.param C1_2 1e-08
.param C2_2 1e-08
.param R1_3 36000.0
.param R2_3 68000.0
.param R3_3 1000.0
.param R4_3 36000.0
.param R6_3 1000.0
.param R7_3 1000.0
.param R8_3 1000.0
.param C1_3 1e-08
.param C2_3 1e-08
.param R1_4 3000.0
.param R2_4 10000.0
.param R3_4 1000.0
.param R5_4 560.0
.param R7_4 1000.0
.param R8_4 1000.0
.param C1_4 1e-08
.param C2_4 1e-08
.param R1_5 9100.0
.param R2_5 39000.0
.param R3_5 1000.0
.param R4_5 6200.0
.param R7_5 1000.0
.param R8_5 1000.0
.param C1_5 1e-08
.param C2_5 1e-08
