tc-grupo-4/TP--FINAL/Calculus/simulation_generated_20191114-184212.asc

C1: cap; {mc(C1_5,tolC)}
C1_2: cap; {mc(C1_1,tolC)}
C2: cap; {mc(C2_5,tolC)}
C2_2: cap; {mc(C2_1,tolC)}
C3: cap; {mc(C1_3,tolC)}
C4: cap; {mc(C2_3,tolC)}
C5: cap; {mc(C1_2,tolC)}
C6: cap; {mc(C2_2,tolC)}
C7: cap; {mc(C1_4,tolC)}
C8: cap; {mc(C2_4,tolC)}
R1: res; {mc(R4_5,tolR)}
R1_2: res; {mc(R1_1,tolR)}
R2: res; {mc(R1_5,tolR)}
R2_2: res; {mc(R2_1,tolR)}
R3: res; {mc(R3_5,tolR)}
R3_2: res; {mc(R3_1,tolR)}
R4: res; {mc(R7_5,tolR)}
R4_2: res; {mc(R4_1,tolR)}
R5: res; {mc(R8_5,tolR)}
R6: res; {mc(R4_3,tolR)}
R6_2: res; {mc(R6_1,tolR)}
R7: res; {mc(R2_5,tolR)}
R7_2: res; {mc(R7_1,tolR)}
R8: res; {mc(R1_3,tolR)}
R8_2: res; {mc(R8_1,tolR)}
R9: res; {mc(R3_3,tolR)}
R10: res; {mc(R7_3,tolR)}
R11: res; {mc(R8_3,tolR)}
R12: res; {mc(R6_3,tolR)}
R13: res; {mc(R2_3,tolR)}
R14: res; {mc(R5_2,tolR)}
R15: res; {mc(R1_2,tolR)}
R16: res; {mc(R3_2,tolR)}
R17: res; {mc(R7_2,tolR)}
R18: res; {mc(R8_2,tolR)}
R19: res; {mc(R1_4,tolR)}
R20: res; {mc(R2_2,tolR)}
R21: res; {mc(R3_4,tolR)}
R22: res; {mc(R7_4,tolR)}
R23: res; {mc(R8_4,tolR)}
R24: res; {mc(R2_4,tolR)}
R25: res; {mc(R5_4,tolR)}
R26: res; 100k
R27: res; 89.1k
R28: res; 50
U1: opamp2; TL082
U2: opamp2; TL082
U3: opamp2; TL082
U4: opamp2; TL082
U5: opamp2; TL082
U6: opamp2; TL082
U7: opamp2; TL082
U8: opamp2; TL082
U9: opamp2; TL082
U10: opamp2; TL082
U11: opamp2; TL082
U12: opamp2; TL082
U13: opamp2; TL082
U14: opamp2; TL082
U15: opamp2; TL082
U16: opamp2; TL082
V1: voltage; 15
V2: voltage; 15
V3: signal; ""; AC 1
Named nets: 0, Vin_1, Vin_2, Vin_5, Vin_6, +VCC, -VCC, Vin_3, Vin_4, VCC+, VCC-
.inc TL082.mod
.ac dec 100 100 100k
LOWPASS
HIGHPASS
LOWPASS
HIGHPASS
BANDPASS
.param tolR=0.01
.param tolC=0.01
.step param run 1 20 1
.param R1_1 5600.0
.param R2_1 1500.0
.param R3_1 1000.0
.param R4_1 10000.0
.param R6_1 1800.0
.param R7_1 1000.0
.param R8_1 1000.0
.param C1_1 1e-08
.param C2_1 1e-08
.param R1_2 2400.0
.param R2_2 2700.0
.param R3_2 1000.0
.param R5_2 3600.0
.param R7_2 1000.0
.param R8_2 1000.0
.param C1_2 1e-08
.param C2_2 1e-08
.param R1_3 36000.0
.param R2_3 68000.0
.param R3_3 1000.0
.param R4_3 36000.0
.param R6_3 1000.0
.param R7_3 1000.0
.param R8_3 1000.0
.param C1_3 1e-08
.param C2_3 1e-08
.param R1_4 3000.0
.param R2_4 10000.0
.param R3_4 1000.0
.param R5_4 560.0
.param R7_4 1000.0
.param R8_4 1000.0
.param C1_4 1e-08
.param C2_4 1e-08
.param R1_5 9100.0
.param R2_5 39000.0
.param R3_5 1000.0
.param R4_5 6200.0
.param R7_5 1000.0
.param R8_5 1000.0
.param C1_5 1e-08
.param C2_5 1e-08
