tc-grupo-4/TP--FINAL/Calculus/simulation_template.asc

C1: cap; {C1_5}
C1_2: cap; {C1_1}
C2: cap; {C2_5}
C2_2: cap; {C2_1}
C3: cap; {C1_3}
C3_4: cap; {C1_4}
C4: cap; {C2_3}
C4_4: cap; {C2_4}
C5: cap; {C1_2}
C6: cap; {C2_2}
R1: res; {R4_5}
R1_2: res; {R1_1}
R2: res; {R1_5}
R2_2: res; {R2_1}
R3: res; {R3_5}
R3_2: res; {R3_1}
R4: res; {R7_5}
R4_2: res; {R4_1}
R5: res; {R8_5}
R6: res; {R4_3}
R6_2: res; {R6_1}
R6_4: res; {R1_4}
R7: res; {R2_5}
R7_2: res; {R7_1}
R8: res; {R1_3}
R8_2: res; {R8_1}
R8_4: res; {R2_4}
R9: res; {R3_3}
R10: res; {R7_3}
R11: res; {R8_3}
R12: res; {R6_3}
R13: res; {R2_3}
R14: res; {R5_2}
R15: res; {R1_2}
R16: res; {R3_2}
R17: res; {R7_2}
R18: res; {R8_2}
R20: res; {R2_2}
RA_4: res; {RA_4}
RB_4: res; {RB_4}
U1: opamp2; TL082
U2: opamp2; TL082
U3: opamp2; TL082
U4: opamp2; TL082
U5: opamp2; TL082
U6: opamp2; TL082
U7: opamp2; TL082
U8: opamp2; TL082
U9: opamp2; TL082
U10: opamp2; TL082
U11: opamp2; TL082
U12: opamp2; TL082
U13: opamp2; TL082
V1: voltage; 15
V2: voltage; 15
V3: signal; ""; AC 1
Named nets: 0, Vin_3, Vin_4, +VCC, -VCC, Vin_5, Vout_5, Vin_1, Vin_2
.inc TL082.mod
.ac dec 100 100 100k
LOWPASS
HIGHPASS
LOWPASS
HIGHPASS
BANDPASS
