tc-grupo-4/TP--FINAL/(list of files, drawings)

Other design files:
Altium/Esquemático.SchDoc
Altium/PCB1.PcbDoc
Altium/PCB.PcbDoc
Altium/Proyecto.PrjPCB
Altium/universal_flech.SchDoc
TPs Viejos/Filtro Final - Grupo Malu/placa filtro final/ff.PcbDoc
TPs Viejos/Filtro Final - Grupo Malu/placa filtro final/ff.SchDoc
TPs Viejos/Filtro Final - Grupo Malu/placa filtro final/placa filtro final.PrjPcb
TPs Viejos/TP Filtro Final - Grupo Rama/Altium/Esquemático entero.SchDoc
TPs Viejos/TP Filtro Final - Grupo Rama/Altium/Filtro Final.PcbDoc
TPs Viejos/TP Filtro Final - Grupo Rama/Altium/Final_Filter.PrjPCB
TPs Viejos/TP Filtro Final - Grupo Rama/Altium/FlescherTow.SchDoc
TPs Viejos/TP Filtro Final - Grupo Rama/Altium/Gain.SchDoc
TPs Viejos/TP Filtro Final - Grupo Rama/Altium/OutputLowpas.SchDoc
TPs Viejos/TP Filtro Final - Grupo Rama/Altium/SEDRA HPN.SchDoc
TPs Viejos/TP Filtro Final - Grupo Rama/Altium/Sedra LPN.SchDoc
TPs Viejos/TP Filtro Final - Grupo Rama/Altium/SPres.PcbLib
TPs Viejos/TP Filtro Final - Grupo Rama/Altium/SPres.SchDoc
TPs Viejos/TP Filtro Final - Grupo Rama/Altium/SPres.SchLib
TPs Viejos/TP Filtro Final - Grupo Rama/Altium/SRcap.PcbLib
TPs Viejos/TP Filtro Final - Grupo Rama/Altium/SRcap.SchLib
TPs Viejos/TP Final - Grupo Marce/Placa/FiltroHPFinal/ConectoresAdicionales.SchDoc
TPs Viejos/TP Final - Grupo Marce/Placa/FiltroHPFinal/Etapas_Parte1.SchDoc
TPs Viejos/TP Final - Grupo Marce/Placa/FiltroHPFinal/Etapas_Parte2.SchDoc
TPs Viejos/TP Final - Grupo Marce/Placa/FiltroHPFinal/FiltroHPFinal.PrjPcb
TPs Viejos/TP Final - Grupo Marce/Placa/FiltroHPFinal/PlacaFiltroFinal.PcbDoc
TPs Viejos/TP Final - Grupo Mati/altium/archivosUsadosParaRuteo/altium_final.PrjPcb
TPs Viejos/TP Final - Grupo Mati/altium/archivosUsadosParaRuteo/filtroFinal.PcbDoc
TPs Viejos/TP Final - Grupo Mati/altium/etapa1.SchDoc
TPs Viejos/TP Final - Grupo Mati/altium/etapa2.SchDoc
TPs Viejos/TP Final - Grupo Mati/altium/etapa3.SchDoc
TPs Viejos/TP Final - Grupo Mati/altium/etapa4.SchDoc
TPs Viejos/TP Final - Grupo Mati/altium/etapa5.SchDoc
TPs Viejos/TP Final - Grupo Mati/altium/etapa6.SchDoc
TPs Viejos/TP Final - Grupo Mati/altium/filtroFinal-TC.SchDoc
TPs Viejos/TP Final - Grupo Mati/altium/filtroFinal.PrjPCB
