tc-grupo-4/TP--FINAL/(commit log)

2019-11-11 Agregue el diseño del tp de borrachella
2019-11-11 Corregi un par de cosasa
2019-11-12 Agregue los scripts de las celdas q vamos a usar
2019-11-15 Terminada de rutear
    [Esquemático.SchDoc, PCB.PcbDoc, PCB1.PcbDoc, Proyecto.PrjPCB, universal_flech.SchDoc]
2019-11-15 Agregue los overlay
    [PCB1.PcbDoc]
2019-11-15 Algunos TPs a pedido de Mati
    [Bode final.csv, Esquemático entero.SchDoc, Filtro Final.PcbDoc, Final_Filter.PrjPCB, FlescherTow.SchDoc, Gain.SchDoc, OutputLowpas.SchDoc, Repuesta al escalon.csv]
2019-11-16 Agregue las mediciones hechas en mi casa con el analog, no cumple el rango dinamico, todo lo demas cumple plantilla
    [Medicion Pasabanda 100mV.csv, Medicion Pasabanda 10mV.csv, Medicion Pasabanda 15mV.csv, Medicion Pasabanda 1V.csv, Medicion Pasabanda 20mV.csv, Medicion Pasabanda 500mV.csv, PCB1.PcbDoc]
2019-11-16 Un último TP viejo que no pude subir ayer
    [ConectoresAdicionales.SchDoc, Etapas_Parte1.SchDoc, Etapas_Parte2.SchDoc, FiltroHPFinal.PrjPcb, KHN1.xlsx, KHN2.xlsx, PlacaFiltroFinal.PcbDoc, etapaAacc.csv]
2019-11-17 agregue la medicion del filtro calibrado
    [Medición Filtro Calibrado.csv]
2019-11-17 Agregue imagenes
    [Medición Filtro Calibrado.csv]
2019-11-19 Informe hasta comienzo de Parte 2
    Algunas cosas necesito que me digan qué hicieron los chicos.
2019-11-21 Agreegue las fotos de las mediciones comparadas con la simulacion
    [Etapa1.csv, Etapa12.csv, Etapa123.csv, Etapa1234.csv, Etapa2.csv, Etapa3.csv, Etapa4.csv, Etapa5.csv]
2019-11-21 Agregue la ultima imagen
2019-11-21 Agregue la rta al escalon
    [Respuesta al Escalon.csv]
